alirezaaies/es-ac-load-cycler/docs/relay_on_duration_report.tex

% !TeX program = xelatex
% گزارش مرجع سامانه پایش و کنترل اتاق آزمون
\documentclass[12pt,a4paper,oneside]{report}

\input{report-config}

\begin{document}

\pagenumbering{alph}
\input{chapters/00-title}
\tableofcontents
\clearpage
\pagenumbering{arabic}

\input{chapters/01-overview}
\input{chapters/02-hardware-cubemx}
\input{chapters/03-software-architecture}
\input{chapters/04-drivers-and-modules}
\input{chapters/05-runtime-control}
\input{chapters/06-serial-protocol}
\input{chapters/07-code-audit}
\input{chapters/08-build-programming}
\input{chapters/09-verification-maintenance}
\input{chapters/10-application-function-reference}
\input{chapters/11-driver-function-reference}
\input{chapters/12-refactoring-details}
\input{chapters/13-generated-code-reference}
\input{chapters/14-diagnostic-led-test}
\input{chapters/15-ade7880-integration}
\input{chapters/16-ds18b20-stable-numbering}
\input{chapters/17-character-lcd-buttons}
\input{chapters/18-load-cycler}

\end{document}
