alirezaaies/es-ac-load-cycler/PROJECT_STATUS.md

# وضعیت توسعه و حافظه ادامه پروژه

آخرین به‌روزرسانی: ۱۱ مهر ۱۴۰۵ — 2026-10-03، منطقه زمانی Asia/Tehran.

این فایل حافظه عملیاتی کل پروژه است و در ریشه مخزن نگه‌داری می‌شود. باید در پایان هر نوبت تغییر کد، سخت‌افزار یا مستندات به‌روزرسانی شود. عامل انسانی یا هوش مصنوعی بعدی باید پیش از کار، این فایل را کامل بخواند. README معرفی و راه‌اندازی سریع است؛ این فایل تاریخچه تصمیم‌ها، وضعیت اعتبارسنجی و کارهای باز را نگه می‌دارد.

از تاریخ 2026-09-19 مخزن از یک پروژه صرفاً فریم‌ور به مخزن یکپارچه محصول تبدیل شده است. مسیرهای کوتاه فریم‌ور در بخش‌های تاریخی این فایل، مانند `Core/` و `Application/`، نسبت به `embedded/stm32f107/` تفسیر می‌شوند؛ `docs/`، `datasheets/` و `hardware/` نسبت به ریشه مخزن هستند.

## هدف ثابت پروژه

ساخت یک پایه فریم‌ور قابل استفاده مجدد برای STM32F107VCT6 که هم‌زمان با STM32CubeMX، Keil MDK و PlatformIO قابل توسعه باشد. تولید مجدد CubeMX نباید منطق محصول را پاک کند. محصول فعلی اتاق آزمون تجهیزات برودتی را پایش و کنترل می‌کند: ۳۲ حسگر دمای ایستگاه، دو حسگر دمای محیط، حسگر رطوبت آنالوگ HIH، مدار انرژی ADE7880، ارتباط RS-232 و خروجی‌های رله/SSR.

## قواعد غیرقابل نقض ادامه کار

1. منطق محصول در فایل‌های مستقل باقی بماند؛ فایل مولد فقط داخل USER CODE block تغییر کند.
2. ISR فقط کار ثابت و کوتاه انجام دهد؛ I/O مسدودکننده، محاسبه سنگین و Flash داخل ISR ممنوع است.
3. صفحه `0x0803F800` تا انتهای Flash متعلق به داده حسگر است و نباید لینک شود.
4. قالب سریال قدیمی بدون نسخه‌بندی و هماهنگی نرم‌افزار PC تغییر نکند.
5. هر تغییر باید با build مناسب و در صورت ارتباط با ظاهر، رندر PDF بررسی شود.
6. نتیجه کامپایل جای آزمون سخت‌افزاری را نمی‌گیرد.
7. در پایان هر نوبت، بخش «آخرین نوبت کار» و «کارهای باز» همین فایل به‌روزرسانی شود.
8. تمام APIهای عمومی جدید با Doxygen انگلیسی شامل هدف، پارامتر، خروجی و خطا مستند شوند؛ ثابت سخت‌افزاری باید واحد و علت داشته باشد.

## وضعیت جاری و نقطه تحویل برای ادامه فردا

این بخش مرجع نسخه فعال است؛ یادداشت‌های مراحل پیشین پایین فایل تاریخچه‌اند و ممکن است رفتار قدیمی را شرح دهند. تاریخ تحویل: ۱۱ مهر ۱۴۰۵، برابر با 2026-10-03؛ نوبت بعدی موردنظر کاربر: 2026-10-04.

### نتیجه تأییدشده امروز

- کاربر عملکرد منوها، نمایشگر، کلیدها، رله‌ها و خواندن/نمایش پارامترهای الکتریکی را روی برد تأیید کرد. مشکل نمایش خط تیره سخت‌افزاری بود و توسط کاربر حل شد؛ جزئیات قطعه یا سیم‌بندی معیوب اعلام نشده است.
- هر دو رله active-low هستند: PE1 نول و PE2 فاز؛ LOW=وصل، HIGH=قطع. نوشتن همزمان BSRR و سطح اولیه HIGH در adapter و CubeMX اعمال شده است.
- آخرین کامیت عملکردی پیش از تکمیل مستندات `6aa787e` است؛ مرجع ادامه همیشه HEAD نهایی همین مخزن روی `main` است. `origin` برای مخزن GitHub تنظیم است؛ عامل در این جلسه پوش انجام نمی‌دهد.
- ساخت تأییدشده: PlatformIO با `-Wall -Wextra -Werror`، Flash=16184 bytes و RAM=1056 bytes. دو آزمون واقعی ARM برای سیکل و مسیر الکتریکی موفق‌اند. تأیید سخت‌افزار، گزارش کاربر است؛ ابزار عامل به برد متصل نیست.
- گزارش مرجع `docs/relay_on_duration_report.pdf` و سورس همنام است؛ نسخه ۱.۱، ۹۷ صفحه A4. فصل ۱۸ مرجع برنامه فعال، فصل ۱۷ مرجع کتابخانه LCD و تست اولیه، فصل ۱۵ مرجع ADE و فصل ۱۶ مرجع کتابخانه دماست.

### توالی منو و اجرای تست

۱. بوت: Welcome و سپس www.agfaco.com هر کدام دو ثانیه؛ سپس صفحه اصلی Idle. تعداد پیش‌فرض صفر، روشن سه و خاموش دو ثانیه؛ خروجی‌ها قطع‌اند.
۲. نگه‌داشتن کلید ۳ روی PD11 به مدت سه ثانیه، تنظیم تعداد را باز می‌کند؛ ورود به تنظیمات تست جاری را متوقف و رله‌ها را قطع می‌کند.
۳. کلید ۱/PD9 افزایش و کلید ۲/PD10 کاهش می‌دهد. بازه تعداد ۰ تا ۱۰۰۰۰۰ و زمان روشن/خاموش ۰ تا ۳۰۰ ثانیه، هر دو سر شامل هستند و تغییرات مدولار دور می‌زنند.
۴. تک‌فشار یک واحد؛ نگه‌داشتن پس از ۵۰۰ ms با فاصله ۱۲۰ ms تکرار می‌کند. ۲۰ تغییر نخست شامل فشار اولیه یک‌واحدی، سپس پنج‌واحدی؛ فشار تازه شتاب را از ابتدا آغاز می‌کند. debounce فشار/رهاسازی ۳۰ ms است.
۵. فشار کوتاه کلید ۳ هنگام رهاسازی تأیید می‌شود: تعداد → زمان روشن → زمان خاموش → Settings saved. سه مقدار فقط در تأیید مرحله آخر یکجا از draft به settings اعمال می‌شوند.
۶. نگه‌داشتن کلید ۳ در هر مرحله تنظیمات همه تغییرات موقت را لغو می‌کند و تست با تنظیمات قبلی از سیکل یک شروع می‌شود؛ ادامه از وسط سیکل قبل وجود ندارد.
۷. فشار کوتاه بعد از پیام ذخیره، تست جدید را شروع می‌کند. تنظیمات در RAM هستند و پس از reset/قطع تغذیه به پیش‌فرض برمی‌گردند.
۸. هر سیکل ON سپس OFF است؛ شماره از ۱ تا تعداد بالا می‌رود، زمان هر مرحله معکوس است. بعد از آخرین OFF، خروجی‌ها قطع و Done نمایش داده می‌شود؛ شمارنده اضافه نمی‌شود.
۹. تعداد صفر تست ندارد؛ ON صفر هیچ پالس وصلی ندارد؛ OFF صفر فقط گذار سریع خروجی دارد و قطع مکانیکی زمان‌دار تضمین نمی‌شود؛ هر دو زمان صفر پایان فوری دارند.

### نمایش فعلی و محل تغییر آینده

```text
V230.1P9999T   1
A 12.3PF0.98*  3
```

- V و A یک رقم اعشار، P بدون اعشار، PF قدرمطلق با دو رقم اعشار؛ واحدهای واقعی V/A/W و فاز پیش‌فرض A است. مقادیر راست‌چین‌اند. `*` وصل و `-` قطع؛ زمان سه‌رقمی و شماره سیکل افزایشی است.
- شماره‌های بزرگ‌تر از ۹۹۹۹ به‌شکل شش‌رقمی در ستون راست دو سطر تقسیم می‌شوند؛ `T0010` و `C 00` یعنی ۰۰۱۰۰۰. ادامه شماره هر دو ثانیه با زمان/Done نوبتی می‌شود؛ ستون‌های اندازه‌گیری ثابت می‌مانند.
- اعداد بزرگ با کاهش اعشار و سپس k/M/G فشرده می‌شوند. `--` داده نامعتبر/کهنه/ارتباط قطع است؛ صفر معتبر به‌صورت عدد نمایش داده می‌شود.
- تغییر ظاهر: `Application/Src/ui_counter.c`، تابع `compose()` ساخت دو سطر و `number()` قالب عدد. گزینه‌ها در `Application/Inc/cycler_config.h`؛ نام ui_counter تاریخی است ولی اکنون برنامه کامل سیکل را دارد.
- PA6=E، PA7=RW، PA8=RS، PA9..PA12=D4..D7. کلیدها active-high هستند. PC13/PC14 همواره یکی‌درمیان کار می‌کنند، حتی در خطای ADE.

### مسیر پردازش و متغیرهای Watch

- `main.c` فقط HAL/CubeMX و App را اجرا می‌کند؛ منطق محصول در Application است. همه کتابخانه‌ها حفظ شده‌اند؛ دما قبلاً توسط کاربر آزموده شده ولی در کاربرد فعلی `CYCLER_ENABLE_TEMPERATURE=0` است. رطوبت و UART به این کاربرد وصل نیستند.
- ADE: PB12=CS و PB13/PB14/PB15=SPI2؛ Mode 3، نرخ 562.5 kbit/s. همه فازها و نول هر ثانیه خوانده می‌شوند؛ retry دو ثانیه، انتقال HAL polling با سقف ۲۰ ms و startup ماشین حالت است. LCD مکث میکروثانیه‌ای لازم دارد؛ معماری cooperative است، نه تضمین زمان واقعی سخت.
- برای فاز A: `g_app_electrical.voltage_v[0]`، `current_a[0]`، `active_power_w[0]`، `power_factor_abs[0]`؛ PF علامت‌دار در `power_factor[0]`. اندیس ۱ و ۲ فاز B و C هستند.
- تشخیص ارتباط: `online`، `successful_samples`، `updated_at_ms`، `last_status`، `last_error_status`، `startup_attempts`، `startup_errors`، `startup_stage`، `failed_startup_stage` و `communication_errors` زیر `g_app_electrical`؛ جزئیات در LOAD_CYCLER.md و فصل ۱۸.
- نمایش عدد نیازمند online، نمونه جدیدتر از سه ثانیه و پرچم اعتبار هر کمیت است. آخرین خطا پس از موفقیت پاک نمی‌شود؛ برای وضعیت جاری، online و شمار نمونه‌ها هم بررسی شوند.
- ضرایب کالیبراسیون و صفحه رزروشده نگاشت دما در Flash حفظ شدند؛ تأیید کارکرد فعلی معادل تأیید دقت آزمایشگاهی همه کانال‌ها نیست.

### شروع نوبت بعد و کارهای باز

۱. ابتدا همین بخش و فصل ۱۸ گزارش را بخوانید؛ کارکرد فعلی روی برد تأیید شده و نیازی به بازسازی منو از ابتدا نیست.
۲. کار بعدی احتمالی تغییر ظاهر است؛ منتظر طرح/درخواست کاربر بمانید و سپس compose/number یا ثابت‌های نمایش را اصلاح کنید. رفتار منو و رله را بدون درخواست تغییر ندهید.
۳. بعد از تغییر ظاهر، آزمون‌های ARM و build را اجرا و خروجی مورد انتظار LCD را با طرح جدید هماهنگ کنید؛ سپس روی برد بررسی شود.
۴. موضوعات مستقل باقی‌مانده: ذخیره دائمی تنظیمات در صورت درخواست، کالیبراسیون ابزارمرجع کانال‌های استفاده‌شده، آزمون طولانی‌مدت، ساخت واقعی Keil و بررسی صنعتی watchdog/رفتار خطا. این‌ها مانع تأیید کارکرد فعلی نیستند و در این نوبت اجرا نشده‌اند.
۵. جزئیات رفع مشکل سخت‌افزار، نگاشت دقیق کانال‌ها و نتایج اندازه‌گیری دقت در صورت اعلام کاربر ثبت شوند؛ حدس جای نتیجه ثبت‌شده ننشیند.

### فایل‌ها و فرمان‌های اصلی

- راهنمای کوتاه: `embedded/stm32f107/LOAD_CYCLER.md`؛ وضعیت ادامه: همین فایل؛ گزارش کامل: `docs/relay_on_duration_report.tex` و PDF همنام.
- ساخت: `& "$env:USERPROFILE/.platformio/penv/Scripts/platformio.exe" run -d embedded/stm32f107`.
- آزمون‌ها: `python embedded/stm32f107/tests/test_cycler.py` و `python embedded/stm32f107/tests/test_electrical.py`؛ نیازمند Python unicorn و ARM GCC نصب‌شده PlatformIO.
- گزارش: دو گذر XeLaTeX از پوشه docs؛ رندر صفحات و بازبینی ظاهر پس از تغییر گزارش.

## Historical handoff before the load-cycler application

The following snapshot is preserved as history; use the current handoff above.

## وضعیت جاری نسخه نهایی این مرحله

### نقطه تحویل سریع

- شاخه فعال `main` است و baseline قابل ادامه همیشه commit رأس `HEAD` است؛ commit `44b330a` نقطه شروع ریفکتور ساده‌سازی این نوبت بود.
- مخزن remote ندارد و تا این نقطه چیزی به GitHub ارسال نشده است.
- مسیر ساده دما آماده است: برای حسگر شماره `N` فقط `g_temperature_valid[N-1]` و `g_temperature_c[N-1]` بررسی می‌شوند؛ هیچ تابعی نباید از Debugger فراخوانی شود.
- کشف نخست هنگام شروع، کشف‌های بعدی هر پنج ثانیه و ثبت ROM تازه در اولین شماره خالی خودکار است. نگاشت در Flash می‌ماند.
- نمایشگر ۲×۱۶ چهار بیتی روی `PA6..PA12` و سه کلید وقفه‌ای بدون جهش روی `PD9..PD11` پیاده‌سازی شده‌اند. تست شمارنده صفر تا صد فعال است و `g_ui_counter_value` در Watch دیده می‌شود.
- آخرین ساخت تأییدشده PlatformIO برابر `Flash=16560 bytes` و `RAM=3292 bytes` است. پروژه Keil از نظر XML و عضویت فایل‌های LCD معتبر است، ولی build همین نسخه با Keil هنوز روی ایستگاه دارای Keil تکرار نشده است.
- گزارش فنی این مرحله ۹۰ صفحه A4 است و فصل ۱۷ راه‌اندازی، API، debounce، انتقال و آزمون LCD را پوشش می‌دهد.
- کد و مستندات آماده آزمون روی برد هستند؛ سطح منطقی LCD پنج‌ولتی، عملکرد فیزیکی LCD/کلیدها، DS18B20، کالیبراسیون ADE7880 و DRC تازه هنوز باید تأیید شوند.

### شروع پیشنهادی نوبت بعد

1. ابتدا حاشیه سطح منطقی LCD بررسی شود: این مدل در ۵ ولت `VIH(min)=3.5V` دارد و خروجی ۳٫۳ ولتی STM32 تضمین‌شده نیست؛ مبدل سطح یا شرایط ۳٫۳ ولتی معتبر لازم است.
2. Firmware پروگرام و متن LCD، یک‌رخدادی‌بودن هر کلید، حدود صفر/صد، reset و نبود چشمک صفحه در کنار ادامه الگوی LED آزموده شود.
3. سپس سنسور شماره ۱ به‌تنهایی وصل شود؛ در Watch باید تقریباً پس از یک ثانیه `g_temperature_valid[0]=true` و `g_temperature_c[0]` معتبر شود.
4. سنسورهای بعدی یک‌به‌یک اضافه و خاموش/روشن کامل، پایداری شماره‌ها و تعویض یک سنسور روی همان bus ثبت شود.
5. پس از پذیرش مستقل رابط کاربر و دما، مرحله بعد از فهرست کارهای باز انتخاب شود.

### چیدمان مخزن یکپارچه

- ریشه Git: `E:/projects/es-ac-load-cycler` روی شاخه اصلی `main`؛ آخرین baseline عملکردی فعلی `44b330a` است. remote برای مخزن تعریف نشده و چیزی به GitHub ارسال نشده است.
- فریم‌ور STM32F107 در `embedded/stm32f107/` قرار دارد. تطبیق ۱۴۶ فایل انتقال‌یافته و `.gitignore` مربوط به زمان انتقال در تاریخچه ثبت شده است؛ مخزن اکنون پس از افزوده‌شدن زیرسامانه دما در مجموع ۱۶۸ فایل track‌شده دارد.
- سخت‌افزار Altium: `hardware/altium/` شامل پروژه `PCB_Project.PrjPcb`، هفت شماتیک و PCB اصلی `MainPCB.PcbDoc`.
- مستندات محصول: `docs/` و دیتاشیت‌ها: `datasheets/` در ریشه مخزن.
- `PROJECT_STATUS.md` از پوشه فریم‌ور به ریشه منتقل شده، چون اکنون وضعیت نرم‌افزار، سخت‌افزار و ساختار کل محصول را ثبت می‌کند.
- مستندات و دیتاشیت‌ها فقط در `docs/` و `datasheets/` ریشه نگه‌داری می‌شوند؛ نسخه‌های تکراری زیر فریم‌ور پس از تطبیق فایل‌به‌فایل و SHA-256 حذف شده‌اند.
- `.gitignore` با ساختار تو‌در‌توی جدید هماهنگ است و خروجی‌های PlatformIO، Keil، LaTeX و QA را در هر عمق نادیده می‌گیرد. History، preview، log، گزارش تولیدی و وضعیت محلی Altium نیز وارد Git نمی‌شوند.
- فایل‌های اصلی Altium شامل `PrjPcb`، `SchDoc`، `PcbDoc`، `PcbLib` و `IntLib` در Git نگه‌داری می‌شوند؛ وابستگی‌های کتابخانه‌ای محیط طراحی توسط مالک سخت‌افزار مدیریت می‌شوند.

### نتیجه ممیزی انتقال

- مخزن قدیمی در `E:/projects/RelayOnDuration/embedded/software/Main/Main` فقط مرجع تاریخی زمان انتقال با commit `06a2a2f` است؛ ادامه کار باید منحصراً در مخزن یکپارچه فعلی انجام شود.
- هیچ مخزن Git تودرتویی داخل `embedded/` یا `hardware/` وجود ندارد؛ تنها `.git` معتبر در ریشه پروژه جدید است.
- build PlatformIO پس از ریفکتور رابط زیرسامانه دما با `-Wall -Wextra -Werror` موفق شد: ۱۴۹۲۸ بایت Flash و ۳۲۰۴ بایت RAM.
- `pio` در PATH نیست، اما executable محلی `%USERPROFILE%/.platformio/penv/Scripts/platformio.exe` موجود و قابل استفاده است.
- پروژه Altium همه هفت `SchDoc` و فایل `MainPCB.PcbDoc` اصلی را پیدا می‌کند، اما self-contained نیست: ارجاع‌های `../../ADE7880/ADE7880ACPZ.PcbLib`، `../../ADE7880/ADE7880ACPZ.SchLib` و `../lib/PCB_Project.SCHLIB` در مخزن موجود نیستند. چند کتابخانه دیگر نیز از مسیر بیرون مخزن روی همین سیستم resolve می‌شوند و روی سیستم دیگر تضمین‌شده نیستند.
- آخرین گزارش DRC موجود با تاریخ 2026-09-12 دارای ۵ violation است: دو clearance با فاصله 0.19 mm در برابر حد 0.2 mm و سه Net Antennae. این گزارش مسیر مطلق قدیمی `E:/projects/new/hardware/VER3/EDIT1/MainPCB.PcbDoc` را در خود دارد و باید پس از بازکردن پروژه از محل جدید دوباره تولید شود.
- پوشه‌های `History`، `__Previews` و `Project Logs...` خروجی/حافظه محلی Altium هستند؛ روی دیسک باقی می‌مانند ولی در `.gitignore` پوشش داده شده‌اند و نباید وارد commit شوند.
- فایل `hardware/altium/MainPCB.PcbLib` صفر بایت است؛ چون `MainPCB1.PcbLib` و `PcbLib1.PcbLib` نیز موجودند، حذف یا جایگزینی آن بدون بررسی داخل Altium مجاز نیست.

- مسیر اجرایی فعال عمداً کوچک است: `Core/Src/main.c` فقط HAL/CubeMX را راه می‌اندازد و `App_Init()` و `App_Process()` را فراخوانی می‌کند.
- `Application/Src/app.c` adapter برد برای ADE7880 و DS18B20 است و پایه‌ها، زمان، Flash، نمونه‌برداری، کالیبراسیون و وضعیت قابل مشاهده در دیباگر را مدیریت می‌کند.
- `Application/Src/diagnostic_led.c` روی PC13/PC14 بدون توقف حلقه، زنده‌بودن برنامه یا خطای ارتباط ADE7880 را نشان می‌دهد.
- `Libraries/ADE7880` یک درایور مستقل از MCU است؛ انتقال SPI، CS و delay فقط از callback دریافت می‌شوند و نمونه سراسری داخل کتابخانه وجود ندارد.
- `Libraries/OneWire`، `Libraries/DS18B20` و `Libraries/DS18B20Manager` مستقل از HAL هستند؛ Search ROM، CRC، فرمان حسگر، شماره‌گذاری پایدار و ماشین حالت خواندن را فراهم می‌کنند.
- گذرگاه دمای صفر روی `PB10` و گذرگاه یک روی `PC7` است. نگاشت شماره منطقی ۱ تا ۳۲ به زوج bus/ROM با CRC32 در صفحه رزروشده Flash نگه‌داری می‌شود.
- `g_temperature_c[N-1]` و `g_temperature_valid[N-1]` رابط ساده Watch سنسور شماره `N` هستند؛ ساختار مدیر و APIهای تعمیراتی از هدر عمومی برنامه پنهان‌اند.
- `g_app_electrical` رابط اصلی Watch است. اندیس‌های `0`، `1` و `2` به‌ترتیب فازهای A، B و C هستند؛ جریان نول فیلد مستقل دارد.
- همه‌ی فازها برای ولتاژ RMS، جریان RMS، توان اکتیو، توان ظاهری و PF خوانده می‌شوند. جدول پیش‌فرض A/B/C/N در ابتدای `Application/Src/app.c` قرار دارد.
- کالیبراسیون هر کمیت و هر فاز مستقل است. `App_Init()` همیشه پیش‌فرض‌ها را نصب می‌کند؛ تغییرهای runtime فقط در RAM هستند و پس از reset از بین می‌روند.
- خواندن مستقل دمای DS18B20 اکنون فعال است؛ رطوبت، UART، کنترل محصول و اتصال دما به قاب سریال هنوز به snapshot اجرایی وصل نیستند. تاریخچه پایین فایل نباید با کد فعال اشتباه شود.
- `docs/relay_on_duration_report.tex` و PDF همنام آن مرجع کامل ساخت، پروگرام، تست و کالیبراسیون هستند.

## تصمیم‌های فنی ثبت‌شده

- اتصال ADE7880: `PB12=CS`، `PB13=SCK`، `PB14=MISO` و `PB15=MOSI`. رابط SPI2 در Mode 3، هشت‌بیتی، MSB-first و با نرخ فعلی 562.5 kbit/s کار می‌کند.
- بازه‌ی خواندن عادی یک ثانیه و بازه‌ی تلاش مجدد پس از خطا دو ثانیه است. هر snapshot فقط پس از خواندن کامل به وضعیت عمومی منتشر می‌شود.
- PC13 و PC14 خروجی پوش‌پول کم‌سرعت و به‌طور پیش‌فرض LED فعال‌پایین هستند؛ `DIAGNOSTIC_LED_ACTIVE_LOW` قطب را تغییر می‌دهد.
- ضرایب A و B از نرم‌افزار قدیمی بازیابی شده‌اند. چون داده مرجع فاز C وجود نداشت، C موقتاً از ضرایب B/مشترک و نول از scale جریان فاز شروع می‌شود؛ این fallback تأیید دقت نیست.
- `valid` فقط موفقیت ارتباط و موجودبودن تبدیل را بیان می‌کند. `source` مشخص می‌کند ضریب `APP_CALIBRATION_DEFAULT` یا `APP_CALIBRATION_USER` است.
- مقادیر SI در آمپر، وات و ولت‌آمپر نگه‌داری می‌شوند. نمایش قدیمی به‌طور پیش‌فرض صدم‌آمپر و دهم‌وات است و با `App_SetDisplayUnits()` تغییر می‌کند.
- APIهای `App_SetPhaseCalibration()`، `App_CalibratePhaseMultiPoint()` و `App_CalibrateNeutralCurrentMultiPoint()` هر خانه را مستقل تغییر می‌دهند. `App_ResetCalibrationToDefaults()` همه‌ی overrideهای RAM را حذف می‌کند.
- جهت CT با `App_SetCurrentPolarity()` اصلاح می‌شود. تشخیص خودکار انجام نمی‌شود، چون توان منفی می‌تواند صادرات واقعی انرژی باشد.
- PlatformIO از board رسمی `eval_f107vc`، STM32Cube و J-Link استفاده می‌کند. Keil از پروژه‌ی `MDK-ARM/STM32F107.uvprojx` استفاده می‌کند.
- فایل قابل‌حمل پروژه Keil یعنی `.uvprojx` در Git است؛ فایل شخصی محیط کاربر یعنی `.uvoptx` عمداً ignore می‌شود. خروجی‌های `.pio`، Keil و LaTeX نیز ignore هستند و فقط PDF نهایی گزارش track می‌شود.
- DS18B20 با تغذیه خارجی سه‌سیمه فرض شده است؛ parasite power و strong pull-up پیاده نشده‌اند. زمان تبدیل ۱۲ بیت ۷۵۰ میلی‌ثانیه است، ولی انتظار آن با ماشین حالت انجام می‌شود.
- Search ROM نخست بلافاصله و سپس هر پنج ثانیه اجرا می‌شود. ROM تازه خودکار به اولین slot خالی می‌رود؛ جایگزینی خودکار صرفاً برای یک missing و یک ROM جدید روی همان bus مجاز است.
- ثبت خودکار یا تعویض Flash را فقط هنگام تغییر نگاشت می‌نویسد، نه در نمونه‌برداری عادی. فرمت قدیمی به‌سبب نداشتن شماره bus خودکار مهاجرت داده نمی‌شود.

## نوبت اول کار — بازآرایی پایه

انجام‌شده:

- خواندن همه سورس‌ها، IOC، پروژه Keil، map و build log قدیمی.
- انتقال منطق از main و فایل وقفه به app.
- تبدیل تایمرها به پرچم و اجرای کارها در حلقه اصلی.
- اصلاح دریافت UART و حذف دسترسی مستقیم و دوباره به هندلر.
- فشرده‌سازی ساخت قاب ۲۰۹ بایتی با آرایه و حلقه.
- اصلاح ذخیره آدرس‌ها، خروج از محدوده آرایه و خطر هم‌پوشانی Flash.
- افزودن linker script، PlatformIO و J-Link.
- رزرو IROM Keil تا اندازه 0x3F800 و افزودن فایل‌های جدید به پروژه.
- ایجاد گزارش اولیه، README و چک‌لیست آزمون.
- build موفق PlatformIO و ساخت PDF موفق.

## نوبت دوم کار — تکمیل مستندات و خوانایی

درخواست کاربر: فاصله خطوط بیشتر، تشریح کامل کد و توابع، کامنت‌گذاری معنادار و فایل وضعیت مستقل از README.

انجام‌شده در این نوبت:

- افزودن بسته `setspace` و افزایش فاصله خطوط متن گزارش به ۱٫۴۵.
- افزایش فاصله پاراگراف‌ها از ۵ به ۸ پوینت و فاصله سطرهای جدول به ۱٫۳۳.
- افزودن فصل مرجع کامل توابع لایه کاربرد شامل ورودی، خروجی، اثر جانبی، زمینه اجرا و محدودیت‌ها.
- افزودن فصل مرجع کامل ذخیره‌سازی، ADE7880، DS18B20، AM2315 و MAF.
- افزودن فصل جزئیات بازآرایی با مقایسه معماری پیش و پس از تغییر.
- افزودن فصل توابع تولیدی main، راه‌اندازی همه پیرامونی‌ها، MSP، ISR، فایل سامانه و startup.
- تکمیل کامنت‌های Doxygen در `app.h`، `sensor_address_store.h`، `ADE7880.h`، `DS18B20.h`، `AM2315.h` و `MAF.h`.
- افزودن توضیح توابع داخلی و بخش‌های حساس در فایل‌های پیاده‌سازی.
- ایجاد همین فایل مستقل `PROJECT_STATUS.md` و افزودن الزام به‌روزرسانی آن در هر نوبت.

## اعتبارسنجی ثبت‌شده در نوبت دوم

- ساخت تازه PlatformIO با موفقیت کامل شد: ۲۰۷۹۶ بایت Flash معادل ۷٫۹ درصد و ۱۲۴۰ بایت RAM معادل ۱٫۹ درصد.
- فایل‌های پروژه و تنظیمات Keil از نظر XML دوباره بررسی شدند و معتبرند؛ خود Keil در این محیط نصب نیست و build با کامپایلر Keil همچنان باید روی ایستگاه توسعه انجام شود.
- گزارش تازه با XeLaTeX در دو گذر ساخته شد: ۴۸ صفحه A4، بدون خطا، نویسه مفقود، ارجاع حل‌نشده یا اخطار overfull/underfull.
- همه ۴۸ صفحه ابتدا در چهار تماس‌برگ و سپس صفحه‌های شاخص شامل جلد، متن متراکم و فصل‌های مرجع در اندازه اصلی بازبینی شدند؛ برش متن، هم‌پوشانی، خرابی راست‌به‌چپ یا شکست نامناسب عنوان مشاهده نشد.
- متن فصل‌های تازه برای جلوگیری از واژه انگلیسی بدون `\lr{}` و نویسه اعشاری ناسازگار اسکن شد.
- آزمون‌های سخت‌افزاری زیر هنوز انجام نشده‌اند و نتیجه build به معنی تأیید رفتار روی برد نیست.

## نوبت سوم کار — نشانگر سخت‌افزاری زنده‌بودن

درخواست کاربر: استفاده از دو LED متصل به PC13 و PC14 برای رقص نور، آزمون پروگرام، مشاهده اجرای مداوم برنامه و تشخیص گیرکردن حلقه اصلی.

انجام‌شده:

- ثبت PC13 و PC14 در `STM32F107.ioc` با نام‌های `DEBUG_LED_1` و `DEBUG_LED_2`، خروجی پوش‌پول کم‌سرعت و سطح اولیه بالا.
- همگام‌سازی `MX_GPIO_Init` فعلی با تنظیم CubeMX برای جلوگیری از اختلاف تا زمان تولید مجدد.
- ایجاد ماژول مستقل `diagnostic_led.c/.h` با چهار حالت خاموش، ضربان، رقص و خطا.
- پیاده‌سازی زمان‌بندی کاملاً غیرمسدودکننده با `HAL_GetTick` و بدون `HAL_Delay`.
- فراخوانی `DiagnosticLed_Process` در ابتدای `App_Process`؛ توقف حلقه اصلی باعث ثابت‌شدن الگو می‌شود.
- انتخاب الگوی رقص به‌عنوان حالت عادی و تناوب سریع به‌عنوان الگوی `Error_Handler`.
- افزودن فایل ماژول به پروژه Keil؛ PlatformIO آن را از پوشه `Core/Src` به‌طور خودکار می‌سازد.
- افزودن فصل ۱۴ گزارش شامل اتصال، قطب فعال، API، الگوها، پروگرام J-Link و تفسیر آزمون.

اعتبارسنجی نرم‌افزاری این نوبت:

- ساخت PlatformIO موفق است: ۲۱۳۶۰ بایت Flash معادل ۸٫۱ درصد و ۱۲۴۸ بایت RAM معادل ۱٫۹ درصد.
- فایل‌های `STM32F107.uvprojx` و `STM32F107.uvoptx` از نظر XML معتبرند؛ build واقعی Keil هنوز در این محیط انجام نشده است.
- گزارش نهایی این نوبت در دو گذر XeLaTeX و در ۵۴ صفحه A4 ساخته شد؛ هیچ خطا، نویسه مفقود یا هشدار overfull/underfull ندارد.
- همه ۵۴ صفحه در تماس‌برگ و پنج صفحه تغییرکرده فصل چراغ در اندازه اصلی بازبینی شدند و نقص چیدمان مشاهده نشد.
- پروگرام واقعی با J-Link و SWD موفق بود: پروگرامر و STM32F107VC شناسایی شدند، ولتاژ مرجع ۳٫۳۲۵ ولت بود، Flash پاک، نوشته و Verify شد و میکرو در پایان Reset شد.
- مشاهده فیزیکی LEDها و تأیید قطب و ترتیب نور همچنان به بازخورد کاربر نیاز دارد.

## کارهای باز تاریخی پیش از تأیید نسخه سیکل

این فهرست متعلق به مرحله پیشین است؛ اولویت‌های فعال در بخش «شروع نوبت بعد و کارهای باز» ابتدای فایل آمده‌اند. کارکرد نمایشگر، کلیدها، رله‌ها و اندازه‌گیری اکنون توسط کاربر تأیید شده است؛ نتیجه آزمون‌های دقیق تعداد فشار، مدت طولانی یا دقت آزمایشگاهی هنوز جداگانه ثبت نشده است.

1. حاشیه منطقی LCD پنج‌ولتی اصلاح/تأیید و سپس توالی راه‌اندازی، کنتراست، سیم‌بندی `DB4..DB7` و نمایش پایدار متن روی برد آزموده شود.
2. هر کلید دست‌کم ۵۰ بار، نگه‌داشتن طولانی، حدود صفر/صد و reset آزموده شود؛ هم‌زمان ادامه چشمک LED، نمونه‌برداری ADE7880 و دما کنترل شود.
3. DS18B20 روی هر دو گذرگاه با سنسور و کابل واقعی آزموده شود: کشف، CRC، دمای مثبت/منفی، خاموش/روشن کامل و ثبات شماره‌ها.
4. شماره‌گذاری خودکار یک‌به‌یک و سناریوهای تعویض «یک missing/یک new» و حالت مبهم چند سنسور روی برد ثبت شوند. مقاومت pull-up و شکل موج دورترین سنسور با تعداد نهایی بررسی شود.
5. پنج violation گزارش DRC سخت‌افزار بررسی و پس از اصلاح یا waiver مستند، گزارش تازه از مسیر جدید تولید شود.
6. نگاشت واقعی ورودی‌های A/B/C/N روی برد با شماتیک یا تزریق کنترل‌شده تأیید شود؛ fallback فاز C و نول هنوز کالیبراسیون آزمایشگاهی نیست.
7. برای هر فاز مورد استفاده، ولتاژ، جریان، توان اکتیو و توان ظاهری با ابزار true-RMS/وات‌متر معتبر در دست‌کم سه نقطه اندازه‌گیری و با API چندنقطه‌ای کالیبره شوند.
8. خطای فاز CT نزدیک PF حدود 0.5 و خطای offset در بار کم بررسی شود. در صورت باقی‌ماندن خطای سیستماتیک، رجیسترهای phase/offset خود ADE7880 طبق دیتاشیت تنظیم شوند.
9. ضرایب تأییدشده با version و اعتبارسنجی در Flash ذخیره شوند یا پس از تثبیت سخت‌افزار به‌عنوان ثابت‌های startup جایگزین شوند؛ اکنون تغییرهای runtime پایدار نیستند.
10. آزمون ۲۴ ساعته، قطع/وصل ADE7880 و DS18B20، خاموش/روشن کامل برد، تغییر دما و تکرار بار کم/نامی/زیاد انجام شود.
11. پیش از کاربرد صنعتی، watchdog، ثبت علت خطا و رفتار ایمن خروجی‌ها طراحی و روی سخت‌افزار آزمایش شود.
12. برای CharacterLcd، منطق debounce، OneWire/DS18B20/manager و نیز تبدیل raw، برازش کالیبراسیون، sign-extension و خطاهای transport تست میزبان افزوده شود.
13. زیرسامانه‌های سریال، رطوبت و کنترل فقط هنگام تعریف مرحله بعد و با آزمون مستقل، یکی‌یکی به runtime برگردند.

## اطلاعاتی که برای ادامه بدون حدس لازم است

- شماتیک بخش ADE7880 و نگاشت دقیق کانال‌های A/B/C/N.
- مدل و نسبت CT/PT، مقدار burden و شبکه تقسیم/فیلتر هر ورودی.
- ولتاژ، جریان و توان نامی و بیشینه‌ی مجاز و این‌که اندازه‌گیری توان یک‌طرفه است یا دوطرفه.
- جدول اندازه‌گیری مرجع شامل raw میانگین و مقدار واقعی برای هر نقطه و هر فاز.
- تصمیم درباره محل نگه‌داری ضرایب نهایی: ثابت‌های firmware یا Flash قابل‌به‌روزرسانی.
- تعداد نهایی سنسورها روی هر bus، طول و توپولوژی کابل و ولتاژ pull-up برای پذیرش سخت‌افزاری مسیر دما.
- برای بازگرداندن قابلیت‌های قدیمی محصول: نام واقعی خروجی‌ها، محدودیت‌های ایمنی و مشخصات پروتکل PC.

## نوبت چهارم کار — ارتباط ADE7880 روی پایه تمیز

درخواست کاربر: بازیابی پایه‌های قدیمی، ثبت پایدار تنظیمات در CubeMX، ساخت کتابخانه مستقل و قابل استفاده مجدد، خواندن پارامترهای الکتریکی همراه با LED عیب‌یابی، گزارش کامل و commitهای مرحله‌ای.

انجام‌شده:

- ایجاد نخستین baseline مخزن با commit `fe4322c`؛ پیش از آن مخزن هیچ commit نداشت.
- اصلاح `.gitignore` برای حذف خروجی‌های PlatformIO/Keil/LaTeX و نگه‌داری عمدی PDF نهایی گزارش.
- بازیابی اتصال از فایل پشتیبان پروژه و سه منبع مستقل: `PB12=CS`، `PB13=SCK`، `PB14=MISO` و `PB15=MOSI`.
- تأیید تنظیم قدیمی و دیتاشیتی SPI2: master، 8-bit، MSB-first، CPOL بالا، CPHA لبه دوم، prescaler 64 و نرخ 562.5 kbit/s.
- ثبت SPI2 و پایه‌ها در `STM32F107.ioc` و همگام‌سازی `main.c` و MSP با خروجی مورد انتظار CubeMX.
- ثبت صریح `CLKPolarity=High` در `.ioc` تا تولید مجدد CubeMX حالت SPI صحیح را حفظ کند.
- بازنویسی `Libraries/ADE7880` بدون وابستگی به STM32 HAL و با callbackهای انتقال، CS و delay.
- افزودن وضعیت صریح خطا، timeout سراسری reset، verify نوشتن‌ها، سه پالس انتخاب SPI و کنترل `RSTDONE`.
- اصلاح خواندن PF با رجیسترهای مستقل `APF/BPF/CPF` به‌جای مسیر هارمونیک نامطمئن قدیمی.
- افزودن snapshot کامل سه فاز و نول، sign-extension توان، تبدیل Q1.15 ضریب توان و API کالیبراسیون خطی دو نقطه‌ای.
- اتصال کتابخانه به HAL فقط در `Application/Src/app.c`، خواندن هر یک ثانیه و تلاش بازیابی هر دو ثانیه.
- انتشار وضعیت در `g_app_electrical` برای Watch در VS Code و Keil.
- حفظ LED رقص در حالت سالم و الگوی سریع در خطای ارتباط.
- ثبت commit پیاده‌سازی `d3806fe` پس از build موفق.
- حذف نوشتن تکراری و غیرضروری `CONFIG2` و ثبت اصلاح در commit `7545989`.
- افزودن فصل ۱۵ گزارش با مراحل CubeMX، VS Code، Keil، پروگرام، تست، عیب‌یابی، کالیبراسیون و خروجی مورد انتظار.

اعتبارسنجی نرم‌افزاری:

- build PlatformIO با `-Wall -Wextra -Werror` موفق شد: 8000 بایت Flash و 260 بایت RAM.
- فایل `STM32F107.uvprojx` از نظر XML معتبر است؛ build واقعی Keil در این محیط انجام نشد، چون Keil نصب نیست.
- گزارش در دو گذر XeLaTeX به‌صورت ۶۴ صفحه A4 ساخته شد و لاگ نهایی هیچ خطای ساخت، نویسه مفقود، ارجاع حل‌نشده یا هشدار overfull/underfull ندارد.
- همه ۶۴ صفحه در چهار تماس‌برگ و صفحه‌های فصل ۱۵ در وضوح بالاتر بازبینی شدند؛ برش، هم‌پوشانی، شکست بد جدول یا خرابی راست‌به‌چپ مشاهده نشد.
- پروگرام یا آزمون فیزیکی ADE7880 در این نوبت انجام نشد؛ ادعای صحت سخت‌افزار یا کالیبراسیون وجود ندارد.

اطلاعات/آزمون‌های لازم برای تکمیل این مرحله:

1. نسبت CT/PT، مقدار burden و شبکه تقسیم ولتاژ هر کانال.
2. تأیید اینکه RESET و IRQ1 به میکرو وصل‌اند یا خیر و در صورت اتصال، شماره پایه‌ها.
3. پروگرام برد و گزارش `online`، `die_version` و چند snapshot خام بدون ورودی و با منبع مرجع.
4. کالیبراسیون جداگانه فازها و آزمون نقطه سوم مستقل.
5. build پروژه با Keil و ثبت warning/error و اندازه نهایی.

## نوبت پنجم کار — مستندسازی کد و خروجی مستقیم ولتاژ

درخواست کاربر: کامنت‌های انگلیسی منظم برای فهم مستقیم کد، مثال روشن استفاده از کتابخانه و آماده‌بودن برنامه برای نمایش ولتاژ پس از اتصال ورودی.

انجام‌شده:

- تکمیل Doxygen انگلیسی همه enumها، ساختارها، callbackها و توابع عمومی ADE7880 با توضیح پارامتر، خروجی و خطا.
- افزودن توضیح انگلیسی کنار رجیسترها، ثابت‌های زمانی، واحد ضرایب و مراحل غیر بدیهی پیاده‌سازی.
- مستندسازی مشابه API برنامه و ماژول LED و افزودن کامنت نقاط اتصال در `main.c`.
- افزودن `Libraries/ADE7880/README.md` شامل توالی استفاده، مثال انتقال به پروژه دیگر، کالیبراسیون و تفسیر statusها.
- بازیابی ضریب قدیمی ولتاژ از سورس پشتیبان: پایه `0.00055963 V/count` و اصلاح `1.017` برای فاز A.
- انتشار `voltage_v`، `voltage_valid` و `voltage_source` در `g_app_electrical`.
- فعال‌سازی ضریب قدیمی فقط برای فازهای A/B؛ فاز C عمداً تا دریافت کالیبراسیون معتبر نامعتبر باقی می‌ماند.
- افزودن `App_SetVoltageCalibration()` برای جایگزینی ساده ضریب هر فاز با نتیجه کالیبراسیون دو نقطه‌ای.
- افزودن `ADE7880_ApplyLinearCalibration()` برای تبدیل واضح یک مقدار خام و تغییر `ADE7880_Convert()` به تابع دارای status.
- ثبت تغییر کد در commit `7f37da1`.

اعتبارسنجی این نوبت:

- build PlatformIO با `-Wall -Wextra -Werror` موفق شد: 9400 بایت Flash و 304 بایت RAM.
- گزارش در دو گذر XeLaTeX به ۶۷ صفحه A4 رسید؛ لاگ فاقد خطای ساخت، نویسه مفقود و هشدار overfull/underfull است.
- هر ۶۷ صفحه در تماس‌برگ و همه صفحه‌های تغییرکرده فصل ۱۵ در وضوح بالاتر بازبینی شدند؛ شکست کد، هم‌پوشانی یا برش متن مشاهده نشد.
- تبدیل A/B در نرم‌افزار آماده است، ولی صحت عدد ولتاژ باید روی همین برد با مولتی‌متر یا کالیبراتور مرجع تأیید شود.
- پروگرام فیزیکی و اعمال ولتاژ در محیط این نوبت انجام نشد.

## نوبت ششم کار — رفع خطای ساخت Keil

درخواست کاربر: بررسی خطاهای متعدد Keil که از ناشناخته‌بودن نوع `DMA_HandleTypeDef` در هدرهای HAL آغاز می‌شدند.

تشخیص و اصلاح:

- نخستین خطای واقعی در `stm32f1xx_hal_i2c.h`، `stm32f1xx_hal_spi.h`، `stm32f1xx_hal_tim.h` و `stm32f1xx_hal_uart.h` مشترک بود؛ خطاهای بعدی آبشاری بودند.
- فایل پیاده‌سازی `stm32f1xx_hal_dma.c` از قبل در پروژه Keil حضور داشت، اما `HAL_DMA_MODULE_ENABLED` در `Core/Inc/stm32f1xx_hal_conf.h` غیرفعال بود.
- تعریف `HAL_DMA_MODULE_ENABLED` فعال شد تا `DMA_HandleTypeDef` پیش از handleهای I2C/SPI/TIM/UART تعریف شود. این وابستگی نوع در HAL است و به معنی فعال‌شدن انتقال DMA در منطق فعلی برنامه نیست.
- لاگ موقت ساخت Keil به `.gitignore` افزوده شد؛ خروجی اجرایی و فایل‌های میانی Keil همچنان وارد مخزن نمی‌شوند.

اعتبارسنجی این نوبت:

- ساخت واقعی `MDK-ARM/STM32F107.uvprojx` با Keil و Arm Compiler 6.24 موفق شد: `0 Error(s), 0 Warning(s)`.
- اندازه گزارش‌شده Keil: `Code=8972`، `RO-data=476`، `RW-data=12` و `ZI-data=1292` بایت.
- فایل HEX با موفقیت تولید شد.
- تغییر محلی کاربر در `Core/Src/main.c` و بازنویسی‌های محلی `STM32F107.uvoptx` و `STM32F107.uvprojx` حفظ شدند و جزو اصلاح این نوبت نیستند.
- پروگرام فیزیکی برد و آزمون ولتاژ در این نوبت انجام نشد؛ نتیجه بالا فقط زنجیره کامپایل و لینک Keil را تأیید می‌کند.

## نوبت هفتم کار — نمایش جریان، توان و ضریب توان در Watch

بازخورد کاربر: ارتباط و خواندن ولتاژ روی برد واقعی و با یک لامپ به‌عنوان بار موفق بود، اما جریان، توان و ضریب توان به‌صورت مستقیم در `g_app_electrical` دیده نمی‌شدند.

تشخیص:

- درایور از قبل `AIRMS/BIRMS/CIRMS`، `AWATT/BWATT/CWATT`، `AVA/BVA/CVA` و `APF/BPF/CPF` را در هر snapshot می‌خواند.
- مقادیر خام در `g_app_electrical.raw.phase[0..2]` موجود بودند، اما لایه برنامه فقط ولتاژ کالیبره‌شده را به فیلدهای مستقیم Watch منتقل می‌کرد.
- PF قالب ثابت Q1.15 دارد و بدون ضریب سخت‌افزار به بازه ۱- تا ۱+ تبدیل می‌شود. آمپر و وات به مدار ورودی، CT و burden وابسته‌اند و بدون کالیبراسیون برد نمی‌توان برای آن‌ها ضریب عمومی معتبر ساخت.

انجام‌شده:

- افزودن `current_a`، `active_power_w`، `apparent_power_va`، `power_factor` و `neutral_current_a` همراه با پرچم اعتبار متناظر به `App_ElectricalState`.
- تبدیل خودکار PF پس از هر snapshot کامل؛ اندیس‌های ۰، ۱ و ۲ همواره متناظر فازهای A، B و C هستند.
- افزودن `App_SetPhaseCalibration()` برای ولتاژ RMS، جریان RMS، توان اکتیو و توان ظاهری هر فاز.
- افزودن `App_SetNeutralCurrentCalibration()` برای جریان نول و حفظ `App_SetVoltageCalibration()` به‌عنوان رابط سازگار قبلی.
- جلوگیری از نمایش عدد مهندسی ساختگی: جریان و توان تا نصب ضریب اندازه‌گیری‌شده، مقدار صفر و valid نادرست دارند؛ raw همیشه برای راه‌اندازی قابل مشاهده است.
- مستندسازی مثال کالیبراسیون دو نقطه‌ای و هشدار درباره نامناسب‌بودن توان اسمی چاپ‌شده روی لامپ به‌عنوان مرجع دقیق.
- ثبت تغییر کد در commit `25a4cea`.

اعتبارسنجی این نوبت:

- ساخت PlatformIO با `-Wall -Wextra -Werror` موفق شد: ۹۶۴۰ بایت Flash و ۴۷۲ بایت RAM.
- ساخت Keil با Arm Compiler 6.24 موفق شد: `0 Error(s), 0 Warning(s)`؛ اندازه‌ها `Code=9628`، `RO-data=476`، `RW-data=12` و `ZI-data=1460` بایت هستند.
- صحت تبدیل PF از Q1.15 با دیتاشیت رسمی ADE7880 تطبیق داده شد.
- برای تکمیل کالیبراسیون، raw و مقدار هم‌زمان ابزار مرجع در دو نقطه پایدار برای جریان و توان هر فاز لازم است.

## نوبت هشتم کار — رفع صفر بودن خروجی مهندسی جریان و توان

بازخورد کاربر: ولتاژ و رجیسترهای خام درست تغییر می‌کردند، اما `current_a` و خروجی‌های مهندسی توان صفر باقی می‌ماندند.

علت:

- مسیر SPI و خواندن رجیستر سالم بود؛ تغییر مقادیر `raw.phase[n]` این موضوع را تأیید می‌کرد.
- لایه برنامه فقط ضرایب قدیمی ولتاژ را در `App_Init()` بارگذاری می‌کرد و تبدیل جریان و توان تا دریافت کالیبراسیون جدید غیرفعال بود؛ بنابراین مقدار صفر همراه با valid نادرست رفتار عمدی نسخه قبل بود.

بازیابی و اصلاح:

- سورس پشتیبان اصلی در `embedded/software/backup/Main/Core/Src/stm32f1xx_it.c` بررسی شد.
- ضریب جریان فازهای A/B برابر `0.00036565 A/count` بازیابی شد.
- ضریب توان اکتیو A/B برابر `0.0170276 W/count` بازیابی شد؛ فاز A اصلاح `1.02` دارد.
- طبق دیتاشیت و AN-1171، توان‌های اکتیو و ظاهری هر فاز در ADE7880 gain-matched هستند؛ بنابراین همان ضریب power به‌صورت موقت برای VA نیز استفاده و منبع آن `APP_CALIBRATION_DERIVED` ثبت شد.
- enum عمومی `App_CalibrationSource` و source جداگانه برای ولتاژ، جریان، توان اکتیو، توان ظاهری و جریان نول اضافه شد.
- ضرایب مستقیم قدیمی با `APP_CALIBRATION_LEGACY` و ضرایب نصب‌شده توسط کاربر با `APP_CALIBRATION_USER` مشخص می‌شوند.
- فاز C و جریان نول به دلیل نبود ضریب قابل اثبات همچنان صفر و نامعتبر باقی می‌مانند.
- ثبت اصلاح کد در commit `2f33fa6`.

خروجی مورد انتظار پس از پروگرام:

- پس از نخستین snapshot موفق، `current_valid[0/1]`، `active_power_valid[0/1]` و `apparent_power_valid[0/1]` درست می‌شوند.
- `current_a[0/1]`، `active_power_w[0/1]` و `apparent_power_va[0/1]` همراه raw تغییر می‌کنند.
- source جریان و توان اکتیو `APP_CALIBRATION_LEGACY` و source توان ظاهری `APP_CALIBRATION_DERIVED` است.
- اندیس ۲ و جریان نول تا کالیبراسیون واقعی valid نادرست دارند.

اعتبارسنجی نرم‌افزاری:

- PlatformIO با `-Wall -Wextra -Werror` موفق شد: ۹۷۶۸ بایت Flash و ۴۸۴ بایت RAM.
- Keil با Arm Compiler 6.24 موفق شد: `0 Error(s), 0 Warning(s)`؛ اندازه‌ها `Code=9732`، `RO-data=476`، `RW-data=12` و `ZI-data=1468` بایت هستند.

- صحت عدد نهایی روی برد همچنان باید با آمپرمتر/وات‌متر مرجع کنترل و ضرایب legacy با کالیبراسیون USER جایگزین شوند.

## نوبت نهم کار — اصلاح واحدها و جهت CT

بازخورد آزمون کاربر: برای یک لامپ حدود ۲۰ وات، خروجی جریان نزدیک `17` و توان نزدیک `231` بود. با برعکس‌کردن مسیر CT علامت توان از منفی به مثبت و علامت PF برعکس شد.

تشخیص:

- تغییر علامت توان با وارونه‌شدن CT رفتار طبیعی است، چون بردار جریان ۱۸۰ درجه برمی‌گردد؛ RMS جریان و توان ظاهری نباید با جهت CT عوض شوند.
- علامت PF در ADE7880 فقط «خوب/بد» یا علامت توان نیست؛ اطلاعات پیش‌فاز/پس‌فاز جریان را نیز حمل می‌کند. یک لامپ LED با ورودی یکسوساز/خازنی می‌تواند PF علامت‌دار منفی داشته باشد، در حالی که توان مصرفی مثبت است.
- سورس قدیمی مقدارهای جریان و توان را در متغیرهای صحیح ۱۶‌بیتی و بسته ارتباطی قرار می‌داد. تطبیق آزمون واقعی نشان داد واحد خروجی قدیمی جریان `0.01 A` و واحد توان `0.1 W` بوده است؛ بنابراین `17` حدود `0.17 A` و `231` حدود `23.1 W` است.

اصلاح انجام‌شده:

- ضریب موقت جریان A/B از `0.00036565` واحد قدیمی به `0.0000036565 A/count` تبدیل شد.
- ضریب موقت توان A/B از `0.0170276` واحد قدیمی به `0.00170276 W/count` تبدیل شد؛ اصلاح `1.02` فاز A حفظ شد.
- `power_factor_abs[3]` افزوده شد تا بزرگی PF از صفر تا یک، مستقل از علامت پیش‌فاز/پس‌فاز، مستقیماً در Watch دیده شود.
- `current_polarity[3]` و API مستند `App_SetCurrentPolarity()` افزوده شدند. حالت `REVERSED` فقط علامت توان اکتیو و PF علامت‌دار را اصلاح می‌کند و به RMS جریان، VA و قدرمطلق PF دست نمی‌زند.
- تشخیص خودکار جهت CT عمداً انجام نشد، زیرا در سامانه دوطرفه توان منفی می‌تواند صادرات واقعی باشد. جهت یک‌بار هنگام commissioning تعیین می‌شود.
- تغییر کد در commit `815a5f5` ثبت شد؛ تغییرهای محلی کاربر در `main.c` و فایل‌های پروژه Keil وارد commit نشدند.

روش تست بعد از پروگرام:

1. برای بار مصرفی، جهت CT را طوری قرار دهید که `active_power_w[phase]` مثبت باشد؛ در صورت وجود علامت، P1/K سمت منبع و P2/L سمت بار قرار می‌گیرد و اتصال ثانویه باید با شماتیک برد تطبیق داده شود.
2. اگر CT قابل جابه‌جایی نیست، پس از `App_Init()` یک‌بار polarity همان فاز را `APP_CURRENT_POLARITY_REVERSED` کنید.
3. برای قضاوت درباره بزرگی PF از `power_factor_abs` استفاده کنید؛ علامت `power_factor` برای تشخیص lead/lag حفظ شده است.
4. `current_a` باید اکنون مستقیماً حدود `0.17 A` و `active_power_w` حدود `23.1 W` نشان دهد، ولی این‌ها هنوز ضرایب legacy هستند و باید با آمپرمتر و وات‌متر true-RMS مرجع در دو نقطه کالیبره شوند.
5. ثانویه CT هنگام عبور جریان اولیه هرگز باز نشود؛ تغییر سیم‌بندی فقط در حالت بی‌برق یا طبق روش shorting سازنده انجام شود.

اعتبارسنجی نرم‌افزاری:

- PlatformIO با `-Wall -Wextra -Werror` موفق شد: ۱۰۰۹۲ بایت Flash و ۵۰۰ بایت RAM.
- Keil با Arm Compiler 6.24 موفق شد: `0 Error(s), 0 Warning(s)`؛ اندازه‌ها `Code=9732`، `RO-data=476`، `RW-data=12` و `ZI-data=1468` بایت هستند.

## نوبت دهم کار — واحد نمایش قابل تنظیم و کالیبراسیون چندنقطه‌ای

درخواست کاربر: حفظ نمایش قدیمی صدم‌آمپر و دهم‌وات به‌عنوان پیش‌فرض قابل تغییر و فراهم‌کردن کالیبراسیون ساده ولتاژ، جریان و توان در بازه وسیع.

تصمیم فنی:

- فیلدهای SI با نام‌های `current_a`، `active_power_w` و `apparent_power_va` برای محاسبات حفظ شدند تا واحد پنهان یا مبهم وارد منطق برنامه نشود.
- فیلدهای مستقل `current_display`، `active_power_display` و `apparent_power_display` اضافه شدند. پیش‌فرض‌ها به‌ترتیب `100 unit/A` و `10 unit/W` هستند؛ در نتیجه `0.17 A` به‌شکل `17` و `23.1 W` به‌شکل `231` دیده می‌شود.
- ثابت‌های `APP_DEFAULT_CURRENT_DISPLAY_UNITS_PER_AMP` و `APP_DEFAULT_POWER_DISPLAY_UNITS_PER_WATT` در `app.h` و تابع runtime به نام `App_SetDisplayUnits()` امکان تغییر آسان را می‌دهند.
- براساس AN-1171 مسیر ADE7880 خطی در نظر گرفته شد. به‌جای ضرایب قطعه‌ای کم‌بار/پربار که می‌توانند در مرز پرش بسازند، یک خط gain/offset با کمترین‌مربعات روی همه نقاط برازش می‌شود.
- ساختار `ADE7880_CalibrationPoint` و تابع قابل‌حمل `ADE7880_CalculateLinearCalibrationMultiPoint()` افزوده شدند. تابع حداقل دو نقطه می‌پذیرد، سه تا پنج نقطه توصیه می‌شود و بیشترین residual را در واحد مرجع گزارش می‌کند.
- تابع کاربردی `App_CalibratePhaseMultiPoint()` همان برازش را برای ولتاژ RMS، جریان RMS، توان اکتیو یا توان ظاهری نصب می‌کند و `scale/offset` نهایی را برای ذخیره بعدی برمی‌گرداند.
- برای CT با polarity نرم‌افزاری معکوس، تابع کالیبراسیون علامت ضرایب توان اکتیو را داخلی هماهنگ می‌کند؛ reference همواره مقدار نهایی مورد انتظار است.
- طبق راهنمای رسمی، gain برای هر دستگاه لازم است؛ phase برای CT به‌ویژه در PF پایین و offset برای دقت گسترده در بار کم باید جداگانه ارزیابی شوند. اگر residual کم‌بار سیستماتیک بماند، مرحله بعد اصلاح رجیسترهای offset خود ADE7880 است، نه افزودن پرش قطعه‌ای.

روش پیشنهادی برداشت نقاط:

1. در هر نقطه پس از پایداری، چندین نمونه raw میانگین و مقدار هم‌زمان ابزار مرجع ثبت شود.
2. برای ولتاژ سه نقطه در پایین، نامی و بالای بازه کاری؛ برای جریان/توان دست‌کم کم‌بار، میانی و نزدیک بیشینه مجاز انتخاب شود.
3. برای gain توان از بار مرجع پایدار با PF معلوم استفاده و phase CT در آزمون جداگانه نزدیک PF=0.5 بررسی شود.
4. `max_abs_error` و یک یا دو نقطه مستقلِ خارج از نقاط برازش کنترل شوند.
5. پس از تأیید، `scale/offset` بازگشتی در Flash/تنظیمات یا ثابت‌های startup ذخیره و بعد از هر reset با `App_SetPhaseCalibration()` نصب شود.

اعتبارسنجی نرم‌افزاری:

- PlatformIO با `-Wall -Wextra -Werror` موفق شد: ۱۰۲۵۲ بایت Flash و ۵۴۴ بایت RAM.
- Keil با Arm Compiler 6.24 موفق شد: `0 Error(s), 0 Warning(s)`؛ اندازه‌ها `Code=9828`، `RO-data=476`، `RW-data=12` و `ZI-data=1532` بایت هستند.
- کد در commit `691fd79` ثبت شد و تغییرهای محلی کاربر در `main.c` و فایل‌های Keil وارد commit نشدند.

## نوبت یازدهم کار — پیش‌فرض کامل سه‌فاز و کالیبراسیون مستقل همه کانال‌ها

درخواست کاربر: یکسان‌شدن قاعده A/B/C، قابل‌استفاده‌بودن فاز C حتی پیش از کالیبراسیون نهایی، پیش‌فرض‌داشتن همه کمیت‌های پشتیبانی‌شده و حفظ سادگی برای کاربرد تک‌فاز، دو کانال مستقل و سه‌فاز.

ممیزی و تصمیم:

- درایور قابل‌حمل از قبل رجیسترهای ولتاژ RMS، جریان RMS، توان اکتیو، توان ظاهری و PF هر سه فاز را با جدول رجیستر و حلقه مشترک می‌خواند؛ نقص در لایه Application بود که فقط ضرایب A/B را فعال می‌کرد.
- همه ضرایب startup در یک جدول صریح `default_calibration` در ابتدای `Application/Src/app.c` قرار گرفتند. هر خانه دقیقاً `{scale, offset}` و مستقل از فازها و کمیت‌های دیگر است.
- مقادیر بازیابی‌شده A/B حفظ شدند. چون داده اندازه‌گیری‌شده C موجود نبود، ولتاژ و توان C موقتاً از B و جریان C از ضریب مشترک A/B شروع می‌شود. جریان نول نیز موقتاً همان scale جریان فازها را دارد.
- توان ظاهری هر فاز خانه مستقل دارد، ولی مقدار اولیه آن با توان اکتیو همان فاز برابر است. بعداً می‌توان VA را بدون تغییر W جداگانه کالیبره کرد.
- همه ضرایب startup با `APP_CALIBRATION_DEFAULT` و ضرایب نصب‌شده با `APP_CALIBRATION_USER` مشخص می‌شوند. `valid=true` فقط موفقیت تبدیل را نشان می‌دهد و تأیید دقت fallback نیست.
- `App_ResetCalibrationToDefaults()` همه overrideهای RAM را حذف و جدول کامل A/B/C/neutral را بازمی‌گرداند. `App_Init()` همین تابع را خودکار اجرا می‌کند.
- `App_CalibrateNeutralCurrentMultiPoint()` افزوده شد تا NIRMS نیز مانند کمیت‌های فاز، مسیر ساده و مستقیم کالیبراسیون چندنقطه‌ای داشته باشد.
- API فازی با پارامتر `ADE7880_Phase` ثابت ماند: تک‌فاز فقط A را مصرف می‌کند، دو کانال می‌توانند A/B را مستقل کالیبره کنند و سه‌فاز A/B/C را به‌کار می‌گیرد. تغییر یک خانه روی خانه دیگر اثر ندارد.
- خود کتابخانه هیچ نمونه سراسری از IC ندارد؛ پروژه قابل‌حمل می‌تواند برای چند ADE7880 چند `ADE7880_Device` مستقل با transport جدا بسازد.

رفتار مورد انتظار بعد از پروگرام:

1. پس از نخستین snapshot موفق، validهای ولتاژ، جریان، W و VA در اندیس‌های ۰، ۱ و ۲ و valid جریان نول درست می‌شوند.
2. source همه آن‌ها ابتدا `APP_CALIBRATION_DEFAULT` است.
3. کالیبراسیون یک کمیت/فاز فقط source همان خانه را `APP_CALIBRATION_USER` می‌کند.
4. reset سخت‌افزاری یا `App_ResetCalibrationToDefaults()` دوباره جدول startup را فعال می‌کند.
5. فاز C و نول پیش از استفاده اندازه‌گیری دقیق باید با مرجع واقعی کالیبره شوند؛ fallback فقط برای bring-up و توسعه آماده است.

اعتبارسنجی نرم‌افزاری:

- PlatformIO با `-Wall -Wextra -Werror` موفق شد: ۱۰۳۲۸ بایت Flash و ۵۴۴ بایت RAM.
- Keil با Arm Compiler 6.24 موفق شد: `0 Error(s), 0 Warning(s)`؛ اندازه‌ها `Code=9848`، `RO-data=580`، `RW-data=12` و `ZI-data=1532` بایت هستند.
- گزارش در دو گذر XeLaTeX به ۷۶ صفحه A4 ساخته شد؛ لاگ نهایی فاقد خطا، نویسه مفقود و هشدار overfull/underfull است.
- همه ۷۶ صفحه در چهار تماس‌برگ و صفحه‌های ۶۹ تا ۷۶ فصل تغییرکرده در اندازه بزرگ‌تر بازبینی شدند؛ برش، هم‌پوشانی، جدول شکسته یا خرابی راست‌به‌چپ مشاهده نشد.
- تغییر کد و راهنمای استفاده در commit `1a5ddb2` ثبت شد. تغییرهای محلی کاربر در `Core/Src/main.c` و فایل‌های پروژه Keil وارد commit نشدند.

## نوبت دوازدهم کار — ممیزی و تثبیت نهایی milestone سه‌فاز

درخواست کاربر: کنترل دوباره‌ی کامل فایل‌ها و Git، رفع موارد جاافتاده، نهایی‌کردن گزارش و ساخت یک نقطه‌ی ادامه که در نوبت بعد نیاز به توضیح طولانی گذشته نباشد.

یافته‌ها و اصلاح‌ها:

- درایور ADE7880 و لایه کاربرد از نظر تقارن A/B/C/N، استقلال ضرایب، مسیر تک‌فاز/دوکانال/سه‌فاز و APIهای نصب و برازش کالیبراسیون دوباره ممیزی شدند؛ نقص عملکردی تازه‌ای در خواندن رجیسترها پیدا نشد.
- یک رفتار گمراه‌کننده‌ی دیباگر اصلاح شد: پس از تغییر کالیبراسیون یا جهت CT، پرچم valid نادرست می‌شد اما مقدار SI/نمایش قبلی تا نمونه بعدی باقی می‌ماند. اکنون مقدار وابسته همان لحظه صفر و نمایش نیز تازه می‌شود.
- فصل معماری و فصل مرجع لایه کاربرد بازنویسی شدند تا فقط کد فعال فعلی، مسیرهای درست `Application` و APIهای واقعی را شرح دهند. فصل LED نیز با مسیرهای فعلی و وضعیت runtime هماهنگ شد.
- خلاصه بالای همین فایل از تاریخچه قدیمی جدا شد و اکنون baseline جاری، تصمیم‌های فنی، محدودیت کالیبراسیون و اولویت‌های واقعی مرحله بعد را ثبت می‌کند. بخش‌های نوبت‌های قبلی صرفاً تاریخچه‌اند.
- `.gitignore` برای فایل‌های سیستم‌عامل/ویرایشگر، پوشه موقت QA، خروجی‌های ساخت و فایل شخصی `MDK-ARM/*.uvoptx` تکمیل شد. فایل `.uvoptx` از index حذف شد، ولی نسخه محلی کاربر پاک نشد. فایل قابل‌حمل `.uvprojx` همچنان track می‌شود.
- اصلاح وضعیت runtime و بهداشت Git در commit `5b8fc02` ثبت شد.
- تنظیمات ضروری CubeMX دوباره کنترل شدند: `PB12=ADE_CS`، خطوط SPI2 روی PB13/PB14/PB15، Mode 3 و prescaler 64. فایل پروژه Keil نیز XML معتبر دارد.

اعتبارسنجی نهایی:

- PlatformIO با `-Wall -Wextra -Werror` موفق شد: ۱۰۳۷۲ بایت Flash و ۵۴۴ بایت RAM.
- Keil با Arm Compiler 6.24 موفق شد: `0 Error(s), 0 Warning(s)`؛ اندازه‌ها `Code=9848`، `RO-data=580`، `RW-data=12` و `ZI-data=1532` بایت هستند.
- گزارش در دو گذر XeLaTeX به ۷۶ صفحه A4 ساخته شد. لاگ نهایی فاقد خطا، هشدار، نویسه مفقود و overfull/underfull است.
- همه ۷۶ صفحه به تصویر تبدیل و در تماس‌برگ بازبینی شدند؛ فصل‌های معماری، مرجع API و LED در وضوح بالاتر نیز کنترل شدند و برش، هم‌پوشانی، خرابی جدول یا مشکل راست‌به‌چپ مشاهده نشد.
- `git diff --check` بدون خطاست و خروجی‌های build/LaTeX/QA در وضعیت Git ظاهر نمی‌شوند.

مرز اعتبار این نسخه:

- این ممیزی صحت ساخت، ساختار نرم‌افزار و مستندات را تأیید می‌کند. پروگرام مجدد این commit روی برد و کالیبراسیون آزمایشگاهی A/B/C/N در این نوبت انجام نشده است.
- نتیجه‌های سخت‌افزاری ثبت‌شده تا اینجا شامل ارتباط موفق ADE7880، مشاهده ولتاژ و پاسخ جریان/توان بار لامپی توسط کاربر است. پذیرش صنعتی منوط به انجام فهرست «کارهای باز و آزمون‌های مرحله بعد» در بالای همین فایل است.

## نوبت سیزدهم کار — انتقال به مخزن یکپارچه محصول

درخواست کاربر: ممیزی انتقال مخزن تمیز فریم‌ور به `es-ac-load-cycler`، بررسی ساختار تازه شامل سخت‌افزار، مستندات و دیتاشیت‌ها، گزارش وضعیت و به‌روزرسانی حافظه پروژه.

انجام‌شده:

- سلامت مرجع قدیمی و commit جاری کنترل شد؛ مخزن قدیمی بدون تغییر محلی است.
- ۱۴۷ فایل track‌شده با مقصد جدید تطبیق داده شدند؛ به‌جز جابه‌جایی `.gitignore` به ریشه، هر ۱۴۶ فایل منتقل‌شده در `embedded/stm32f107` از نظر SHA-256 با نسخه قدیمی یکسان است.
- ساخت PlatformIO از محل جدید اجرا و موفق شد؛ اندازه Flash و RAM با baseline قبلی یکسان است.
- ساختار و وابستگی‌های پروژه Altium، فایل‌های صفر بایت، حجم پوشه‌ها، خروجی DRC و ارجاع‌های مسیر مطلق بررسی شدند.
- محل همین فایل از پوشه فریم‌ور به ریشه مخزن تغییر کرد و لینک README فریم‌ور به محل جدید اصلاح شد.
- هیچ فایل تکراری، خروجی build یا History حذف نشد و هیچ فایل سخت‌افزاری تغییر نکرد؛ پاک‌سازی و انتخاب دقیق فایل‌های قابل track عمداً به مرحله بعد واگذار شد تا بدون تأیید، داده طراحی حذف نشود.

اعتبارسنجی این نوبت:

- `PlatformIO Core 6.2.0`: موفق، `Flash=10372 bytes` و `RAM=544 bytes`.
- تطبیق محتوای فریم‌ور منتقل‌شده: صفر فایل تغییرکرده و صفر فایل منبع مفقود؛ فقط `.gitignore` در ریشه جدید قرار دارد.
- پروژه Altium: هشت سند اصلی طراحی موجود؛ سه ارجاع کتابخانه‌ای داخل/نزدیک پروژه مفقود و چند وابستگی خارج مخزن موجود است.
- DRC ثبت‌شده: ۵ violation و نیازمند تولید مجدد از مسیر جدید.
- وضعیت Git در پایان این نوبت عمداً تمیز نیست، چون جابه‌جایی ساختار و سخت‌افزار جدید هنوز stage/commit نشده‌اند.

## نوبت چهاردهم کار — پاک‌سازی و ثبت ساختار یکپارچه

درخواست کاربر: نگه‌داری کامل منابع اصلی سخت‌افزار در Git، جلوگیری از ورود History و فایل‌های حجیم/بی‌ارزش، تطبیق `.gitignore` با مسیرهای جدید، حذف فایل‌های تکراری و ثبت یک commit معنادار.

انجام‌شده:

- `.gitignore` برای PlatformIO، VS Code، LaTeX، QA موقت و خروجی‌ها/وضعیت شخصی Keil در هر عمق بازنویسی شد.
- `hardware/altium/History/`، `__Previews/`، `Project Logs for */`، `Project Outputs for */`، فایل‌های `PrjPcbStructure` و lockهای Altium به‌طور صریح ignore شدند.
- فایل‌های اصلی طراحی Altium شامل پروژه، هفت شماتیک، PCB، کتابخانه‌های PCB و کتابخانه مجتمع برای ثبت در Git نگه‌داری شدند.
- ۲۶ فایل تکراری مستندات و یک دیتاشیت تکراری زیر `embedded/stm32f107/` پس از اثبات برابری نام و SHA-256 حذف شدند؛ نسخه‌های مرجع در ریشه باقی ماندند.
- README مخصوص مخزن در ریشه ساخته و README فریم‌ور با مسیرهای جدید `PROJECT_STATUS.md`، `docs/` و `datasheets/` هماهنگ شد.
- خروجی‌های محلی سنگین حذف نشدند و روی سیستم باقی ماندند، اما با `git check-ignore` تأیید شد که وارد commit نمی‌شوند.

اعتبارسنجی پیش از ثبت:

- build تازه PlatformIO از مسیر جدید موفق است: `Flash=10372 bytes` و `RAM=544 bytes`.
- `git diff --check` بدون خطاست.
- فهرست ignored برای نمونه‌های History، preview، log، DRC تولیدی، Keil object/log و `.pio` به‌صورت صریح کنترل شد.
- commit این مرحله با پیام `chore: organize unified firmware and hardware repository` ثبت شد.

## نوبت پانزدهم کار — ممیزی نهایی محلی پیش از انتشار

درخواست کاربر: توقف موقت انتشار در GitHub و کنترل دوباره READMEها، ساختار Git، build فریم‌ور و گزارش نهایی؛ هر اصلاح لازم باید در یک commit تمیز ثبت شود.

نتیجه ممیزی:

- شاخه اصلی محلی `main` است، working tree پیش از این ممیزی تمیز بود و هیچ remoteای تعریف نشده است؛ بنابراین هیچ داده‌ای به GitHub یا سرویس دیگری push نشده است.
- همه لینک‌های محلی Markdown در README ریشه، README فریم‌ور، README کتابخانه ADE7880، README گزارش و `PROJECT_STATUS.md` بررسی شدند و لینک شکسته‌ای پیدا نشد.
- مسیرهای README فریم‌ور برای `PROJECT_STATUS.md`، `docs/` و `datasheets/` با ساختار یکپارچه فعلی سازگارند.
- هیچ فایل untracked قابل‌مشاهده و هیچ فایل track‌شده‌ی مشمول `.gitignore` وجود ندارد. خروجی‌های ساخت و فایل‌های محلی سنگین همچنان فقط روی سیستم باقی می‌مانند و وارد Git نمی‌شوند.
- ارجاع مسیر قدیمی فقط در تاریخچه همین فایل برای ثبت منشأ انتقال باقی مانده است؛ سورس، تنظیمات ساخت و READMEها به مسیر قدیمی وابسته نیستند.

اعتبارسنجی این نوبت:

- PlatformIO از `embedded/stm32f107/` موفق شد: `Flash=10372 bytes` و `RAM=544 bytes`.
- گزارش با XeLaTeX در دو گذر بدون خطا ساخته شد: ۷۶ صفحه A4، بدون warning، نویسه مفقود، ارجاع حل‌نشده یا overfull/underfull.
- همه ۷۶ صفحه PDF در چهار تماس‌برگ و صفحه‌های شاخص شامل جلد، متن/کد متراکم و صفحه پایانی در اندازه اصلی بازبینی شدند؛ برش، هم‌پوشانی، خرابی جدول یا مشکل راست‌به‌چپ مشاهده نشد.
- `git diff --check` پیش از commit باید بدون خطا باشد.

مرز اعتبار:

- این نوبت build نرم‌افزار، بازتولید و ظاهر گزارش و سلامت ساختار مخزن را تأیید می‌کند. پروگرام مجدد برد، آزمون عملی خروجی‌ها، اجرای طولانی‌مدت و کالیبراسیون آزمایشگاهی در این نوبت انجام نشده‌اند؛ بنابراین سلامت صنعتی همچنان منوط به آزمون‌های سخت‌افزاری فهرست‌شده در بخش کارهای باز است.

## نوبت شانزدهم کار — DS18B20 قابل‌حمل با شماره‌گذاری پایدار

درخواست کاربر: استفاده از `PB10` و `PC7` برای تعداد دلخواه DS18B20، حفظ شماره نوشته‌شده روی سنسورها پس از قطع برق و تعویض، قابلیت انتقال کتابخانه به MCU دیگر، مشاهده دما در دیباگر، سازگاری PlatformIO/Keil/CubeMX و مستند آموزشی کامل.

انجام‌شده:

- `Libraries/OneWire` بدون وابستگی به HAL بازنویسی شد و callbackهای خط، تأخیر و critical section، زمان‌بندی استاندارد، Dallas CRC8 و Search ROM قطعی به آن افزوده شد.
- `Libraries/DS18B20` به لایه فرمان مستقل تبدیل شد: اعتبارسنجی family/ROM، Match/Skip ROM، Convert T، scratchpad با CRC، دمای signed، وضوح ۹ تا ۱۲ بیت و تابع ساده blocking برای پروژه‌های کوچک.
- `Libraries/DS18B20Manager` ساخته شد: حداکثر ۳۲ شماره روی چند bus، کشف مرتب و قابل مشاهده، جدول `logical slot -> bus + ROM`، ماشین حالت تبدیل غیرمسدودکننده و خواندن یک سنسور در هر دور حلقه.
- معرفی اولیه با `App_TemperatureAssignDiscovered()` و معرفی مستقیم با `App_TemperatureAssignRom()` انجام می‌شود. شماره انسانی `N` همیشه در `g_app_temperature.slots[N-1]` است.
- جایگزینی خودکار فقط در snapshot بدون ابهام، یعنی دقیقاً یک نگاشت غایب و یک ROM تازه روی همان bus، انجام می‌شود. در حالت چند غایب/چند تازه، تخصیص صریح لازم است.
- `SensorAddressStore` به رکورد opaque نسخه ۲ با payload، CRC32 و verify پس از write تبدیل شد. آخرین صفحه ۲ KiB از `0x0803F800` همچنان خارج linker است. نگاشت خراب، ROM نامعتبر، bus خارج محدوده و duplicate هنگام load پذیرفته نمی‌شوند.
- فرمت قدیمی به‌علت نداشتن شماره bus خودکار مهاجرت داده نمی‌شود؛ API خواندن آن فقط برای مهاجرت آگاهانه باقی مانده است.
- `PB10=ONE_WIRE_1` و `PC7=ONE_WIRE_2` در IOC و GPIO مولد به‌صورت open-drain، no-pull و سطح اولیه آزاد ثبت شدند. منطق محصول بیرون فایل‌های مولد و فراخوانی‌ها داخل USER CODE باقی ماندند.
- adapter برد در `Application/Src/app.c` از شمارنده سیکل Cortex-M3 برای تأخیر میکروثانیه، HAL tick برای زمان و صفحه Flash برای نگاشت استفاده می‌کند. دما مستقل از حضور ADE7880 پردازش می‌شود.
- پروژه‌های PlatformIO و Keil با include/source مدیر جدید همگام شدند. دیتاشیت `datasheets/ds18b20.pdf` به منابع پروژه افزوده شد.
- README ریشه، README فریم‌ور، راهنمای مستقل کتابخانه، فصل‌های قدیمی متناقض و فصل تازه ۱۶ گزارش برای اتصال، commissioning، تعویض، Watch، انتقال MCU، CubeMX و آزمون به‌روزرسانی شدند.

اعتبارسنجی این نوبت:

- ساخت واقعی PlatformIO با `-Wall -Wextra -Werror` موفق است: `Flash=14696 bytes` از ۲۵۶ KiB و `RAM=3040 bytes` از ۶۴ KiB.
- `STM32F107.uvprojx` از نظر XML معتبر است و `ds18b20_manager.c` و include متناظر را دارد؛ Keil در این محیط نصب نیست و build واقعی این نسخه در ایستگاه توسعه باقی مانده است.
- تنظیم‌های IOC و کد GPIO برای `PB10/PC7`، open-drain و سطح آزاد بررسی شدند.
- گزارش در دو گذر XeLaTeX بدون خطا، warning، نویسه مفقود و overfull/underfull ساخته شد: ۸۲ صفحه A4.
- همه ۸۲ صفحه در پنج تماس‌برگ و فصل ۱۶ و بخش مرجع درایور در اندازه اصلی بازبینی شدند؛ برش، هم‌پوشانی، متن مفقود یا اشکال راست‌به‌چپ دیده نشد.

مرز اعتبار:

- این نوبت معماری، ساخت GCC، فایل پروژه Keil و مستندات را تأیید می‌کند؛ سنسور واقعی به این محیط متصل نبود. کیفیت pull-up، timing روی کابل نهایی، ROMهای واقعی، دقت دما، سناریوی تعویض و پایداری ۲۴ ساعته باید روی برد طبق فهرست کارهای باز آزموده شوند.
- دما هنوز عمداً فقط در `g_app_temperature` منتشر می‌شود و به پروتکل سریال یا کنترل رله متصل نشده است تا مسیر خواندن و هویت ابتدا مستقل پذیرفته شود.

## نوبت هفدهم کار — ساده‌سازی کامل استفاده از DS18B20

بازخورد کاربر: آدرس سنسور در `discovered[0]` دیده می‌شد، اما نیاز به فراخوانی تابع از دیباگر نامفهوم و نامناسب بود. مسیر عادی باید برای یک، دو یا چند سنسور بدون عملیات دستی کار کند و رابط کد ساده باشد.

اصلاح انجام‌شده:

- گزینه `auto_assign_new` به مدیر قابل‌حمل افزوده و در این برد فعال شد. هر ROM تازه پس از کشف خودکار به اولین شماره خالی متصل و نگاشت آن فوراً در Flash ذخیره می‌شود.
- ترتیب تخصیص چند سنسور هم‌زمان قطعی است: ابتدا شماره bus و سپس ROM. برای هماهنگی با برچسب‌های فیزیکی، سنسورها فقط به‌ترتیب و یک‌به‌یک وصل می‌شوند؛ هیچ تابعی از دیباگر فراخوانی نمی‌شود.
- جست‌وجوی نخست بلافاصله بعد از بوت و جست‌وجوهای بعدی هر پنج ثانیه انجام می‌شوند. سنسور اول پس از کشف و نخستین تبدیل تقریباً در یک ثانیه مقدار معتبر می‌دهد.
- رابط ساده در `Application/Inc/app_temperature.h` جدا شد. برنامه معمول فقط با `g_temperature_c[]`، `g_temperature_valid[]`، `g_temperature_sensor_count` و `App_TemperatureGetCelsius()` کار می‌کند.
- ساختار `g_app_temperature` و APIهای کشف/تخصیص دستی حذف نشدند، اما صریحاً به‌عنوان ابزار پیشرفته تعمیر و تولید از مسیر معمول جدا شدند.
- README فریم‌ور، راهنمای کتابخانه، فصل‌های ۴، ۱۰ و ۱۶ گزارش و خلاصه جاری این فایل با رفتار خودکار هماهنگ شدند.

اعتبارسنجی نهایی:

- PlatformIO با `-Wall -Wextra -Werror` موفق است: `Flash=14932 bytes` و `RAM=3208 bytes`.
- فایل `STM32F107.uvprojx` از نظر XML معتبر است و سورس‌های مدیر دما را در گروه کتابخانه‌های قابل‌استفاده‌مجدد نگه می‌دارد؛ قالب‌بندی خواناتر همین گروه که در فایل محلی موجود بود نیز بدون تغییر معنایی حفظ شد.
- گزارش در دو گذر XeLaTeX بدون خطا، warning، نویسه مفقود و overfull/underfull ساخته شد: ۸۳ صفحه A4. همه صفحه‌ها در پنج تماس‌برگ و صفحات تغییرکرده در اندازه اصلی بازبینی شدند؛ برش، هم‌پوشانی یا اشکال راست‌به‌چپ دیده نشد.
- `git diff --check` و کنترل خروجی‌های موقت/نادیده‌گرفته‌شده پیش از commit انجام شد.
- آزمون روی سنسور فیزیکی همچنان باید توسط کاربر انجام شود: برای سنسور اول `g_temperature_valid[0]` باید پس از حدود یک ثانیه درست و `g_temperature_c[0]` قابل مشاهده شود.

## نوبت هجدهم کار — تثبیت نقطه تحویل برای ادامه آینده

درخواست کاربر: یک بررسی سریع نهایی و به‌روزرسانی حافظه پروژه، به‌طوری‌که در مراجعه بعدی محل توقف، کارهای انجام‌شده و قدم بعد بدون مرور دوباره کل تاریخچه روشن باشد.

انجام‌شده و بررسی‌شده:

- بخش «نقطه تحویل سریع» و «شروع پیشنهادی نوبت بعد» به ابتدای وضعیت جاری افزوده شد.
- ارجاع قدیمی baseline پیش از DS18B20 با baseline عملکردی فعلی `44b330a` جایگزین و تعداد فایل‌های track‌شده به ۱۶۸ اصلاح شد.
- روشن شد که مخزن قدیمی فقط مرجع تاریخی انتقال است و همه ادامه کار باید در `E:/projects/es-ac-load-cycler` انجام شود.
- وضعیت فایل‌های محلی Altium اصلاح شد: History، preview و log روی دیسک می‌مانند اما توسط `.gitignore` از Git خارج هستند.
- build تازه PlatformIO با `-Wall -Wextra -Werror` موفق شد: `Flash=14932 bytes` و `RAM=3208 bytes`.
- فایل پروژه Keil دوباره parse شد و XML معتبر است؛ build واقعی Keil همچنان روی ایستگاه دارای Keil باقی مانده است.
- PDF موجود دوباره از نظر مشخصات کنترل شد: ۸۳ صفحه A4 و ۲۸۶۶۹۸ بایت. در این نوبت PDF تغییر نکرد، چون محتوای گزارش فنی و فصل DS18B20 از نوبت قبل کامل و بازبینی‌شده بود.
- قواعد ignore برای خروجی PlatformIO و `hardware/altium/History/` به‌صورت عملی با `git check-ignore` تأیید شدند و `git diff --check` بدون خطاست.

محل دقیق توقف: نرم‌افزار و مستندات آماده‌اند؛ قدم بعدی، پروگرام همین baseline روی برد و اجرای بندهای ۱ و ۲ فهرست کارهای باز برای DS18B20 واقعی است. تا پیش از ثبت نتیجه این آزمون، اتصال دما به پروتکل سریال یا منطق کنترل توصیه نمی‌شود.

## نوبت نوزدهم کار — ممیزی تخصصی و کوچک‌سازی رابط دما

درخواست کاربر: بازبینی توابع و کتابخانه‌های نوشته‌شده با معیار API کم، خوانایی بالا، استفاده ساده در پروژه‌های دیگر، جلوگیری از منطق غیرضروری، مقاومت در برابر Generate Code کیوب، تکمیل کامنت‌ها، گزارش و commit.

نتیجه ممیزی و ریفکتور:

- هدر `app_temperature.h` از جزئیات مدیر مستقل شد و دیگر `ds18b20_manager.h` را include نمی‌کند. سطح عمومی برنامه از پنج تابع به فقط `App_TemperatureGetCelsius()`، دو آرایه مقدار/اعتبار و شمار هویت‌های ثبت‌شده کاهش یافت.
- نمونه مدیر از `g_app_temperature` عمومی به `temperature_manager` خصوصی در `app.c` تبدیل شد. wrapperهای تکراری کشف، تخصیص ROM، تخصیص discovery و پاک‌کردن حذف شدند؛ APIهای پیشرفته همچنان در خود کتابخانه مدیر برای build تولید یا تعمیر موجودند.
- سه گزینه پیکربندی که در این معماری همیشه مقدار ثابتی داشتند حذف شدند: `auto_assign_new`، `auto_replace_unambiguous` و `conversion_time_ms`. ثبت ROM تازه و تعویض بدون ابهام اکنون رفتار امن و ثابت مدیر است و انتظار تبدیل از مقدار استاندارد ۱۲ بیت خود درایور گرفته می‌شود.
- `DS18B20_ManagerProcess()` اکنون فقط هنگام کشف یا تغییر یک slot مقدار `true` می‌دهد. آرایه‌های عمومی ۳۲تایی فقط در همین حالت منتشر می‌شوند و پیمایش و بازنویسی بی‌دلیل آن‌ها در هر دور حلقه اصلی حذف شد.
- اشاره‌گر bus در پیکربندی مدیر `const` شد و enum استفاده‌نشده `DS18B20_MANAGER_STATUS_NOT_FOUND` حذف شد.
- `DS18B20_ReadScratchpad()` و `DS18B20_ReadTemperatureBlocking()` اکنون `ROM=NULL` را برای bus دارای دقیقاً یک سنسور می‌پذیرند. بنابراین پروژه تک‌سنسور می‌تواند بدون manager و بدون Search ROM فقط یک تابع blocking را صدا بزند.
- کامنت‌های Doxygen رابط ساده، قرارداد مقدار بازگشتی manager، پیکربندی و حالت تک‌سنسور تکمیل شدند. کامنت‌ها علت و قرارداد را توضیح می‌دهند و از تکرار خط‌به‌خط کد پرهیز شده است.
- هیچ منطق محصولی به فایل مولد CubeMX منتقل نشد. تغییرها فقط در `Application/` و `Libraries/` هستند؛ `main.c` همچنان فقط `App_Init()` و `App_Process()` را از بلوک‌های USER CODE فراخوانی می‌کند.

اعتبارسنجی این نوبت:

- PlatformIO با `-Wall -Wextra -Werror` موفق است: `Flash=14928 bytes` و `RAM=3204 bytes`؛ نسبت به baseline قبلی هر کدام ۴ بایت کمتر شده‌اند.
- فایل پروژه Keil از نظر XML معتبر است و چون فایل سورس جدیدی افزوده نشده، فهرست سورس و include آن نیاز به تغییر نداشت. build واقعی Keil همچنان باید روی ایستگاه دارای Keil اجرا شود.
- گزارش در دو گذر XeLaTeX بدون خطا، warning، نویسه مفقود یا overfull/underfull ساخته شد: ۸۳ صفحه A4 و ۲۸۸۰۵۹ بایت.
- همه ۸۳ صفحه در پنج تماس‌برگ و صفحات تغییرکرده فصل‌های ۴، ۱۰ و ۱۶ در اندازه اصلی بازبینی شدند؛ برش، هم‌پوشانی یا خرابی راست‌به‌چپ مشاهده نشد.

مرز اعتبار: این ریفکتور API، پیچیدگی، ساخت و مستندات را بهبود داده است، اما رفتار الکتریکی و timing با سنسور و کابل واقعی هنوز باید طبق دو بند نخست کارهای باز روی برد تأیید شود.

## نوبت بیستم کار — LCD کاراکتری و سه کلید بدون جهش

درخواست کاربر: افزودن کتابخانه ساده و کامل برای LCD کاراکتری ۲×۱۶ چهار بیتی با سیم‌بندی `PA6..PA12`، خواندن سه کلید active-high روی `PD9..PD11` با وقفه و debounce، نمایش شمارنده محدود صفر تا صد، حفظ عملکرد LEDها و تهیه گزارش آموزشی کامل و وضعیت تازه پروژه.

انجام‌شده:

- دیتاشیت `lcd016n002bcfhet.pdf` بررسی شد: کنترلر ST7066، آدرس سطرهای `0x00/0x40`، زمان فرمان عادی ۳۹ تا ۴۳ میکروثانیه، Clear/Home برابر ۱٫۵۳ میلی‌ثانیه و حداقل پالس E برابر ۱۴۰ نانوثانیه.
- کتابخانه مستقل `Libraries/CharacterLcd` با callbackهای GPIO/delay ساخته شد. API شامل init، clear/home، cursor، کاراکتر، رشته، اعداد signed/unsigned، کنترل cursor/blink، shift و هشت کاراکتر سفارشی CGRAM است.
- adapter و تست در `Application/Src/ui_counter.c` افزوده شد. مقدار عمومی `g_ui_counter_value` از صفر تا صد محدود است؛ `INC` یک واحد اضافه، `DEC` یک واحد کم و `RESET` آن را صفر می‌کند.
- ISR فقط بیت رخداد را ثبت می‌کند. تأیید فشار و رهاسازی هر کدام ۳۰ میلی‌ثانیه در حلقه اصلی انجام می‌شوند؛ نگه‌داشتن کلید repeat ندارد و bounce نباید بیش از یک رخداد بسازد.
- LCD فقط سه خانه عددی تغییرکرده را بازنویسی می‌کند و در مسیر عادی Clear نمی‌شود؛ بنابراین چشمک صفحه حذف و سرویس cooperative چراغ، دما و ADE7880 حفظ شده است.
- `STM32F107.ioc`، `main.h`، GPIO، NVIC، دو handler مشترک EXTI، PlatformIO و Keil با پایه‌ها و فایل‌های تازه همگام شدند. منطق محصول بیرون فایل‌های مولد باقی مانده است.
- README کتابخانه، README فریم‌ور و فصل ۱۷ گزارش شامل سیم‌بندی، زمان‌بندی، API، مثال، انتقال MCU، debounce، عیب‌یابی و چک‌لیست پذیرش افزوده شدند.
- محدودیت مهم دیتاشیت ثبت شد: در VDD پنج ولت، `VIH(min)=3.5V` است؛ خروجی ۳٫۳ ولتی STM32 تضمین‌شده نیست و راهکار سطح منطقی باید پیش از پذیرش محصول تأیید شود.

اعتبارسنجی:

- PlatformIO با `-Wall -Wextra -Werror` موفق است: `Flash=16560 bytes` و `RAM=3292 bytes`.
- فایل Keil از نظر XML معتبر است و `ui_counter.c`، `character_lcd.c` و include جدید را دارد؛ build واقعی Keil در ایستگاه دارای Keil باقی مانده است.
- گزارش در دو گذر XeLaTeX ساخته شد: ۹۰ صفحه A4. فصل تازه پس از رفع نویسه‌های لاتین خارج `lr` و overfull نهایی دوباره رندر و بازبینی شد.
- آزمون فیزیکی LCD، سطح منطقی، کلیدها و هم‌زمانی با LED/سنسورها هنوز باید طبق دو بند نخست کارهای باز توسط کاربر انجام شود.

## Historical session - 2026-10-03: active-low load cycler

The user confirmed the load-cycler application works on hardware and clarified that both relay drivers are active-low. CYCLER_RELAY_ACTIVE_HIGH is now 0: LOW connects, HIGH disconnects. PE1/PE2 are changed together, initialized OFF before output mode, and recorded HIGH in CubeMX. Other application behavior is retained.

The full previously uncommitted application is included: transactional three-stage settings, hold-to-cancel, accelerated buttons, cycle timing, electrical LCD display, alternating LEDs, and cooperative ADE startup. Libraries remain present; temperature processing is disabled by default. Settings remain in RAM. See embedded/stm32f107/LOAD_CYCLER.md for current behavior; older baseline notes above are historical.

Validation: PlatformIO build with -Wall -Wextra -Werror and ARM-emulated state-machine regression tests, including explicit LOW=ON/HIGH=OFF BSRR assertions. Physical validation of the corrected polarity requires flashing the updated binary. Keil hardware build remains a follow-up.

Repository: resolve the pre-existing .gitignore merge by retaining both sets of ignore rules; preserve the incoming MIT LICENSE. Record that merge separately from the application implementation. No push is performed; the user will push.

Open items: program and verify the corrected relay polarity; decide whether future settings should survive power loss; run the Keil build on the Keil workstation.

## Historical session - 2026-10-03: electrical readout compatibility and diagnostics

User reports relay cycling/UI work but electrical LCD fields show dashes. The previous refactor changed ADE SPI timeout from 20 ms to 2 ms. Restored the established 20 ms budget while retaining cooperative startup, existing wiring, calibration, active-low outputs, and LCD validity checks. This is a plausible software regression fix; the physical cause remains unconfirmed until the updated firmware is run or debugger values are supplied.

Added startup attempt/error counters, current/failed startup stage and retained last_error_status to g_app_electrical. State transitions now advance only after success so failure diagnostics identify the operation that actually failed. Sample timestamps are taken after the complete read.

Added tests/test_electrical.py exercising real ARM-compiled electrical app code plus the real ADE7880 driver against a simulated SPI/register model, including a 3 ms transfer, calibrated V/A/W/PF publication, read errors, retries and startup failure diagnosis. Existing cycler tests now also check offline/stale dashes and numeric display recovery.

Validation: both ARM tests pass; PlatformIO -Wall -Wextra -Werror build passes (Flash 16184 bytes, RAM 1056 bytes). No physical board is connected to this session. Follow-up: flash this version and verify online=true and successful_samples increases; if fields remain dashes, inspect last_error_status and failed_startup_stage. Watch expressions are documented in LOAD_CYCLER.md. Keil hardware build remains outstanding.

## آخرین نوبت کار — پایان جلسه 2026-10-03

کاربر اعلام کرد مشکل سخت‌افزاری برطرف و تمام برنامه شامل خواندن و نمایش پارامترهای الکتریکی درست کار می‌کند. جزئیات علت سخت‌افزاری گزارش نشده؛ یادداشت قبلیِ «نیاز به تأیید خواندن» اکنون تاریخی است. منطق برنامه در این نوبت تغییر نکرد.

انجام‌شده:

- خلاصه ابتدای همین فایل با وضعیت واقعی امروز، پایه‌ها، توالی منو، ذخیره RAM، لغو، سیکل و حالت‌های صفر، نمایش فعلی، متغیرهای Watch و نقطه شروع فردا جایگزین شد؛ خلاصه قدیمی به‌عنوان تاریخچه حفظ شد.
- فصل ۱۸ گزارش به برنامه نهایی اختصاص یافت و جلد، راهنمای خواندن، فصل‌های ۱، ۱۵ و ۱۷ و READMEها با ارجاع روشن به نسخه فعال هماهنگ شدند.
- گزارش نسخه ۱.۱ در دو گذر XeLaTeX ساخته شد: ۹۷ صفحه A4 و ۳۳۷۵۰۹ بایت. لاگ نهایی فاقد خطای TeX، هشدار، نویسه مفقود و overfull/underfull است. پیام عمومی ابزار درباره اجرای محیط با دسترسی بالا مربوط به محتوای سند نیست.
- همه صفحات در پنج تماس‌برگ و شش صفحه فصل تازه با وضوح بالاتر بررسی شدند؛ برش، هم‌پوشانی و خرابی جهت متن دیده نشد.
- هر دو آزمون ARM و ساخت PlatformIO دوباره موفق بودند: Flash=16184 bytes، RAM=1056 bytes. هیچ پروگرام یا آزمون سخت‌افزاری جدیدی توسط عامل اجرا نشد؛ تأیید عملی متعلق به کاربر است.
- کامیت نهایی این نوبت فقط مستندات و نقطه تحویل را ثبت می‌کند؛ پوش با کاربر است.

محل توقف: نسخه عملکردی تأییدشده و مستندات به‌روز آماده‌اند. کار بعدی محتمل، طراحی تغییر ظاهر دو سطر LCD با درخواست کاربر و اصلاح compose/number یا ثابت‌های نمایش است؛ رفتار کنترل فعلی بدون درخواست تغییر نکند. موضوعات باز در بخش جاری ابتدای فایل آمده‌اند.
