alirezaaies/es-ac-load-cycler/docs/chapters/00-title.tex

\begin{titlepage}
\centering
\vspace*{25mm}
{\color{ReportPrimary}\Huge\bfseries گزارش فنی، ممیزی و راهنمای توسعه\par}
\vspace{8mm}
{\LARGE سامانه پایش و کنترل اتاق آزمون\par}
\vspace{5mm}
{\Large مبتنی بر
\lr{STM32F107VCT6}
\par}
\vfill
{\large نسخه سند: ۱.۱\par}
{\large آخرین بازبینی: ۱۱ مهر ۱۴۰۵\par}
\vspace{15mm}
{\color{ReportSecondary}\rule{0.75\textwidth}{1pt}\par}
\vspace{5mm}
این سند مرجع پیاده‌سازی، نگه‌داری، تولید مجدد کد و توسعه پروژه است.
\end{titlepage}

\chapter*{راهنمای استفاده از سند}
نسخه فعال، برنامه سیکل قطع و وصل بار با رله‌های فعال‌پایین و نمایش همزمان پارامترهای الکتریکی است. مرجع رفتار فعلی و ادامه توسعه، فصل ۱۸ است. فصل‌های پیشین مرجع مراحل توسعه، کتابخانه‌ها و قابلیت‌های تاریخی‌اند؛ وجود یک قابلیت در مثال قدیمی به معنی فعال‌بودن آن در کاربرد امروز نیست. کاربر در تاریخ \lr{2026-10-03} کارکرد نسخه جاری را روی برد تأیید کرده است.

این گزارش براساس خواندن همه فایل‌های سورس، تنظیمات
\lr{STM32CubeMX}
، پروژه
\lr{Keil MDK}
و خروجی ساخت موجود تدوین شده است. ادعاهای عملکردی که تنها با اتصال برد قابل اثبات‌اند، با عنوان «نیازمند آزمون سخت‌افزاری» مشخص شده‌اند. فایل تنظیمات ظاهری گزارش
\filepath{docs/report-config.tex}
است و هر فصل در پوشه
\filepath{docs/chapters}
به‌صورت مستقل نگه‌داری می‌شود.
