alirezaaies/es-ac-load-cycler/docs/chapters/04-drivers-and-modules.tex

\chapter{درایورها، ماژول‌ها و وضعیت استفاده}

\section{درایور دمای دیجیتال}
زیرسامانه فعال دما چهار بخش دارد. کتابخانه
\filepath{Libraries/OneWire}
زمان‌بندی استاندارد، \lr{CRC8} و جست‌وجوی \lr{ROM} را مستقل از میکروکنترلر انجام می‌دهد؛
\filepath{Libraries/DS18B20}
فرمان‌های حسگر، تبدیل مقدار علامت‌دار و اعتبارسنجی حافظه موقت را فراهم می‌کند؛ مدیر
\filepath{Libraries/DS18B20Manager}
کشف چند گذرگاه، شماره‌گذاری پایدار و نمونه‌برداری بدون انتظار طولانی را بر عهده دارد؛ و
\filepath{Libraries/SensorAddressStore}
تنها لایه وابسته به \lr{STM32 HAL} برای ذخیره نگاشت در \lr{Flash} است.

گذرگاه صفر روی \lr{PB10} و گذرگاه یک روی \lr{PC7} قرار دارد. هر دو پایه در فایل \lr{CubeMX} به‌شکل خروجی تخلیه‌باز ثبت شده‌اند و به مقاومت بالاکش خارجی نیاز دارند. تبدیل همه حسگرهای هر گذرگاه با فرمان سراسری آغاز می‌شود، انتظار ۷۵۰ میلی‌ثانیه‌ای در ماشین حالت انجام می‌گیرد و هر حافظه موقت با \lr{Match ROM} و کنترل \lr{CRC} خوانده می‌شود.

سنسور تازه خودکار به اولین شماره خالی متصل می‌شود. مقدار و اعتبار به‌ترتیب در دو آرایه زیر منتشر می‌شوند:
\begin{itemize}
  \item \lr{g\_temperature\_c}
  \item \lr{g\_temperature\_valid}
\end{itemize}

رابط عمومی برنامه فقط همین دو آرایه، شمار هویت‌های ثبت‌شده و تابع
\lr{App\_TemperatureGetCelsius}
است. ساختار مدیر، \lr{ROM}، گذرگاه و توابع تخصیص داخل لایه اتصال برد پنهان مانده‌اند. آرایه‌ها نیز فقط پس از کشف یا خواندن تازه به‌روز می‌شوند، نه در هر دور حلقه اصلی. معماری، معرفی، تعویض و انتقال در فصل ۱۶ تشریح شده است.

\section{اندازه‌گیری انرژی}
ماژول قابل‌حمل
\lr{ADE7880}
روی
\lr{SPI2}
کار می‌کند و وابستگی مستقیم به \lr{HAL} ندارد. برنامه ولتاژ مؤثر، جریان مؤثر، توان اکتیو، توان ظاهری و ضریب توان هر سه فاز و جریان نول را در \lr{snapshot} سازگار می‌خواند. ضریب توان از رجیسترهای مستقل
\lr{APF/BPF/CPF}
گرفته می‌شود. خطا و \lr{timeout} به فراخواننده بازمی‌گردند و \lr{reset} حلقه نامحدود ندارد. شرح کامل اتصال، \lr{API}، کالیبراسیون و آزمون در فصل ۱۵ آمده است.

\section{رطوبت آنالوگ}
کانال فعال \lr{ADC} پس از هر ۲۰۰۰ نمونه میانگین‌گیری می‌شود. تبدیل فعلی چنین است: ولتاژ مرجع تجربی ۳.۳۳۶ ولت، آفست ۰.۸۵۳ ولت، شیب ۳۰ میلی‌ولت بر درصد و دو ضریب اصلاح ۱.۳ و ۱.۰۴. خروجی برای جلوگیری از فرمان نامعتبر به بازه صفر تا صد درصد محدود شده است. این ضرایب وابسته به برد و کالیبراسیون‌اند و باید در پرونده کالیبراسیون محصول ثبت شوند.

\section{حسگر رطوبت دیجیتال}
ماژول
\lr{AM2315}
در پروژه \lr{Keil} کامپایل می‌شود و
\lr{I2C1}
نیز راه‌اندازی شده است، اما فراخوانی آن در مسیر اجرایی وجود ندارد. پیاده‌سازی بازبینی‌شده کدهای بازگشت
\lr{HAL}
، ساختار پاسخ، علامت دما و
\lr{CRC16 Modbus}
را بررسی می‌کند. این ماژول برای سازگاری نگه داشته شده، ولی پیش از فعال‌سازی باید روی سخت‌افزار تست شود.

\section{فیلتر میانگین متحرک}
ماژول
\lr{MAF}
پیاده‌سازی پنجره ۴۰ نمونه‌ای دارد، اما نه در پروژه \lr{Keil} افزوده شده و نه در هیچ سورس فعال فراخوانی می‌شود. محاسبه آن در هر به‌روزرسانی کل پنجره را دوباره جمع می‌کند. برای استفاده آینده بهتر است جمع جاری عضو ساختار باشد تا هزینه ثابت شود. در نسخه فعلی حذف نشده، زیرا یک کتابخانه مستقل و قابل استفاده است؛ وضعیت غیرفعال آن باید حفظ شود.

\section{درایورهای \lr{HAL}}
ماژول‌های \lr{ADC}، \lr{DMA}، \lr{GPIO}، \lr{I2C}، \lr{SPI}، تایمر، \lr{UART}، \lr{Flash}، \lr{RCC}، توان، \lr{Cortex} و \lr{EXTI} در تنظیمات و پروژه \lr{Keil} حضور دارند. \lr{EXTI} کاربرد مستقیم ندارد ولی وابستگی زیرساختی \lr{HAL} است. فایل‌های \lr{LL} موجود در پوشه درایورها کامپایل نمی‌شوند. آثار آبجکت‌هایی مانند
\lr{ADE7753}
،
\lr{MCP4725}
در پوشه خروجی \lr{Keil} سورس متناظر ندارند و بخشی از محصول فعال نیستند.
