alirezaaies/es-ac-load-cycler/docs/chapters/13-generated-code-reference.tex

\chapter{مرجع توابع تولیدشده و راه‌اندازی سخت‌افزار}

این فصل بخش‌هایی را شرح می‌دهد که عمدتاً توسط
\lr{STM32CubeMX}
تولید می‌شوند. توضیح‌ها برای فهم رفتارند؛ کامنت دستی خارج از ناحیه‌های کاربر نباید به این فایل‌ها افزوده شود.

\section{فایل اصلی}

\subsection{تابع \lr{main}}
نقطه ورود پس از کد راه‌انداز پردازنده است. ابتدا
\lr{HAL}،
کلاک سامانه و به‌ترتیب پایه‌ها،
\lr{DMA}،
\lr{SPI}،
\lr{UART}،
سه تایمر،
\lr{I2C}
و
\lr{ADC}
را راه‌اندازی می‌کند. سپس ساختار دسته‌های کاربرد ساخته و
\lr{App\_Init}
فراخوانی می‌شود. حلقه بی‌نهایت فقط
\lr{App\_Process}
را اجرا می‌کند. مقدار بازگشت نظری عدد صحیح است، ولی حلقه هرگز پایان نمی‌یابد.

\subsection{تابع \lr{SystemClock\_Config}}
نوسان‌ساز خارجی هشت مگاهرتز، تقسیم ورودی یک و ضریب
\lr{PLL}
برابر نه را انتخاب می‌کند. کلاک پردازنده و گذرگاه پرسرعت ۷۲ مگاهرتز، گذرگاه اول ۳۶ مگاهرتز و گذرگاه دوم ۷۲ مگاهرتز می‌شوند. کلاک
\lr{ADC}
از تقسیم شش و برابر ۱۲ مگاهرتز است. هر خطای
\lr{HAL}
به
\lr{Error\_Handler}
می‌رود.

\subsection{تابع \lr{MX\_ADC1\_Init}}
مبدل نخست را در حالت اسکن و تبدیل پیوسته با دو رتبه تنظیم می‌کند. کانال ۵ رتبه اول و کانال ۴ رتبه دوم‌اند و هر دو زمان نمونه‌برداری ۲۳۹.۵ سیکل دارند. هم‌ترازی داده راست و شروع نرم‌افزاری است.
\lr{DMA}
در تابع پشتیبانی پیرامونی به دسته متصل می‌شود.

\subsection{تابع \lr{MX\_I2C1\_Init}}
رابط نخست را با سرعت صد کیلوهرتز، آدرس‌دهی هفت‌بیتی، بدون آدرس دوم، فراخوان عمومی یا کشش غیرفعال راه‌اندازی می‌کند. پایه‌ها در تابع پشتیبانی به
\lr{PB8}
و
\lr{PB9}
بازنگاشت می‌شوند.

\subsection{تابع \lr{MX\_SPI2\_Init}}
رابط دوم را ارباب تمام‌دوطرفه، هشت‌بیتی، پرارزش‌ترین بیت ابتدا، قطبیت بالا و نمونه‌برداری لبه دوم می‌کند. انتخاب تراشه نرم‌افزاری و تقسیم کلاک ۶۴ است؛ با کلاک گذرگاه ۳۶ مگاهرتز نرخ تقریبی ۵۶۲.۵ کیلوبیت‌برثانیه حاصل می‌شود.

\subsection{توابع \lr{MX\_TIM1\_Init}، \lr{MX\_TIM2\_Init} و \lr{MX\_TIM3\_Init}}
هر سه تایمر کلاک داخلی و شمارش افزایشی دارند. پیش‌تقسیم‌گر ۹۹۹۹ کلاک ۷۲ مگاهرتز را به ۷۲۰۰ هرتز می‌رساند. دوره ۷۱۹۹ در تایمرهای یک و سه رویداد یک‌ثانیه‌ای و دوره ۳۵۹۹ در تایمر دو رویداد نیم‌ثانیه‌ای می‌سازد. پیش‌بارگذاری خودکار غیرفعال است.

\subsection{تابع \lr{MX\_USART2\_UART\_Init}}
رابط دوم را با نرخ ۹۶۰۰، هشت بیت داده، یک توقف، بدون توازن و کنترل جریان، ارسال و دریافت هم‌زمان و نمونه‌برداری شانزده‌برابر تنظیم می‌کند.

\subsection{تابع \lr{MX\_DMA\_Init}}
کلاک کنترل‌کننده نخست را روشن و وقفه کانال یک را با اولویت پیش‌دستی دو و زیر‌اولویت یک فعال می‌کند. تنظیم جهت، اندازه داده و حالت چرخشی در تابع پشتیبانی
\lr{ADC}
انجام می‌شود.

\subsection{تابع \lr{MX\_GPIO\_Init}}
کلاک درگاه‌های
\lr{A}
تا
\lr{E}
را روشن، سطح اولیه خروجی‌های قدرت و خطوط یک‌سیمه را ایمن و سپس حالت پایه‌ها را تنظیم می‌کند. خطوط قدرت پوش‌پول کم‌سرعت‌اند. دو خط دما روی \lr{PB10} و \lr{PC7} از ابتدا خروجی تخلیه‌باز و در حالت آزاد بالا هستند؛ این تنظیم در فایل \lr{IOC} نیز ثبت شده است. تنظیم اولیه بالا برای خروجی‌های فعال‌پایین مانع پالس روشن ناخواسته می‌شود.

\subsection{تابع \lr{Error\_Handler}}
در نسخه مولد بدنه عملیاتی ندارد. بنابراین خطای راه‌اندازی فقط جریان همان تابع را برمی‌گرداند و سامانه ممکن است با پیرامونی ناقص ادامه دهد. تبدیل آن به خاموش‌سازی خروجی‌ها، ثبت علت و حلقه امن یا بازنشانی واچ‌داگ یک کار باز مهم است؛ پیاده‌سازی باید داخل ناحیه کاربر قرار گیرد.

\section{توابع پشتیبانی پیرامونی}

\subsection{تابع \lr{HAL\_MspInit}}
کلاک رابط عملکرد جایگزین و توان را روشن می‌کند و رابط
\lr{JTAG}
را غیرفعال ولی رابط
\lr{SWD}
را فعال نگه می‌دارد. بنابراین پایه‌های برنامه‌ریزی دو سیمه در دسترس و برخی پایه‌های
\lr{JTAG}
برای
\lr{GPIO}
آزاد می‌شوند.

\subsection{توابع \lr{HAL\_ADC\_MspInit} و \lr{HAL\_ADC\_MspDeInit}}
نسخه راه‌اندازی کلاک
\lr{ADC}
و درگاه
\lr{A}
را روشن، پایه‌های
\lr{PA4/PA5}
را آنالوگ، کانال نخست
\lr{DMA}
را انتقال پیرامونی به حافظه با افزایش نشانی حافظه، داده نیم‌کلمه و حالت چرخشی می‌کند. دسته
\lr{DMA}
به
\lr{ADC}
پیوند و وقفه فعال می‌شود. نسخه توقف همه این منابع را آزاد می‌کند.

\subsection{توابع \lr{HAL\_I2C\_MspInit} و \lr{HAL\_I2C\_MspDeInit}}
پایه‌های
\lr{PB8/PB9}
را خروجی عملکرد جایگزین تخلیه‌باز پرسرعت، بازنگاشت
\lr{I2C}
را فعال و کلاک رابط را روشن می‌کنند. تابع توقف کلاک و پایه‌ها را آزاد می‌سازد.

\subsection{توابع \lr{HAL\_SPI\_MspInit} و \lr{HAL\_SPI\_MspDeInit}}
برای رابط دوم، پایه کلاک و خروجی داده را عملکرد جایگزین پوش‌پول و ورودی داده را ورودی بدون کشش می‌کند. کلاک و وقفه
\lr{SPI}
فعال می‌شوند. تابع توقف ترتیب معکوس را انجام می‌دهد.

\subsection{توابع پشتیبانی تایمرها}
دو تابع
\lr{HAL\_TIM\_Base\_MspInit}
و
\lr{HAL\_TIM\_Base\_MspDeInit}
مسئول این بخش هستند.
براساس نمونه تایمر، کلاک و وقفه تایمر یک، دو یا سه را فعال یا غیرفعال می‌کنند. اولویت تایمر سه از تایمر دو بالاتر و هر دو از تایمر یک بالاتر تنظیم شده است؛ پس از بازآرایی
\lr{callback}ها
بسیار کوتاه‌اند.

\subsection{توابع \lr{HAL\_UART\_MspInit} و \lr{HAL\_UART\_MspDeInit}}
کلاک رابط دوم و درگاه
\lr{D}
را فعال، ارسال
\lr{PD5}
را عملکرد جایگزین و دریافت
\lr{PD6}
را ورودی می‌کند، بازنگاشت را فعال و وقفه
\lr{UART}
را با اولویت بالا روشن می‌سازد. تابع توقف این تنظیمات را آزاد می‌کند.

\section{هندلرهای استثنا و وقفه}
توابع خطای سخت، مدیریت حافظه، خطای گذرگاه و دستور نامعتبر پس از ورود در حلقه بی‌نهایت می‌مانند. وقفه تیک سامانه شمارنده میلی‌ثانیه
\lr{HAL}
را افزایش می‌دهد. وقفه‌های
\lr{DMA}،
\lr{ADC}،
سه تایمر،
\lr{SPI}
و
\lr{UART}
فقط هندلر
\lr{HAL}
متناظر را فراخوانی می‌کنند. هندلرهای سرویس سامانه، پایش اشکال و درخواست معوق بدنه کاربر ندارند. هیچ منطق محصولی نباید مستقیماً به این هندلرها بازگردانده شود.

\section{فایل سامانه و راه‌انداز}
فایل
\filepath{system\_stm32f1xx.c}
متغیر کلاک هسته و تنظیمات پایه پیش از ورود به برنامه را فراهم می‌کند. فایل اسمبلی
\lr{Keil}
جدول بردار، پشته، نقطه بازنشانی و انتقال به کتابخانه زمان اجرا را تعریف می‌کند.
\par\noindent
\lr{PlatformIO}
از نسخه متناظر چارچوب خود استفاده می‌کند و فایل سامانه محلی را برای جلوگیری از نماد تکراری کنار می‌گذارد.
