alirezaaies/es-ac-load-cycler/docs/chapters/01-overview.tex

\chapter{دامنه، هدف و نمای کلی سامانه}

این فصل دامنه کلی محصول و پایه توسعه را شرح می‌دهد. کاربرد فعال امروز، سیکل رله و نمایش اندازه‌گیری الکتریکی است که در فصل ۱۸ مستند شده است؛ پردازش دما، رطوبت و سریال همگی در این کاربرد فعال نیستند.

\section{کاربرد}
برد کنترل برای یک اتاق آزمون تجهیزات برودتی ساخته شده است. دو ایستگاه اندازه‌گیری، در مجموع ۳۲ حسگر دمای دیجیتال را می‌خوانند؛ دو حسگر دمای محیط روی دو گذرگاه مستقل نیز مرجع کنترل اتاق‌اند. رطوبت محیط از خروجی آنالوگ حسگر خانواده
\lr{HIH}
نمونه‌برداری می‌شود. مدار
\lr{ADE7880}
کمیت‌های الکتریکی دو کانال فعال را اندازه می‌گیرد. رایانه از طریق
\lr{RS-232}
داده‌ها را دریافت و رله‌ها، سرمایش، گرمایش، رطوبت‌ساز و نقطه‌های تنظیم را کنترل می‌کند.

\section{حدود نسخه حاضر}
این نسخه قابلیت تازه‌ای به محصول اضافه نمی‌کند. هدف آن حفظ رفتار شناخته‌شده، حذف خطرهای قطعی، جداسازی کد کاربردی از کد مولد، فراهم‌کردن ساخت با دو زنجیره ابزار و ایجاد مرجع نگه‌داری است. دو ایستگاه سوم و چهارم در قالب مخابراتی رزرو شده‌اند، ولی سخت‌افزار و منطق فعال ندارند.

\section{نمای جریان داده}
ترتیب منطقی اجرا چنین است:

\begin{enumerate}
  \item وقفه‌های تایمر تنها موعد اجرای کار را ثبت می‌کنند.
  \item حلقه اصلی کمیت الکتریکی، رطوبت و دما را در موعد مربوط می‌خواند.
  \item کنترل خودکار با هیسترزیس و پنجره زمانی هیتر خروجی‌ها را تنظیم می‌کند.
  \item یک قاب ثابت ۲۰۹ بایتی ساخته و روی درگاه سریال ارسال می‌شود.
  \item دریافت سریال به‌صورت وقفه‌ای و تک‌بایتی انجام و فرمان کامل در حلقه اصلی تفسیر می‌شود.
\end{enumerate}

\section{واحدهای مهم}
دمای محیط در داخل برنامه با واحد یک‌دهم درجه سلسیوس نگه‌داری می‌شود. داده ۳۲ حسگر ایستگاه‌ها برای سازگاری با نرم‌افزار قبلی به‌شکل مقدار خام حسگر، یعنی واحد یک‌شانزدهم درجه، ارسال می‌شود. رطوبت ارسالی یک‌دهم درصد و مقادیر چندبایتی همگی کم‌ارزش‌ترین بایت در ابتدا هستند.
