alirezaaies/es-ac-load-cycler/docs/chapters/02-hardware-cubemx.tex

\chapter{سخت‌افزار و تنظیمات مولد کد}

\warningbox{جدول کامل پیرامونی‌های این فصل معماری محصول پیش از پاک‌سازی را ثبت می‌کند. در \lr{snapshot} فعال این مرحله فقط کلاک سامانه، \lr{SWD}، دو \lr{LED} و \lr{SPI2/ADE7880} دوباره فعال شده‌اند؛ مراحل دقیق بازسازی فعلی در فصل ۱۵ است.}

\section{پردازنده و کلاک}
قطعه انتخاب‌شده
\lr{STM32F107VCT6}
در بسته
\lr{LQFP100}
است. نوسان‌ساز خارجی ۸ مگاهرتز با ضریب ۹، کلاک سامانه ۷۲ مگاهرتز می‌سازد. کلاک گذرگاه اول ۳۶ و گذرگاه دوم ۷۲ مگاهرتز است. کلاک مبدل آنالوگ ۱۲ مگاهرتز تنظیم شده است.

\section{پیرامونی‌های فعال}
\begin{longtable}{p{0.20\textwidth}p{0.70\textwidth}}
\toprule
پیرامونی & تنظیم و کاربرد \\
\midrule
\endhead
\lr{ADC1} & کانال‌های ۵ و ۴، اسکن پیوسته، زمان نمونه‌برداری ۲۳۹.۵ سیکل و انتقال چرخشی با کانال اول
\lr{DMA1}
؛ کانال نخست منبع فعال رطوبت است. \\
\lr{SPI2} & حالت ارباب، هشت‌بیتی، قطبیت بالا، لبه دوم، تقسیم کلاک ۶۴؛ ارتباط با
\lr{ADE7880}
و انتخاب تراشه روی پایه
\lr{PB12}
. \\
\lr{USART2} & نرخ ۹۶۰۰، هشت بیت، یک توقف، بدون توازن، ارسال و دریافت؛ پایه‌های بازنگاشت‌شده
\lr{PD5/PD6}
. \\
\lr{I2C1} & نرخ ۱۰۰ کیلوهرتز و بازنگاشت روی
\lr{PB8/PB9}
؛ برای کتابخانه حسگر
\lr{AM2315}
آماده است ولی در مسیر فعال استفاده نمی‌شود. \\
\lr{TIM1} & دوره یک ثانیه؛ موعد ارسال داده. \\
\lr{TIM2} & دوره نیم ثانیه؛ موعد انرژی، رطوبت، شمارنده استارت و پنجره هیتر. \\
\lr{TIM3} & دوره یک ثانیه؛ موعد خواندن حسگرهای دما. \\
\bottomrule
\end{longtable}

\section{پایه‌های کاربردی قطعی}
\begin{longtable}{p{0.18\textwidth}p{0.30\textwidth}p{0.42\textwidth}}
\toprule
پایه & نقش & نکته \\
\midrule
\endhead
\lr{PB10} & گذرگاه نخست
\lr{1-Wire}
& شانزده حسگر ایستگاه اول و حسگر محیط اول \\
\lr{PC7} & گذرگاه دوم
\lr{1-Wire}
& شانزده حسگر ایستگاه دوم و حسگر محیط دوم \\
\lr{PA5} & ورودی آنالوگ نخست & ورودی فعال محاسبه رطوبت \\
\lr{PA4} & ورودی آنالوگ دوم & نمونه‌برداری می‌شود ولی فعلاً مصرف کاربردی ندارد \\
\lr{PE1} & رطوبت‌ساز & فرمان فعال‌پایین \\
\lr{PE2} & رله ایستگاه اول & فرمان دستی فعال‌پایین \\
\lr{PE4,PE5} & دو خروجی سرمایش & هم‌زمان کنترل می‌شوند و فعال‌پایین‌اند \\
\lr{PB3} & هیتر یا
\lr{SSR}
& فعال‌پایین و دارای کنترل پنجره زمانی \\
\lr{PB12} & انتخاب تراشه انرژی & در حالت بی‌کار بالا \\
\lr{PA13,PA14} & برنامه‌ریزی و اشکال‌زدایی & رابط دو سیمه
\lr{SWD}
برای
\lr{J-Link}
؛ زمین و تغذیه مرجع نیز لازم است \\
\lr{PC13,PC14} & دو چراغ عیب‌یابی & خروجی پوش‌پول کم‌سرعت، سطح اولیه بالا و الگوی غیرمسدودکننده زنده‌بودن برنامه \\
\bottomrule
\end{longtable}

پایه‌های خروجی دیگر شامل
\lr{PE3, PE6, PB4, PD0, PD2, PD3, PD8, PD14, PD15, PC8}
در فایل مولد تعریف شده‌اند اما نقش دقیقشان از سورس معلوم نیست. دو پایه
\lr{PE6}
و
\lr{PD3}
مطابق رفتار نسخه قدیمی هنگام توقف کنترل در سطح بالا قرار می‌گیرند. پیش از حذف یا تغییر هرکدام باید شماتیک بررسی شود.

\section{ایمنی تولید مجدد}
گزینه نگه‌داشتن کد کاربر فعال، پشتیبان‌گیری نسخه قبلی فعال و حذف پیشین غیرفعال شده است. مقدار دوره تایمر دوم نیز از اختلاف خطرناک ۳۵ به مقدار عملیاتی ۳۵۹۹ همگام شد. پس از هر تولید مجدد باید تفاوت فایل‌ها بازبینی و وجود فراخوانی‌های
\lr{App\_Init}
و
\lr{App\_Process}
در بلوک‌های حفاظت‌شده کنترل شود.
