alirezaaies/es-ac-load-cycler/docs/chapters/03-software-architecture.tex

\chapter{معماری نرم‌افزار و مالکیت فایل‌ها}

\section{لایه‌ها}
فایل
\filepath{Core/Src/main.c}
راه‌اندازی تولیدشده و دو فراخوانی
\lr{App\_Init}
و
\lr{App\_Process}
را نگه می‌دارد. فایل
\filepath{Core/Src/stm32f1xx\_it.c}
فقط هندلرهای استاندارد
\lr{HAL}
را اجرا می‌کند. منطق فعال محصول در
\filepath{Application/Src/app.c}
قرار دارد. ماژول چراغ در همان لایه کاربرد و کتابخانه قابل‌حمل انرژی در
\filepath{Libraries/ADE7880/Src/ade7880.c}
جدا شده است.

کتابخانه‌های حسگر، میانگین‌گیری و ذخیره‌سازی قدیمی در پوشه
\filepath{Libraries}
حفظ شده‌اند، ولی در نسخه تمیز فعلی هنوز به چرخه برنامه متصل نیستند. وجود آن‌ها در پروژه ساخت به معنی فعال‌بودنشان در زمان اجرا نیست.

\section{قرارداد با فایل‌های تولیدی}
تنها تغییرات دستی مجاز در فایل مولد باید بین نشانگرهای
\lr{USER CODE BEGIN}
و
\lr{USER CODE END}
باشد. در نسخه حاضر، سرآیند کاربرد در بلوک شامل‌ها، فراخوانی راه‌اندازی در بلوک شماره ۲ و فراخوانی پردازش در حلقه حفاظت‌شده قرار دارند. منطق کاربرد نباید به فایل وقفه منتقل شود.

تنظیم پایه
\lr{ADE\_CS=PB12}
و رابط
\lr{SPI2}
در فایل
\filepath{STM32F107.ioc}
ثبت شده‌اند. پس از هر تولید مجدد باید تفاوت فایل‌ها در گیت، حالت ۳ رابط، کلاک مجاز و باقی‌ماندن بلوک‌های کاربر کنترل شوند.

\section{زمان‌بندی تعاونی}
نسخه فعال بدون تایمر کاربردی و بدون سیستم‌عامل کار می‌کند. تابع
\lr{App\_Process}
با
\lr{HAL\_GetTick}
موعد یک‌ثانیه‌ای نمونه و دوثانیه‌ای بازیابی ارتباط را کنترل می‌کند. اگر موعد نرسیده باشد بلافاصله بازمی‌گردد؛ بنابراین حلقه عادی تأخیر مسدودکننده ندارد.

ماژول چراغ نیز با همان الگوی تعاونی سرویس می‌شود. ادامه منظم الگو نشان می‌دهد حلقه اصلی هنوز در حال اجراست. خطای ارتباط
\lr{ADE7880}
الگوی سریع خطا را فعال می‌کند و اتصال موفق دوباره حالت عادی را برمی‌گرداند.

\section{هم‌روندی و انتشار داده}
در نسخه فعلی هیچ حالت مشترک میان وقفه و لایه کاربرد وجود ندارد. هندلرهای تولیدی فقط سرویس استاندارد
\lr{HAL}
را اجرا می‌کنند. حالت عمومی الکتریکی برای مشاهده دیباگر
\lr{volatile}
است، ولی تمام تغییرهای آن در متن حلقه اصلی انجام می‌شود.

هر نمونه کامل ابتدا در متغیر محلی ساخته می‌شود. فقط پس از موفقیت تمام خواندن‌های
\lr{A/B/C}
و نول، مقدارهای خام و مهندسی با هم منتشر می‌شوند؛ در نتیجه مصرف‌کننده داده نیمه‌تازه دریافت نمی‌کند.

\section{حافظه پایدار}
آخرین صفحه دو کیلوبایتی
\lr{Flash}
از نشانی
\lr{0x0803F800}
طبق طراحی قبلی برای جدول شناسه حسگر رزرو و از ناحیه لینک هر دو زنجیره ساخت حذف شده است. ماژول ذخیره‌سازی در مخزن باقی مانده، اما تا زمان بازگرداندن سنسورها از لایه کاربرد فعال فراخوانی نمی‌شود.

ضرایب کالیبراسیون
\lr{ADE7880}
فعلاً در
\lr{RAM}
هستند. جدول پیش‌فرض با هر بازنشانی بازمی‌گردد. ضرایب تأییدشده برای ماندگاری باید در مرحله بعد در کد ثابت یا حافظه غیرفرار ذخیره و هنگام راه‌اندازی نصب شوند.
