alirezaaies/es-ac-load-cycler/docs/chapters/17-character-lcd-buttons.tex

\chapter{نمایشگر کاراکتری و کلیدهای منو}

این فصل مرحله اولیه آزمون شمارنده و کتابخانه نمایشگر را مستند می‌کند. کتابخانه و سیم‌بندی همچنان استفاده می‌شوند، اما تست صفر تا صد، صفرکردن با کلید سوم و روش رخداد کلید زیر، شرح تاریخی‌اند. در نسخه فعال، کلید سوم منوی سیکل را کنترل می‌کند، نمونه‌برداری سطح و تکرار کلید در حلقه اصلی است و عملکرد نهایی در فصل ۱۸ آمده است.

\section{هدف و نتیجه این مرحله}
در این مرحله نمایشگر ۱۶ ستون و ۲ سطر مدل
\lr{LCD-016N002B-CFH-ET}
و سه کلید افزاینده، کاهنده و صفرکننده به مسیر اجرایی اضافه شدند. نمایشگر با گذرگاه چهار بیتی کار می‌کند، هر فشار معتبر کلید دقیقاً یک رخداد می‌سازد و مقدار روی بازه بسته صفر تا صد محدود می‌شود. حلقه اصلی همچنان سنجش انرژی، دما و الگوی دو چراغ تشخیصی را سرویس می‌کند.

نمایش اولیه چنین است:

\begin{latin}
\begin{lstlisting}
Counter test
Value:   0 /100
\end{lstlisting}
\end{latin}

فشار کلید اول یک واحد اضافه، کلید دوم یک واحد کم و کلید سوم مقدار را صفر می‌کند. در صفر، کلید کاهنده اثری ندارد و در صد، کلید افزاینده اثری ندارد. فقط سه خانه عددی بازنویسی می‌شوند؛ نمایشگر در هر تغییر پاک نمی‌شود و بنابراین چشمک ناشی از فرمان \lr{Clear Display} وجود ندارد.

\section{مبنای دیتاشیت و محدودیت الکتریکی مهم}
دیتاشیت ۲۶ صفحه‌ای \lr{Vishay} در
\filepath{datasheets/lcd016n002bcfhet.pdf}
بررسی شد. ماژول ۱۶ در ۲، کنترلر \lr{ST7066} یا معادل، فونت ۵ در ۸ و تغذیه منطقی نامی ۵ ولت دارد. سطر نخست از آدرس \lr{DDRAM 0x00} و سطر دوم از \lr{0x40} آغاز می‌شود. زمان اجرای فرمان عادی حدود ۳۹ میکروثانیه، نوشتن داده حدود ۴۳ میکروثانیه و \lr{Clear/Home} حدود ۱/۵۳ میلی‌ثانیه است. درایور برای حاشیه امن به‌ترتیب ۵۰ و ۱۶۰۰ میکروثانیه صبر می‌کند و پالس \lr{E} یک میکروثانیه است که از حداقل ۱۴۰ نانوثانیه بزرگ‌تر است.

\warningbox{در تغذیه ۵ ولت، دیتاشیت حداقل سطح بالای ورودی را \lr{0.7 VDD} یعنی ۳/۵ ولت اعلام می‌کند. خروجی ۳/۳ ولتی \lr{STM32} این شرط تضمین‌شده را برآورده نمی‌کند، هرچند ممکن است روی یک نمونه کار کند. برای محصول قابل اتکا باید مبدل سطح مناسب روی \lr{RS/E/DB4..DB7} استفاده شود یا نسخه و شرایط تغذیه سازگار با منطق ۳/۳ ولت با دیتاشیت همان قطعه تأیید شود.}

پایه \lr{R/W} به \lr{PA7} و یک مقاومت پایین‌کش متصل است. نرم‌افزار این پایه را خروجی پوش‌پول در سطح پایین نگه می‌دارد و \lr{Busy Flag} را نمی‌خواند. جهت \lr{DB4..DB7} همیشه خروجی می‌ماند و احتمال درگیری خروجی ۵ ولتی \lr{LCD} با \lr{GPIO} میکرو حذف می‌شود. پایین‌کش خارجی نیز هنگام بازنشانی مانع شناورشدن \lr{R/W} می‌شود.

\section{جدول پایه‌ها و تنظیم \lr{CubeMX}}
\begin{center}
\begin{tabular}{|c|c|c|}
\hline
سیگنال & پایه \lr{STM32} & حالت \lr{GPIO} \\
\hline
\lr{E} & \lr{PA6} & خروجی پوش‌پول، سطح پایین اولیه \\
\lr{R/W} & \lr{PA7} & خروجی پوش‌پول، همیشه سطح پایین \\
\lr{RS} & \lr{PA8} & خروجی پوش‌پول \\
\lr{DB4..DB7} & \lr{PA9..PA12} & چهار خروجی پوش‌پول \\
افزایش & \lr{PD9 / EXTI9} & وقفه لبه بالارونده، بدون مقاومت داخلی \\
کاهش & \lr{PD10 / EXTI10} & وقفه لبه بالارونده، بدون مقاومت داخلی \\
صفرکردن & \lr{PD11 / EXTI11} & وقفه لبه بالارونده، بدون مقاومت داخلی \\
\hline
\end{tabular}
\end{center}

کلیدها در سخت‌افزار پایین‌کش خارجی دارند و با فشار به تغذیه مثبت وصل می‌شوند؛ پس لبه بالارونده آغاز فشار است و \lr{GPIO\_NOPULL} انتخاب شده است. خطوط ۹ و ۱۰/۱۱ به‌ترتیب از بردارهای مشترک
\lr{EXTI9\_5}
و
\lr{EXTI15\_10}
استفاده می‌کنند. هر \lr{handler} فقط تابع استاندارد \lr{HAL} را برای پایه مربوط فراخوانی می‌کند.

همه نام‌ها، حالت پایه‌ها و فعال‌بودن \lr{NVIC} در
\filepath{STM32F107.ioc}
ثبت شده‌اند. \lr{PA13/PA14} برای \lr{SWD} باقی مانده‌اند. \lr{PA9/PA10} دیگر برای \lr{USART1} آزاد نیستند؛ اگر در آینده \lr{USART1} لازم شود باید \lr{LCD} یا \lr{UART} به پایه/واحد دیگری منتقل و \lr{IOC} هم‌زمان اصلاح شود.

\section{معماری نرم‌افزار}
کتابخانه قابل‌حمل در
\filepath{Libraries/CharacterLcd}
هیچ هدر \lr{STM32} یا \lr{HAL} را وارد نمی‌کند. ساختار \lr{CharacterLcd\_Config} پنج \lr{callback} و هندسه نمایشگر را می‌گیرد:

\begin{itemize}
  \item \lr{write\_rs}: انتخاب فرمان یا داده؛
  \item \lr{write\_rw}: اختیاری و در این برد فقط برای نگه‌داشتن سطح پایین؛
  \item \lr{write\_enable}: ساخت پالس فعال‌سازی؛
  \item \lr{write\_data4}: قراردادن نیم‌بایت روی \lr{DB4..DB7}؛
  \item \lr{delay\_us}: تأخیر کوتاه مستقل از نوع میکروکنترلر.
\end{itemize}

لایه برد و برنامه آزمایشی در
\filepath{Application/Src/ui_counter.c}
قرار دارد. این فایل \lr{callback}ها را به \lr{GPIO}های \lr{STM32} متصل، \lr{LCD} را مقداردهی، جهش کلیدها را حذف و مقدار آزمایشی را نمایش می‌دهد. \lr{app.c} فقط یک‌بار \lr{UiCounter\_Init} و در حلقه \lr{UiCounter\_Process} را فراخوانی می‌کند. متغیر
\lr{g\_ui\_counter\_value}
برای مشاهده مستقیم در \lr{Watch} در دسترس است.

\section{راه‌اندازی چهار بیتی و زمان‌بندی}
پس از پایدارشدن تغذیه، درایور ۵۰ میلی‌ثانیه صبر می‌کند. سپس \lr{RS=0} و \lr{R/W=0} شده، نیم‌بایت‌های شروع چهار بیتی ارسال می‌شوند و فرمان \lr{0x28} رابط چهار بیتی، دو سطر و فونت ۵ در ۸ را انتخاب می‌کند. بعد نمایش موقتاً خاموش، \lr{DDRAM} پاک، جهت حرکت مکان‌نما رو به راست و نمایش بدون \lr{cursor/blink} روشن می‌شود.

هر بایت ابتدا نیم‌بایت بالا و سپس پایین را می‌فرستد. \lr{callback} داده در برد حاضر هر چهار خط را با یک نوشتن رجیستر \lr{BSRR} عوض می‌کند. تمام تأخیرهای میکروثانیه از \lr{DWT CYCCNT} در فرکانس ۷۲ مگاهرتز می‌آیند. تنها انتظار نسبتاً بلند، ۵۰ میلی‌ثانیه راه‌اندازی یک‌باره هنگام بوت است؛ مسیر عادی کلیدها فاقد \lr{HAL\_Delay} است.

\section{مرجع توابع کتابخانه}
\begin{longtable}{|p{0.33\textwidth}|p{0.58\textwidth}|}
\hline
تابع & کاربرد \\
\hline
\endfirsthead
\hline
تابع & کاربرد \\
\hline
\endhead
\lr{CharacterLcd\_Init} & اعتبارسنجی \lr{callback}ها و هندسه و راه‌اندازی کنترلر؛ در موفقیت \lr{true}. \\
\hline
\lr{CharacterLcd\_Clear} & پاک‌کردن \lr{DDRAM} و رفتن به سطر/ستون صفر؛ برای نوسازی مکرر توصیه نمی‌شود. \\
\hline
\lr{CharacterLcd\_Home} & بازگشت مکان‌نما بدون پاک‌کردن متن. \\
\hline
\lr{CharacterLcd\_SetCursor} & انتخاب ستون و سطر صفرمبنا؛ برای مختصات خارج صفحه \lr{false}. \\
\hline
\lr{CharacterLcd\_PutChar} & نوشتن یک کد؛ نویسه خط جدید به ابتدای سطر بعد می‌رود و انتهای سطر شکسته می‌شود. \\
\hline
\lr{CharacterLcd\_Print} & نوشتن رشته \lr{C} خاتمه‌یافته با صفر. \\
\hline
\lr{CharacterLcd\_PrintUInt32} & تبدیل و نمایش عدد بدون \lr{sprintf}. \\
\hline
\lr{CharacterLcd\_PrintInt32} & نمایش عدد علامت‌دار و مدیریت امن \lr{INT32\_MIN}. \\
\hline
\lr{CharacterLcd\_SetDisplay} & کنترل نمایش، \lr{cursor} و \lr{blink} بدون حذف \lr{DDRAM}. \\
\hline
\lr{CharacterLcd\_Shift} & جابه‌جایی پنجره نمایش یک خانه. \\
\hline
\lr{CharacterLcd\_CreateChar} & نوشتن الگوی ۵ در ۸ در یکی از هشت جایگاه \lr{CGRAM} و بازگرداندن مکان‌نما. \\
\hline
\end{longtable}

نمونه ساده:

\begin{latin}
\begin{lstlisting}
CharacterLcd_Print(&lcd, "Voltage:");
CharacterLcd_SetCursor(&lcd, 0, 1);
CharacterLcd_PrintUInt32(&lcd, 230);
CharacterLcd_Print(&lcd, " V");
\end{lstlisting}
\end{latin}

نمونه کاراکتر سفارشی:

\begin{latin}
\begin{lstlisting}
static const uint8_t bell[8] = {
    0x04, 0x0E, 0x0E, 0x0E, 0x1F, 0x00, 0x04, 0x00
};
CharacterLcd_CreateChar(&lcd, 0, bell);
CharacterLcd_PutChar(&lcd, 0);
\end{lstlisting}
\end{latin}

مدل \lr{ET} جدول کاراکتر انگلیسی و اروپایی دارد؛ \lr{LCD} کاراکتری \lr{Unicode} و متن فارسی را مانند نمایشگر گرافیکی پشتیبانی نمی‌کند. تنها هشت شکل ۵ در ۸ را می‌توان هم‌زمان در \lr{CGRAM} تعریف کرد. بنابراین متن رابط فعلی عمداً \lr{ASCII} است.

\section{وقفه کوتاه و حذف جهش کلید}
تابع \lr{callback} وقفه \lr{HAL} فقط یک بیت در
\lr{button\_irq\_mask}
ثبت می‌کند. داخل \lr{ISR} هیچ نوشتن \lr{LCD}، تأخیر، تبدیل رشته، حلقه حذف جهش یا محاسبه برنامه انجام نمی‌شود. این پرچم در حلقه اصلی به‌صورت کوتاه و اتمیک برداشته می‌شود.

برای هر کلید یک حالت فشار و دو نامزد فشار/رهاسازی نگه‌داری می‌شود. پس از لبه بالارونده، پایه باید ۳۰ میلی‌ثانیه پیوسته در سطح بالا بماند تا فقط یک رخداد ساخته شود. سپس تا زمانی که پایه ۳۰ میلی‌ثانیه پیوسته در سطح پایین نشده، همه لبه‌های ناشی از جهش یا نگه‌داشتن کلید نادیده گرفته می‌شوند. نتیجه این است که نگه‌داشتن کلید تکرار خودکار ندارد و هر چرخه کامل فشار/رهاسازی حداکثر یک واحد تغییر می‌دهد.

این طراحی از سرریز شمارنده میلی‌ثانیه آسیب نمی‌بیند، زیرا زمان به‌صورت تفریق بدون علامت مقایسه می‌شود. حدگذاری پیش از افزایش/کاهش انجام می‌شود و نوع ۸ بیتی هرگز از صد عبور یا زیر صفر بازنمی‌گردد.

\section{حفظ \lr{LED} و کارهای هم‌زمان}
در هر دور \lr{App\_Process} ابتدا \lr{DiagnosticLed\_Process} و سپس \lr{UiCounter\_Process} اجرا می‌شوند و بعد ماشین حالت دما و نمونه‌برداری \lr{ADE7880} ادامه می‌یابد. الگوی \lr{LED} با شمارنده زمان جلو می‌رود و برای \lr{LCD} یا حذف جهش متوقف نمی‌شود. تغییر شمارنده فقط سه کاراکتر می‌نویسد و فرمان \lr{Clear} در مسیر فشار کلید وجود ندارد.

وقفه‌های کلید با اولویت ۵ فعال‌اند. بازه‌های کوتاه \lr{1-Wire} ناحیه بحرانی خود را دارند؛ اگر لبه کلید دقیقاً در آن بازه برسد، سخت‌افزار \lr{EXTI} آن را معلق نگه می‌دارد و پس از بازشدن وقفه ثبت می‌شود. حذف جهش سی میلی‌ثانیه‌ای تأخیر چند میکروثانیه‌ای را بی‌اثر می‌کند.

\section{انتقال به میکروکنترلر دیگر}
فقط پوشه
\filepath{Libraries/CharacterLcd}
به پروژه مقصد منتقل می‌شود. فایل سورس به ساخت و پوشه \lr{Inc} به مسیر هدر افزوده و \lr{callback}های \lr{GPIO} و تأخیر مقصد نوشته می‌شوند:

\begin{latin}
\begin{lstlisting}
CharacterLcd_Config config = {
    .context = &board,
    .write_rs = board_rs,
    .write_rw = board_rw,       /* NULL if R/W is tied low */
    .write_enable = board_e,
    .write_data4 = board_data,
    .delay_us = board_delay_us,
    .columns = 16,
    .rows = 2
};
CharacterLcd_Init(&lcd, &config);
\end{lstlisting}
\end{latin}

هیچ شماره پایه، رجیستر \lr{STM32} یا نمونه سراسری برد در کتابخانه وجود ندارد. برای \lr{LCD} چهارسطری، جابه‌جایی‌های رایج \lr{0x00,0x40,0x14,0x54} پشتیبانی شده‌اند؛ ماژولی با نگاشت متفاوت به توسعه کوچک پیکربندی آدرس نیاز دارد.

\section{حفاظت در برابر \lr{Generate Code}}
منطق \lr{LCD} و حذف جهش بیرون فایل‌های مولد، در \lr{Application} و \lr{Libraries} است. فراخوانی‌های اصلی از همان \lr{App\_Init/App\_Process} موجود در بلوک‌های \lr{USER CODE} عبور می‌کنند. پایه‌ها و \lr{NVIC} در \lr{IOC} ثبت شده‌اند تا \lr{CubeMX} بتواند \lr{main.h}، \lr{MX\_GPIO\_Init} و \lr{handler}ها را دوباره بسازد.

پس از هر \lr{Generate Code} باید تفاوت گیت کنترل شود، زیرا پروژه حاضر پیش از این مرحله نیز بخش‌هایی دست‌نویس در فایل‌های مولد داشته است. وجود پایه‌های \lr{PA6..PA12} و \lr{PD9..PD11}، دو \lr{IRQ}، فراخوانی‌های برنامه، مسیر هدر کتابخانه و عضویت دو فایل تازه در \lr{Keil} باید بررسی شود. فایل‌های \filepath{platformio.ini} و \filepath{STM32F107.uvprojx} هر دو همگام شده‌اند.

\section{روش آزمون روی برد}
\begin{enumerate}
  \item پیش از پروگرام، مشترک‌بودن زمین، اتصال کنتراست، محدودکننده جریان نور پس‌زمینه و پایین ماندن \lr{R/W} کنترل شود. سطح منطقی بالا نیز با راهکار مبدل سطح تأیید شود.
  \item پس از روشن‌شدن، دو متن ثابت و مقدار صفر باید بدون خانه‌های سیاه یا کاراکتر جابه‌جا دیده شوند. اگر فقط خانه سیاه است، ابتدا کنتراست و سپس توالی \lr{E/RS/DB4..DB7} بررسی شود.
  \item کلید افزایش یک‌بار فشرده و رها شود؛ مقدار باید دقیقاً یک شود. نگه‌داشتن کلید حداقل دو ثانیه نباید تغییر دیگری بسازد.
  \item هر کلید ۵۰ بار با سرعت‌های مختلف آزموده شود؛ هیچ پرش دوواحدی یا فشار گم‌شده پس از رهاسازی پایدار مجاز نیست.
  \item مقدار به صد رسانده و ده بار دیگر افزایش داده شود؛ باید صد بماند. سپس تا صفر کاهش و ده فشار اضافه امتحان شود؛ باید صفر بماند.
  \item در مقادیر میانی کلید بازنشانی آزموده شود. بازنشانی در صفر نیز نباید چشمک یا پاک‌شدن صفحه بسازد.
  \item هم‌زمان دو \lr{LED}، \lr{g\_app\_electrical.updated\_at\_ms} و داده دما دیده شوند تا توقف سرویس‌های قبلی رد شود.
  \item آزمون چندساعته در حضور نویز رله انجام و شکل موج تغذیه، \lr{E} و کلیدها ثبت شود. ساخت موفق جای این پذیرش سخت‌افزاری را نمی‌گیرد.
\end{enumerate}

\section{عیب‌یابی و اعتبارسنجی}
اگر نمایشگر خالی است، ترتیب بررسی تغذیه و کنتراست، زمین مشترک، سطح منطقی بالا، اتصال \lr{R/W}، نام پایه‌ها و پالس \lr{E} است. نمایش نیم‌بایت‌ها یا کاراکترهای بی‌معنا معمولاً از جابه‌جایی \lr{DB4..DB7} یا شروع نامعتبر چهار بیتی می‌آید. اگر کلید کار نمی‌کند، سطح آزاد باید نزدیک صفر و سطح فشار نزدیک تغذیه باشد و بیت معلق رجیستر \lr{EXTI} و \lr{handler} مشترک کنترل شوند.

هر دو سورس تازه با کل پروژه و گزینه‌های
\lr{-Wall -Wextra -Werror}
در \lr{PlatformIO} ساخته شدند. مصرف ساخت این مرحله ۱۶۵۶۰ بایت \lr{Flash} و ۳۲۹۲ بایت \lr{RAM} است. \lr{XML} پروژه \lr{Keil} و مسیرهای سورس/هدر همگام شده‌اند. این اعتبارسنجی قرارداد نوع‌ها، لینک \lr{IRQ}ها و حضور فایل‌ها را ثابت می‌کند؛ رفتار واقعی کنتراست، سطح منطقی، ترتیب سیم‌ها و جهش فقط روی برد قابل تأیید است.
