alirezaaies/es-ac-load-cycler/docs/chapters/18-load-cycler.tex

\chapter{برنامه نهایی سیکل قطع و وصل بار}
\label{chap:load-cycler}

\section{وضعیت تحویل و مرز اعتبار}
این فصل مرجع رفتار نسخه فعال در تاریخ ۱۱ مهر ۱۴۰۵، برابر با
\lr{2026-10-03}
است. فصل‌های پیشین مراحل توسعه و کتابخانه‌ها را نگه می‌دارند؛ تست شمارنده صفر تا صد فصل ۱۷ دیگر برنامه فعال نیست. کاربر عملکرد نمایشگر، کلیدها، سیکل رله‌ها و خواندن و نمایش پارامترهای الکتریکی را روی برد تأیید کرده است. خط تیره‌های اندازه‌گیری ناشی از یک مشکل سخت‌افزاری بود که کاربر برطرف کرد؛ علت جزئی سخت‌افزار اعلام نشده است. بازگرداندن مهلت انتقال از ۲ به ۲۰ میلی‌ثانیه اصلاح سازگاری نرم‌افزار است و نباید علت قطعی آن مشکل تلقی شود.

تأیید کارکرد به معنای کالیبراسیون آزمایشگاهی همه کانال‌ها یا آزمون طولانی‌مدت نیست. نسخه جاری آماده ادامه توسعه ظاهر نمایشگر است؛ منطق کنترل و اندازه‌گیری در این نوبت تغییر نمی‌کند.

\section{پایه‌ها و قطبیت خروجی}
\begin{center}
\begin{tabular}{|c|c|p{0.52\textwidth}|}
\hline
بخش & پایه & رفتار نسخه فعال \\
\hline
کلید ۱ & \lr{PD9} & افزایش؛ فعال با سطح بالا \\
کلید ۲ & \lr{PD10} & کاهش؛ فعال با سطح بالا \\
کلید ۳ & \lr{PD11} & تأیید کوتاه و ورود یا لغو با نگه‌داشتن \\
رله نول & \lr{PE1} & صفر: وصل؛ یک: قطع \\
رله فاز & \lr{PE2} & صفر: وصل؛ یک: قطع \\
چراغ‌ها & \lr{PC13/PC14} & یکی‌درمیان؛ با قطبیت قبلی برد \\
نمایشگر & \lr{PA6..PA12} & همان اتصال چهار بیتی فصل ۱۷ \\
سنجش انرژی & \lr{PB12..PB15} & انتخاب تراشه و گذرگاه \lr{SPI2} فصل ۱۵ \\
\hline
\end{tabular}
\end{center}

تابع \lr{relays()} هر دو خروجی را با یک نوشتن \lr{GPIOE BSRR} تغییر می‌دهد. هنگام راه‌اندازی، سطح بالا پیش از خروجی‌شدن پایه‌ها نوشته می‌شود تا رله‌ها غیر فعال باشند. سطح اولیه در \lr{CubeMX} نیز بالا ثبت شده است. همزمانی فرمان نرم‌افزار تأییدکننده همزمانی مکانیکی کنتاکت‌ها نیست.

\section{توالی صفحات و منوها}
در بوت، پیام خوش‌آمد و سپس \lr{www.agfaco.com} هر کدام دو ثانیه نمایش داده می‌شوند. بعد صفحه اصلی با وضعیت \lr{Idle} باز می‌شود؛ تعداد پیش‌فرض صفر و مدت پیش‌فرض روشن و خاموش به‌ترتیب سه و دو ثانیه است. تست خودکار در بوت آغاز نمی‌شود.

\begin{enumerate}
\item نگه‌داشتن کلید ۳ برای سه ثانیه در صفحه اصلی، منوی تعداد سیکل را باز می‌کند. تست جاری متوقف و هر دو رله قطع می‌شوند.
\item کلید ۱ مقدار را زیاد و کلید ۲ کم می‌کند. فشار کوتاه کلید ۳ منوی زمان روشن را باز می‌کند.
\item تأیید زمان روشن، منوی زمان خاموش را باز می‌کند.
\item تأیید زمان خاموش هر سه مقدار را یکجا اعمال و پیام \lr{Settings saved} را نمایش می‌دهد.
\item فشار کوتاه بعدی کلید ۳ پیام را می‌بندد و تست جدید را از سیکل یک شروع می‌کند.
\end{enumerate}

تأیید کوتاه هنگام رهاسازی کلید و پس از حذف جهش تشخیص داده می‌شود؛ نگه‌داشتن طولانی، رخداد تأیید کوتاه تولید نمی‌کند. کلیدهای ۱ و ۲ در صفحه اصلی عمل تنظیمی ندارند. خروج طولانی از تنظیمات در هر یک از سه مرحله، همه تغییرات موقت را لغو می‌کند و تست با تنظیمات قبلی از ابتدا شروع می‌شود؛ ادامه از وسط سیکل قبلی پیاده نشده است.

\section{محدوده، جهش‌گیری و شتاب کلیدها}
بازه تعداد شامل صفر تا ۱۰۰۰۰۰ و بازه هر مدت شامل صفر تا ۳۰۰ ثانیه است. حذف جهش فشار و رهاسازی به پایداری ۳۰ میلی‌ثانیه‌ای سطح نیاز دارد. با تک‌فشار، تغییر یک واحد است؛ تکرار نگه‌داشتن پس از ۵۰۰ میلی‌ثانیه آغاز و هر ۱۲۰ میلی‌ثانیه انجام می‌شود. نخستین ۲۰ تغییر، شامل تغییر اولیه فشار، یک‌واحدی‌اند و از تغییر بعدی گام پنج‌واحدی می‌شود. رهاکردن و فشار دوباره شتاب را بازنشانی می‌کند.

عبور از مرز با حساب مدولار روی بازه بسته انجام می‌شود: افزایش یک واحد از بیشینه به صفر و کاهش یک واحد از صفر به بیشینه می‌رود. برای گام پنج‌واحدی، فاصله عبور از مرز هم حفظ می‌شود؛ مثلاً افزایش پنج واحد از ۹۹۹۹۹ نتیجه سه دارد.

\section{اعمال اتمی و نگه‌داری تنظیمات}
آرایه \lr{settings} سه مقدار اعمال‌شده و آرایه \lr{draft} نسخه موقت را نگه می‌دارد. ترتیب هر دو، تعداد، زمان روشن و زمان خاموش است. ورود به منو نسخه اعمال‌شده را کپی می‌کند؛ تأیید دو مرحله نخست فقط صفحه را عوض می‌کند و هنوز \lr{settings} تغییر نمی‌کند. فقط تأیید مرحله سوم کل نسخه موقت را کپی می‌کند.

ذخیره این نسخه در \lr{RAM} است؛ قطع تغذیه یا بازنشانی، تنظیمات را به پیش‌فرض برمی‌گرداند. داده نگاشت حسگرهای دما در صفحه رزروشده \lr{Flash} مستقل است و برای ذخیره تنظیمات سیکل استفاده نمی‌شود.

\section{سیکل، شمارش معکوس و حالت‌های صفر}
مثال تعداد ده، روشن سه ثانیه و خاموش دو ثانیه: سیکل یک با وصل هر دو رله شروع می‌شود؛ زمان روشن از سه به صفر می‌رود، خروجی‌ها قطع و زمان خاموش از دو به صفر می‌رود. سپس شماره دو و همین توالی تکرار می‌شود. پایان مرحله خاموش سیکل ده، خروجی‌ها را قطع نگه می‌دارد و \lr{Done} نشان می‌دهد؛ شماره یازده تولید نمی‌شود. شماره سیکل افزایشی و زمان هر مرحله کاهشی است.

تعداد صفر تست اجرا نمی‌کند. زمان روشن صفر، هیچ پالس وصلی نمی‌سازد و تنها مدت خاموش هر سیکل طی می‌شود. زمان خاموش صفر، فاصله خاموش زمان‌دار ندارد و در مرز سیکل تغییر سریع قطع و وصل رخ می‌دهد؛ برای قطع واقعی مکانیکی باید هر دو مدت مثبت باشند. هر دو مدت صفر، بلافاصله پایان را اعلام می‌کنند.

\section{چیدمان ۱۶ در ۲ و توسعه ظاهر}
\begin{latin}
\begin{lstlisting}
V230.1P9999T   1
A 12.3PF0.98*  3
\end{lstlisting}
\end{latin}

ستون اول ولتاژ و جریان، ستون وسط توان و قدرمطلق ضریب توان، و ستون راست شماره سیکل و زمان باقی‌مانده را نشان می‌دهد. پیش‌فرض ولتاژ و جریان یک رقم اعشار، توان بدون اعشار و ضریب توان دو رقم اعشار است. علامت ستاره نشان‌دهنده وصل و خط تیره نشان‌دهنده قطع است. مقادیر عددی راست‌چین‌اند و خانه‌های تغییرکرده بدون پاک‌کردن کل صفحه بازنویسی می‌شوند.

برای مقدار بزرگ، دقت اعشار ابتدا کاهش می‌یابد و سپس پسوندهای \lr{k/M/G} استفاده می‌شوند؛ عدد از ستون بیرون نمی‌زند. دو خط تیره یعنی داده نامعتبر، کهنه یا ارتباط قطع است؛ صفر واقعی در خواندن موفق به‌صورت عدد صفر نمایش داده می‌شود.

برای شماره بزرگ‌تر از ۹۹۹۹، شماره شش‌رقمی در ستون راست دو سطر تقسیم می‌شود. \lr{T0010} بالا و \lr{C 00} پایین یعنی سیکل ۰۰۱۰۰۰. سطر پایین هر دو ثانیه میان ادامه شماره و شمارش زمان یا پیام پایان عوض می‌شود؛ ستون‌های اندازه‌گیری ثابت می‌مانند. ظرفیت ۳۲ خانه اجازه نمایش همزمان همه ارقام و همه برچسب‌ها را نمی‌دهد.

برای تغییر ظاهر در نوبت بعد، تابع \lr{compose()} در
\filepath{embedded/stm32f107/Application/Src/ui_counter.c}
محل ساخت دو سطر است. تابع \lr{number()} قالب عدد، راست‌چینی و فشرده‌سازی مقدار بزرگ را انجام می‌دهد. زمان‌ها، قطبیت، فاز انتخاب‌شده و اعشار مطلوب در
\filepath{embedded/stm32f107/Application/Inc/cycler_config.h}
متمرکزند. نام تاریخی \lr{ui\_counter.c} برای حفظ عضویت فایل در پروژه \lr{Keil} نگه داشته شده است.

\section{خواندن موازی و متغیرهای دیباگر}
\lr{App\_Process()} سرویس چراغ‌ها، رابط کاربر و خواندن انرژی را در حلقه اصلی اجرا می‌کند. مبنای زمان \lr{SysTick} یک‌میلی‌ثانیه‌ای میکرو است. انتظار روشن‌شدن و ریست \lr{ADE7880} با ماشین حالت انجام می‌شود؛ انتقال \lr{SPI} همچنان \lr{HAL polling} با مهلت ۲۰ میلی‌ثانیه و نوشتن نمایشگر با مکث‌های کوتاه لازم برای سخت‌افزار است. این معماری مشارکتی، تضمین زمان واقعی سخت یا \lr{DMA/RTOS} ندارد. مهلت مرحله رله از لبه واقعی محاسبه می‌شود تا عقب‌افتادگی به پالس‌های جبرانی متوالی منجر نشود.

همه فازها و جریان نول هر ثانیه خوانده می‌شوند؛ صفحه پیش‌فرض فاز \lr{A} را با واحدهای \lr{V/A/W} نشان می‌دهد. در خطای ارتباط، بازیابی پس از دو ثانیه تلاش می‌شود. نمایش عدد نیازمند ارتباط فعال، نمونه جدیدتر از سه ثانیه و پرچم اعتبار هر کمیت است. کتابخانه دما حفظ شده ولی پردازش آن در کاربرد فعلی با \lr{CYCLER\_ENABLE\_TEMPERATURE=0} غیرفعال است؛ چراغ‌ها در خطای ارتباط نیز یکی‌درمیان ادامه دارند.

\begin{latin}
\begin{lstlisting}
g_app_electrical.voltage_v[0]
g_app_electrical.current_a[0]
g_app_electrical.active_power_w[0]
g_app_electrical.power_factor_abs[0]
g_app_electrical.power_factor[0]
g_app_electrical.voltage_valid[0]
g_app_electrical.current_valid[0]
g_app_electrical.active_power_valid[0]
g_app_electrical.power_factor_valid[0]
g_app_electrical.online
g_app_electrical.successful_samples
g_app_electrical.updated_at_ms
g_app_electrical.last_status
g_app_electrical.last_error_status
g_app_electrical.startup_attempts
g_app_electrical.startup_errors
g_app_electrical.startup_stage
g_app_electrical.failed_startup_stage
g_app_electrical.communication_errors
g_app_electrical.raw.phase[0]
\end{lstlisting}
\end{latin}

اندیس صفر، یک و دو به‌ترتیب فازهای \lr{A/B/C} هستند. مقادیر نخست ولت، آمپر، وات، قدرمطلق و مقدار علامت‌دار ضریب توان‌اند. \lr{successful\_samples} با هر نمونه کامل افزایش می‌یابد؛ \lr{last\_error\_status} آخرین خطا را در تلاش‌های موفق بعدی هم حفظ می‌کند و به‌تنهایی نشانه خطای جاری نیست. وضعیت موفق صفر، آرگومان نامعتبر یک، خطای گذرگاه دو، پایان مهلت سه و عدم تطابق بازخوانی چهار است.

مرحله‌های راه‌اندازی به‌ترتیب صفر: بیکار؛ یک: انتظار تغذیه؛ دو: پالس انتخاب تراشه؛ سه: قفل رابط؛ چهار: درخواست ریست؛ پنج: انتظار پایان ریست؛ شش: شروع پردازنده؛ هفت: خواندن نسخه هستند. برای اشکال‌یابی، وضعیت فعلی و شمار نمونه‌ها همراه با آخرین خطا و مرحله شکست بررسی شوند.

\section{آزمون‌ها و نقطه شروع فردا}
ساخت \lr{PlatformIO} با \lr{-Wall -Wextra -Werror} موفق است: ۱۶۱۸۴ بایت \lr{Flash} و ۱۰۵۶ بایت \lr{RAM}. پروژه \lr{Keil} از نظر ساختار معتبر است ولی ساخت واقعی در محیط \lr{Keil} در این جلسه انجام نشده است.

\begin{latin}
\begin{lstlisting}
python embedded/stm32f107/tests/test_cycler.py
python embedded/stm32f107/tests/test_electrical.py
\end{lstlisting}
\end{latin}

آزمون نخست، کد واقعی کامپایل‌شده برای \lr{ARM} را برای منو، حذف جهش، نگه‌داشتن، شتاب، مرزها، لغو و تأیید اتمی، ده سیکل سه/دو، زمان صفر، سرریز زمان، قطبیت رله و حدود نمایش اجرا می‌کند. آزمون دوم، کد کاربرد الکتریکی و درایور واقعی را با مدل رجیستر و انتقال شبیه‌سازی‌شده برای راه‌اندازی، انتشار مقادیر کالیبره، خطا و بازیابی بررسی می‌کند. وابستگی آن‌ها \lr{Python unicorn} و کامپایلر \lr{ARM GCC} نصب‌شده \lr{PlatformIO} است؛ مدل شبیه‌سازی جای برد واقعی نیست.

شروع نوبت بعد از \filepath{PROJECT_STATUS.md} و همین فصل است. برای تغییر نمایش، ابتدا طرح دو سطر و رفتار اعداد بزرگ تعیین، سپس فقط \lr{compose()/number()} یا ثابت‌های نمایش اصلاح و آزمون‌ها با خروجی جدید هماهنگ شوند. تغییر منو، ذخیره دائمی یا کنترل رله فقط با درخواست جدید انجام شود. کالیبراسیون دقیق، آزمون طولانی‌مدت و بررسی‌های تولید صنعتی موضوعات مستقل و باز هستند.
