alirezaaies/es-ac-load-cycler/docs/chapters/10-application-function-reference.tex

\chapter{مرجع کامل توابع لایه کاربرد}

این فصل مرجع نسخه فعال لایه کاربرد در فایل‌های
\filepath{Application/Inc/app.h}
و
\filepath{Application/Src/app.c}
است. فایل مولد
\filepath{Core/Src/main.c}
فقط پس از آماده‌شدن پایه‌ها و
\lr{SPI2}
تابع راه‌اندازی را صدا می‌زند و سپس تابع پردازش را در حلقه اصلی اجرا می‌کند. منطق
\lr{ADE7880}
و چراغ‌های عیب‌یابی بیرون از فایل مولد باقی می‌ماند.

\section{حالت عمومی قابل مشاهده در دیباگر}
برای دما، رابط معمول سه نماد ساده دارد:
\begin{itemize}
  \item \lr{g\_temperature\_c[N-1]} دمای سنسور شماره \lr{N}؛
  \item \lr{g\_temperature\_valid[N-1]} اعتبار همان مقدار؛
  \item \lr{g\_temperature\_sensor\_count} تعداد هویت‌های ثبت‌شده.
\end{itemize}
کشف و تخصیص نخستین شماره خالی خودکار است و برنامه عادی تابعی را از دیباگر فراخوانی نمی‌کند. تابع \lr{App\_TemperatureGetCelsius} فقط هنگام وجود نمونه معتبر \lr{true} برمی‌گرداند.
این تنها تابع عمومی دما در لایه کاربرد است؛ \lr{API}های کشف، تخصیص و پاک‌کردن و همچنین ساختار مدیر از هدر ساده حذف شده‌اند تا کد مصرف‌کننده به جزئیات \lr{ROM}، گذرگاه و ماشین حالت وابسته نشود.

متغیر سراسری
\lr{g\_app\_electrical}
از نوع
\lr{App\_ElectricalState}
است و برای پنجره
\lr{Watch}
طراحی شده است. اندیس صفر، یک و دو همیشه به‌ترتیب فازهای
\lr{A/B/C}
هستند. مهم‌ترین اعضا عبارت‌اند از:

\begin{longtable}{p{0.34\textwidth}p{0.56\textwidth}}
\toprule
عضو & معنی و شرط استفاده \\
\midrule
\endhead
\lr{online} & آخرین راه‌اندازی و نمونه کامل ارتباطی موفق بوده است. \\
\lr{last\_status} & نتیجه دقیق آخرین عملیات کتابخانه. \\
\lr{successful\_samples} & شمار نمونه‌های کامل و موفق. \\
\lr{communication\_errors} & شمار خطاهای خواندن پس از برقراری ارتباط. \\
\lr{raw.phase[0..2]} & شمارهای مستقیم رجیستر برای ولتاژ، جریان، \lr{W}، \lr{VA} و \lr{PF} هر فاز. \\
\lr{voltage\_v[0..2]} & ولتاژ \lr{RMS} برحسب ولت، فقط وقتی \lr{valid} متناظر درست است. \\
\lr{current\_a[0..2]} & جریان \lr{RMS} برحسب آمپر، فقط وقتی \lr{valid} متناظر درست است. \\
\lr{active\_power\_w[0..2]} & توان اکتیو علامت‌دار برحسب وات. \\
\lr{apparent\_power\_va[0..2]} & توان ظاهری برحسب ولت‌آمپر. \\
\lr{power\_factor[0..2]} & ضریب توان علامت‌دار از منفی یک تا مثبت یک. \\
\lr{power\_factor\_abs[0..2]} & بزرگی ضریب توان از صفر تا یک. \\
\lr{neutral\_current\_a} & جریان \lr{RMS} نول برحسب آمپر. \\
\lr{...\_source} & منشأ ضریب: بدون ضریب، پیش‌فرض آغازکار یا ضریب کاربر. \\
\bottomrule
\end{longtable}

هیچ مقدار مهندسی بدون بررسی پرچم
\lr{valid}
متناظر استفاده نشود. هنگام تغییر ضریب یا جهت
\lr{CT}
مقدار قبلی و خروجی نمایشی همان لحظه صفر و \lr{valid} نادرست می‌شوند؛ مقدار تازه با نخستین نمونه موفق بعدی منتشر می‌شود.

\section{توابع اصلی چرخه اجرا}

\subsection{تابع \lr{App\_Init}}
ورودی، نشانی دسته
\lr{SPI}
است که پیش‌تر توسط
\lr{MX\_SPI2\_Init}
راه‌اندازی شده است. تابع مراحل زیر را انجام می‌دهد:

\begin{enumerate}
  \item ماژول چراغ عیب‌یابی و تمام حالت عمومی را مقداردهی اولیه می‌کند؛
  \item واحدهای نمایشی پیش‌فرض و جهت عادی سه \lr{CT} را قرار می‌دهد؛
  \item جدول کامل ضرایب آغازکار \lr{A/B/C} و جریان نول را بارگذاری می‌کند؛
  \item \lr{callback}های مستقل از میکرو را به توابع \lr{HAL} متصل می‌کند؛
  \item رابط \lr{SPI} را انتخاب، تراشه را بازنشانی و پردازشگر اندازه‌گیری را اجرا می‌کند؛
  \item نتیجه را در حالت عمومی و الگوی چراغ ثبت می‌کند.
\end{enumerate}

اشاره‌گر تهی پذیرفته نمی‌شود، ولی برنامه در راه‌اندازی قفل نمی‌کند؛ وضعیت خطا ثبت و حلقه اصلی بعداً تلاش مجدد انجام می‌دهد.

\subsection{تابع \lr{App\_Process}}
این تابع ورودی و خروجی ندارد و باید پیوسته در
\lr{while(1)}
فراخوانی شود. در هر اجرا ابتدا چراغ غیرمسدودکننده را سرویس می‌کند. اگر موعد نرسیده باشد بلافاصله بازمی‌گردد. در حالت آنلاین هر یک ثانیه یک نمونه کامل سه‌فاز و نول می‌خواند؛ در شکست، حالت آفلاین و الگوی خطا فعال می‌شوند. در حالت آفلاین هر دو ثانیه راه‌اندازی دوباره آزمایش می‌شود.

داده ابتدا در متغیر محلی خوانده می‌شود. فقط اگر همه رجیسترها موفق باشند، \lr{raw} و تمام مقدارهای مهندسی با هم منتشر می‌شوند؛ بنابراین ساختار عمومی هرگز مخلوطی از فاز تازه و قدیمی ندارد.

\section{ضرایب پیش‌فرض و بازنشانی}

\subsection{تابع \lr{\small App\_ResetCalibrationToDefaults}}
جدول ثابت
\lr{default\_calibration}
را برای ولتاژ، جریان، توان اکتیو و توان ظاهری هر سه فاز و جریان نول کپی می‌کند. همه مقدارهای قبلی صفر و پرچم‌های
\lr{valid}
نادرست می‌شوند. منبع همه خانه‌ها مقدار
\lr{\small APP\_CALIBRATION\_DEFAULT}
می‌گیرد. سپس خروجی‌های نمایش نیز تازه می‌شوند.

این تابع در
\lr{App\_Init}
خودکار اجرا می‌شود و در زمان اجرا نیز برای کنارگذاشتن همه ضرایب کاربر قابل فراخوانی است. ضرایب پیش‌فرض فاز
\lr{C}
و نول موقت‌اند و باید با مرجع واقعی تأیید شوند.

\section{نصب و محاسبه کالیبراسیون فاز}

\subsection{تابع \lr{App\_SetVoltageCalibration}}
یک رابط کوتاه سازگار برای نصب
\lr{scale/offset}
ولتاژ یک فاز است و درون خود تابع عمومی نصب فاز را فراخوانی می‌کند.

\subsection{تابع \lr{App\_SetPhaseCalibration}}
سه ورودی دارد: نوع کمیت، فاز و نشانی ضریب خطی. کمیت مجاز یکی از ولتاژ \lr{RMS}، جریان \lr{RMS}، توان اکتیو یا توان ظاهری است. تابع فقط خانه انتخاب‌شده را جایگزین می‌کند، \lr{source} همان خانه را کاربر قرار می‌دهد و مقدار قبلی و نمایش وابسته را تا نمونه بعدی پاک می‌کند. آرگومان تهی، فاز نامعتبر یا کمیت خارج از \lr{enum} با
\lr{ADE7880\_STATUS\_INVALID\_ARGUMENT}
رد می‌شود.

\subsection{تابع \lr{\small App\_CalibratePhaseMultiPoint}}
دو یا چند زوج میانگین \lr{raw/reference} را به تابع قابل‌حمل کمترین‌مربعات می‌دهد، یک خط
\lr{engineering = raw * scale + offset}
می‌سازد و آن را برای کمیت و فاز انتخابی نصب می‌کند. سه تا پنج نقطه دور از هم توصیه می‌شود. دو خروجی اختیاری، ضریب دقیق نصب‌شده و بیشترین خطای باقیمانده نقاط را برمی‌گردانند.

اگر جهت نرم‌افزاری \lr{CT} برای توان اکتیو معکوس باشد، تابع علامت ضرایب داخلی را طوری هماهنگ می‌کند که \lr{reference} همچنان خروجی نهایی مورد انتظار کاربر باشد.

\section{کالیبراسیون جریان نول}

\subsection{تابع \lr{App\_SetNeutralCurrentCalibration}}
یک جفت ضریب را برای رجیستر
\lr{NIRMS}
نصب می‌کند. مقدار قبلی صفر، \lr{valid} نادرست و \lr{source} برابر کاربر می‌شود. مقدار جدید پس از نمونه موفق بعدی منتشر خواهد شد.

\subsection{تابع \lr{\small App\_CalibrateNeutralCurrentMultiPoint}}
همان برازش چندنقطه‌ای را با \lr{reference} برحسب آمپر انجام می‌دهد و نتیجه را از مسیر تابع نصب نول فعال می‌کند. ضریب و بیشترین خطای باقیمانده هر دو خروجی اختیاری هستند.

\section{جهت ترانس جریان و واحد نمایش}

\subsection{تابع \lr{App\_SetCurrentPolarity}}
فاز و یکی از دو مقدار
\lr{NORMAL/REVERSED}
را می‌گیرد. حالت معکوس فقط علامت توان اکتیو و \lr{PF} علامت‌دار را اصلاح می‌کند؛ جریان \lr{RMS}، توان ظاهری و بزرگی \lr{PF} تغییر نمی‌کنند. پس از تغییر، مقادیر علامت‌دار قبلی و نمایش توان همان لحظه پاک و تا نمونه بعدی نامعتبر می‌شوند.

تشخیص خودکار جهت انجام نمی‌شود، زیرا توان منفی ممکن است صادرات واقعی باشد. جهت باید یک بار هنگام راه‌اندازی فیزیکی تعیین شود.

\subsection{تابع \lr{App\_SetDisplayUnits}}
دو ضریب مثبت برای نمایش جریان و توان می‌گیرد. پیش‌فرض‌ها ۱۰۰ واحد بر آمپر و ۱۰ واحد بر وات/ولت‌آمپر هستند؛ بنابراین
\lr{0.17 A}
به شکل ۱۷ و
\lr{23.1 W}
به شکل ۲۳۱ دیده می‌شوند. این تابع فقط فیلدهای نمایش را تغییر می‌دهد و هیچ اثری روی \lr{SI}، \lr{raw} یا کالیبراسیون ندارد.

\section{توابع داخلی مهم}

\begin{longtable}{p{0.34\textwidth}p{0.56\textwidth}}
\toprule
تابع & مسئولیت \\
\midrule
\endhead
\lr{update\_display\_values} & ساخت خروجی نمایشی فقط از مقدار \lr{SI} معتبر. \\
\lr{publish\_linear\_value} & اعمال یک ضریب یا انتشار صفر و \lr{valid} نادرست. \\
\lr{update\_engineering\_values} & تبدیل متقارن \lr{A/B/C}، اصلاح جهت و تبدیل \lr{Q1.15} مربوط به \lr{PF}. \\
\lr{initialize\_ade} & اتصال رابط انتقال، اجرای آغازکار و انتخاب زمان نمونه یا تلاش مجدد. \\
\lr{phase\_calibration\_slot} & نگاشت \lr{enum} کمیت به خانه درست ساختار ضرایب. \\
\lr{invalidate\_phase\_value} & پاک‌کردن مقدار قبلی و ثبت منبع ضریب جدید. \\
\bottomrule
\end{longtable}

چهار رابط محلی نیز نتیجه
\lr{HAL}
را به وضعیت کتابخانه تبدیل و عملیات ارسال، دریافت، انتخاب تراشه و تأخیر را فراهم می‌کنند. این وابستگی‌ها فقط در لایه کاربرد هستند؛ کتابخانه
\lr{ADE7880}
هیچ هدر \lr{STM32} را شامل نمی‌کند.

\section{الگوی استفاده تک‌فاز و سه‌فاز}
برای محصول تک‌فاز فقط اندیس
\lr{ADE7880\_PHASE\_A}
مصرف می‌شود. برای دو کانال، \lr{A} و \lr{B} مستقل‌اند. محصول سه‌فاز \lr{A/B/C} را می‌خواند. نصب کالیبراسیون یک خانه هیچ ضریب دیگری را عوض نمی‌کند. در پروژه‌ای با چند تراشه نیز برای هر \lr{IC} یک
\lr{ADE7880\_Device}
و رابط انتقال مستقل ساخته می‌شود؛ نمونه سراسری داخل کتابخانه وجود ندارد.

\section{چک‌لیست استفاده صحیح}
\begin{enumerate}
  \item ابتدا \lr{online} و \lr{last\_status} کنترل شوند.
  \item مقدار \lr{raw} و مقدار مهندسی متناظر هم‌زمان دیده شوند.
  \item هیچ مقدار مهندسی بدون \lr{valid} متناظر مصرف نشود.
  \item \lr{source} پیش‌فرض به معنی ضریب موقت آغازکار است؛ برای دقت نهایی هر کانال جدا کالیبره شود.
  \item ضریب بازگشتی تأییدشده در کد یا حافظه غیرفرار ذخیره شود، زیرا ضریب زمان اجرا با \lr{reset} از بین می‌رود.
  \item ثانویه \lr{CT} هنگام عبور جریان اولیه هرگز باز نشود.
\end{enumerate}
