alirezaaies/es-ac-load-cycler/docs/chapters/11-driver-function-reference.tex

\chapter{مرجع کامل توابع درایورها}

\section{ذخیره شناسه حسگر}

\subsection{تابع \lr{crc8\_maxim}}
ورودی آن اشاره‌گر داده و طول است و
\lr{CRC}
هشت‌بیتی بازتاب‌یافته با چندجمله‌ای
\lr{0x8C}
را برمی‌گرداند. تابع فقط داخلی است و برای هفت بایت نخست شناسه یک‌سیمه استفاده می‌شود.

\subsection{تابع \lr{crc32\_record}}
روی تمام بایت‌های رکورد به‌جز فیلد
\lr{CRC}
نهایی اجرا می‌شود. مقدار آغازین همه یک، چندجمله‌ای بازتاب‌یافته
\lr{0xEDB88320}
و خروجی معکوس‌شده است. هدف تشخیص رکورد ناقص، فرسوده یا متعلق به نسخه دیگر است.

\subsection{تابع \lr{SensorAddressStore\_IsValidRom}}
یک شناسه هشت‌بایتی می‌گیرد. اشاره‌گر تهی، کد خانواده غیر از ۲۸ یا
\lr{CRC}
نامنطبق نتیجه نادرست می‌دهد. این تابع هم برای فرمان جدید رایانه و هم اعتبارسنجی کل جدول استفاده می‌شود.

\subsection{تابع \lr{table\_is\_valid}}
تمام ۳۲ ردیف جدول را به تابع اعتبارسنجی شناسه می‌دهد و با نخستین خطا بازمی‌گردد. سیاست فعلی جدول ناقص را نمی‌پذیرد؛ بنابراین تعویض یک حسگر تنها وقتی ذخیره می‌شود که همه ردیف‌های دیگر نیز معتبر باشند.

\subsection{تابع \lr{SensorAddressStore\_Load}}
رکورد صفحه پایانی
\lr{Flash}
را بدون کپی اولیه بررسی می‌کند. امضا، نسخه، تعداد،
\lr{CRC}
رکورد و
\lr{CRC}
تک‌تک شناسه‌ها باید درست باشند. در موفقیت، جدول به خروجی کپی می‌شود. در شکست، جدول خام قدیمی بررسی می‌شود و در صورت اعتبار، علاوه بر کپی خروجی به قالب جدید ذخیره می‌شود. اگر هر دو نامعتبر باشند نتیجه نادرست است و لایه کاربرد از پیش‌فرض‌ها استفاده می‌کند.

\subsection{تابع \lr{SensorAddressStore\_Save}}
ابتدا کل جدول ورودی را اعتبارسنجی و یک رکورد محلی می‌سازد. سپس
\lr{Flash}
را باز، دقیقاً یک صفحه را پاک و رکورد را کلمه‌به‌کلمه می‌نویسد و در پایان
\lr{Flash}
را قفل می‌کند. هر خطای
\lr{HAL}
نتیجه نادرست می‌دهد. چون پاک‌کردن صفحه برگشت‌ناپذیر و نوشتن مسدودکننده است، تابع فقط در حلقه اصلی فراخوانی می‌شود.

\section{درایور \lr{ADE7880}}

\warningbox{این بخش رفتار نسخه قدیمی درایور را برای سابقه بازآرایی ثبت می‌کند. مرجع \lr{API} فعال و اصلاح‌شده، فصل ۱۵ و فایل \filepath{Libraries/ADE7880/Inc/ade7880.h} است.}

\subsection{تابع \lr{ADE7880\_ReadRegister}}
ورودی‌ها نمونه درایور، نشانی ۱۶بیتی رجیستر، تعداد بایت و مهلت
\lr{HAL}
هستند. بافر چهار‌بایتی داخلی صفر، فرمان خواندن و نشانی ارسال، سپس یک تا چهار بایت دریافت می‌شود. انتخاب تراشه پیرامون کل تراکنش پایین و بالا می‌رود. داده در
\lr{TEMP}
نمونه درایور قرار می‌گیرد و وضعیت خطای
\lr{HAL}
هنوز به فراخواننده بازگردانده نمی‌شود.

\subsection{تابع \lr{ADE7880\_WriteRegister}}
داده ۳۲بیتی را متناسب با طول یک، دو یا چهار بایت با ترتیب پرارزش‌ترین بایت آماده می‌کند، فرمان نوشتن و نشانی را پیشوند می‌دهد و تراکنش
\lr{SPI}
را زیر انتخاب تراشه انجام می‌دهد. طول‌های دیگر نباید ارسال شوند و در نسخه آینده بهتر است نوع نتیجه برای خطا افزوده شود.

\subsection{تابع \lr{ADE7880\_ConfigSPI}}
دسته
\lr{SPI}
و پایه انتخاب تراشه را در نمونه درایور ذخیره می‌کند. سه بار انتخاب تراشه را تغییر می‌دهد تا رابط سریال مدار روی
\lr{SPI}
قرار گیرد، سپس رجیستر پیکربندی دوم را می‌نویسد تا انتخاب قفل شود. پس از بازنشانی سخت‌افزاری باید دوباره اجرا شود.

\subsection{تابع \lr{ADE7880\_Run}}
رجیستر اجرای پردازشگر داخلی مدار را با مقدار یک می‌نویسد. ورودی فقط نمونه درایور است و پس از ارسال یک میلی‌ثانیه صبر می‌کند.

\subsection{تابع \lr{ADE7880\_ReadVRMS}}
سه رجیستر ولتاژ مؤثر فازهای
\lr{A}
تا
\lr{C}
را به‌ترتیب می‌خواند. هر مقدار ۲۴بیتی از سه بایت پایانی بافر ساخته و در ساختار فاز ذخیره می‌شود. تبدیل به ولت در این تابع انجام نمی‌شود.

\subsection{تابع \lr{ADE7880\_ReadIRMS}}
مانند تابع ولتاژ است، با این تفاوت که سه جریان فاز و جریان نول را تازه می‌کند. خروجی‌ها هنوز شمار خام رجیستر هستند.

\subsection{تابع \lr{ADE7880\_ReadPowerz}}
توان حقیقی و توان ظاهری هر سه فاز را از شش رجیستر ۳۲بیتی می‌خواند. داده در اعضای
\lr{WATT}
و
\lr{VA}
قرار می‌گیرد. علامت توان حقیقی باید مطابق قالب دیتاشیت تفسیر شود؛ ساختار از نوع علامت‌دار استفاده می‌کند.

\subsection{تابع \lr{ADE7880\_ReadFPower}}
چهار رجیستر توان حقیقی، راکتیو، ظاهری و ضریب توان بنیادی را می‌خواند و براساس ورودی انتخاب فاز در ساختار
\lr{A}،
\lr{B}
یا
\lr{C}
می‌گذارد. این رجیسترها اشتراکی‌اند؛ بنابراین فراخواننده باید پیش‌تر بیت انتخاب فاز رجیستر پیکربندی را تنظیم کرده باشد. برنامه فعلی این تابع را استفاده نمی‌کند.

\subsection{تابع \lr{ADE7880\_Reset}}
بیت بازنشانی نرم‌افزاری را در رجیستر پیکربندی می‌نویسد و همان رجیستر را تا صفرشدن بیت بررسی می‌کند. حلقه مهلت کلی ندارد؛ قطع ارتباط
\lr{SPI}
می‌تواند راه‌اندازی را متوقف کند. افزودن شمارنده تلاش یکی از اصلاحات ضروری آینده است.

\section{پشته \lr{OneWire} و \lr{DS18B20}}

\subsection{توابع پایه \lr{OneWire}}
تابع \lr{OneWire\_Init} اتصال سخت‌افزاری مبتنی بر \lr{callback} را اعتبارسنجی و خط را آزاد می‌کند. توابع \lr{OneWire\_Reset}، \lr{OneWire\_WriteBit} و \lr{OneWire\_ReadBit} زمان‌بندی استاندارد را اجرا می‌کنند.

نمونه‌های بایتی، هشت بیت را کم‌ارزش‌ترین بیت در ابتدا جابه‌جا می‌کنند. \lr{OneWire\_Crc8} چندجمله‌ای دالاس/مکسیم را برای \lr{ROM} و حافظه موقت محاسبه می‌کند.

\subsection{جست‌وجوی شناسه}
\lr{OneWire\_SearchFirst} حالت جست‌وجو را پاک و نخستین \lr{ROM} معتبر را برمی‌گرداند.

\lr{OneWire\_SearchNext} اختلاف بعدی در درخت بیت‌ها را دنبال می‌کند.

ساختار \lr{OneWire\_SearchState} متعلق به فراخواننده است؛ بنابراین چند گذرگاه یا چند نمونه کتابخانه متغیر سراسری مشترک ندارند.

\subsection{فرمان‌های \lr{DS18B20}}
\lr{DS18B20\_StartConversion} برای یک \lr{ROM} مشخص یا با ورودی تهی برای همه حسگرهای گذرگاه فرمان تبدیل می‌فرستد. \lr{DS18B20\_ReadScratchpad} نه بایت را می‌خواند و پیش از موفقیت \lr{CRC} را کنترل می‌کند؛ وقتی دقیقاً یک حسگر روی گذرگاه باشد، \lr{ROM} این تابع و تابع \lr{blocking} می‌تواند تهی باشد. \lr{DS18B20\_DecodeRaw} علامت دما را حفظ و \lr{DS18B20\_RawToCelsius} واحد یک‌شانزدهم درجه را به سلسیوس تبدیل می‌کند. مسیر \lr{blocking} برای پروژه کوچک مناسب است و \lr{runtime} محصول از مدیر غیرمسدودکننده استفاده می‌کند.

\subsection{مدیر چندگذرگاهی}
\lr{DS18B20\_ManagerInit} پیکربندی، زمان و \lr{callback}های ذخیره را دریافت و نگاشت معتبر را بارگذاری می‌کند. ثبت شناسه تازه و تعویض بدون ابهام رفتار ثابت آن است. \lr{DS18B20\_ManagerDiscover} همه گذرگاه‌ها را جست‌وجو و حضور شماره‌های ذخیره‌شده را تازه می‌کند.

\lr{API}های تخصیص و پاک‌کردن برای ابزار تعمیراتی باقی مانده‌اند. \lr{DS18B20\_ManagerProcess} تبدیل سراسری، انتظار موعد و حداکثر یک خواندن آدرس‌دار را پیش می‌برد و فقط هنگام تغییر اطلاعات عمومی \lr{true} برمی‌گرداند. جزئیات نگاشت و خطاها در فصل ۱۶ آمده است.

\section{درایور \lr{AM2315}}

\subsection{تابع \lr{am2315\_crc16}}
تابع داخلی،
\lr{CRC}
شانزده‌بیتی بازتاب‌یافته مودباس را با مقدار آغازین
\lr{0xFFFF}
و چندجمله‌ای
\lr{0xA001}
محاسبه می‌کند. ورودی داده و طول و خروجی
\lr{CRC}
است.

\subsection{تابع \lr{TEMP\_HUM}}
چهار ورودی آن دسته
\lr{I2C}،
بافر فرمان سه‌بایتی، بافر پاسخ هشت‌بایتی و آرایه دو عدد اعشاری خروجی است. ابتدا حسگر را با مرحله نشانی بیدار، سپس فرمان خواندن چهار رجیستر را ارسال و پاسخ را دریافت می‌کند. کد تابع، طول،
\lr{CRC}،
علامت دما و وضعیت
\lr{HAL}
بررسی می‌شوند. در موفقیت رطوبت و دما نوشته و رطوبت بازگردانده می‌شود؛ در شکست هر دو خروجی صفر و پرچم خطا یک می‌شود. این ماژول در مسیر فعال فعلی فراخوانی نمی‌شود.

\section{فیلتر \lr{MAF}}

\subsection{تابع \lr{MAF\_Init}}
اشاره‌گر یک نمونه فیلتر را می‌گیرد، معکوس طول پنجره را محاسبه، میانگین و همه ۴۰ خانه را صفر و اشاره‌گر نوشتن را روی خانه نخست قرار می‌دهد. باید پیش از به‌روزرسانی فراخوانی شود.

\subsection{تابع \lr{MAF\_Update}}
نمونه جدید را در خانه جاری می‌نویسد و اشاره‌گر را حلقوی جلو می‌برد. سپس همه ۴۰ خانه را جمع و میانگین را ذخیره و برمی‌گرداند. ورودی دوم داده جدید است. هزینه هر فراخوانی خطی است و نمونه‌های صفر اولیه در شروع روی نتیجه اثر دارند.

\subsection{تابع \lr{Average}}
اشاره‌گر آرایه و تعداد اعضا را می‌گیرد و میانگین حسابی برمی‌گرداند. اندازه صفر کنترل نشده و باعث تقسیم بر صفر می‌شود؛ فراخواننده موظف است اندازه مثبت بدهد. این تابع و کل ماژول در برنامه فعلی استفاده نمی‌شوند.
