alirezaaies/es-ac-load-cycler/docs/chapters/06-serial-protocol.tex

\chapter{پروتکل سریال رایانه}

\section{لایه انتقال}
رابط روی ۹۶۰۰ بیت‌برثانیه، هشت بیت داده، یک بیت توقف و بدون توازن است. هر فرمان ۱۲ بایت دارد. اگر فرمان کوتاه‌تر است، فرستنده باید با صفر آن را تا ۱۲ بایت پر کند. هیچ مجموع مقابله با خطا، شماره توالی یا گریز از قاب در نسخه قدیمی تعریف نشده است؛ برای کابل نویزی افزودن نسخه دوم پروتکل توصیه می‌شود.

\section{فرمان‌ها}
\begin{longtable}{>{\raggedleft\arraybackslash}p{0.19\textwidth}p{0.70\textwidth}}
\toprule
پیشوند & اثر \\
\midrule
\endhead
\lr{S1FF / S1NN} & خاموش یا روشن کردن رله ایستگاه اول روی
\lr{PE2}
. \\
\lr{S2FF / S2NN} & خاموش یا روشن کردن خروجی
\lr{PE1}
؛ با فرمان‌های رطوبت هم‌پوشان است. \\
\lr{COLF / COLN} & خاموش یا روشن کردن هر دو خروجی سرمایش. \\
\lr{HUMF / HUMN} & خاموش یا روشن کردن رطوبت‌ساز. \\
\lr{HETF / HETN} & خاموش یا روشن کردن هیتر. \\
\lr{SETP} & بایت‌های ۴ و ۵ دما و بایت‌های ۶ و ۷ رطوبت، بدون علامت، کم‌ارزش ابتدا و با مقیاس یک‌دهم. \\
\lr{TMP} & بایت ۳ شماره یک‌مبنای حسگر و بایت‌های ۴ تا ۱۱ شناسه \lr{ROM}؛ بازه و \lr{CRC} بررسی و سپس کل جدول ذخیره می‌شود. \\
\lr{AUTOFF}
و
\lr{AUTONN}
& غیرفعال یا فعال کردن کنترل خودکار. \\
\lr{EXIT} & بازتاب ۱۲ بایت، خاموش‌سازی خروجی‌ها و بازنشانی پردازنده. \\
\bottomrule
\end{longtable}

\section{قاب داده ۲۰۹ بایتی}
\begin{longtable}{p{0.20\textwidth}p{0.18\textwidth}p{0.52\textwidth}}
\toprule
بازه بایت & قالب & معنا \\
\midrule
\endhead
۰ تا ۳ & ثابت & سرآیند
\lr{AA BB CC DD}
\\
۴ & هشت‌بیتی & مقدار ۲۰۴، طول داده پس از این بایت \\
۵ تا ۱۲ & چهار عدد ۱۶بیتی & ولتاژ، جریان، توان و ضریب توان ایستگاه اول \\
۱۳ تا ۲۰ & چهار عدد ۱۶بیتی & همان کمیت‌ها برای ایستگاه دوم \\
۲۱ تا ۳۶ & صفر رزرو & انرژی ایستگاه‌های سوم و چهارم \\
۳۷ تا ۶۸ & شانزده عدد ۱۶بیتی & دماهای خام ایستگاه اول \\
۶۹ تا ۱۰۰ & شانزده عدد ۱۶بیتی & دماهای خام ایستگاه دوم \\
۱۰۱ تا ۱۶۴ & صفر رزرو & دمای ایستگاه‌های سوم و چهارم \\
۱۶۵ تا ۱۶۶ & ۱۶بیتی & دمای محیط با واحد یک‌دهم درجه \\
۱۶۷ تا ۱۶۸ & ۱۶بیتی & رطوبت محیط با واحد یک‌دهم درصد \\
۱۶۹ تا ۱۷۲ & دو عدد ۱۶بیتی & شمارنده استارت دو کانال، ضرب‌شده در ده برای سازگاری \\
۱۷۳ تا ۱۷۶ & صفر رزرو & شمارنده ایستگاه‌های سوم و چهارم \\
۱۷۷ تا ۲۰۴ & دنباله ثابت & مقادیر ۷ تا ۳۴ ده‌دهی؛ نقش کاربردی ناشناخته \\
۲۰۵ تا ۲۰۸ & ثابت & پایان
\lr{FC FD FE FF}
\\
\bottomrule
\end{longtable}

تمام اعداد ۱۶بیتی به ترتیب کم‌ارزش‌ترین بایت و سپس پرارزش‌ترین بایت‌اند. آستانه اعتبار ولتاژ ۱۰۰ تا کمتر از ۳۰۰۰ است؛ بیرون این بازه سه کمیت اصلی همان ایستگاه صفر می‌شوند. ضریب توان فعلاً همواره صفر است.
