alirezaaies/es-ac-load-cycler/docs/chapters/12-refactoring-details.tex

\chapter{شرح جزئی بازآرایی و مرز تغییرات}

\section{وضعیت پیش از بازآرایی}
فایل وقفه علاوه بر هندلرهای مولد، مالک تقریباً همه حالت‌های برنامه، ۲۰۹ متغیر پراکنده قاب، خواندن ۳۴ حسگر، تراکنش‌های انرژی، محاسبات اعشاری، ارسال مسدودکننده و تفسیر فرمان بود. فایل اصلی نیز آدرس‌ها، کنترل خروجی و
\lr{callback}
مبدل آنالوگ را نگه می‌داشت. این پراکندگی وابستگی دوطرفه با تعداد زیادی
\lr{extern}
ساخته و تولید مجدد
\lr{CubeMX}
را پرخطر کرده بود.

\section{انتقال مالکیت}
تمام داده‌های محصول به متغیرهای ایستای
\filepath{app.c}
منتقل شدند. فایل اصلی اکنون فقط دسته‌های
\lr{HAL}
را در یک ساختار می‌گذارد. فایل وقفه فقط هندلر تولیدشده را صدا می‌زند و
\lr{callback}های
\lr{HAL}
در فایل کاربرد قرار دارند. در نتیجه جریان وابستگی یک‌طرفه است: فایل مولد، رابط عمومی کاربرد را می‌شناسد؛ کاربرد از دسته‌های تزریق‌شده استفاده می‌کند؛ درایورها از سیاست محصول آگاه نیستند.

\section{تبدیل وقفه به کار معوق}
پیش‌تر تایمر اول داخل وقفه ۲۰۹ بایت ارسال می‌کرد؛ تایمر دوم همه تراکنش‌های
\lr{SPI}
و محاسبه رطوبت را انجام می‌داد؛ تایمر سوم ۳۴ تراکنش دما داشت. اکنون
\lr{callback}
تایمر فقط یک پرچم منطقی می‌نویسد و عملیات در حلقه اصلی اجرا می‌شود. این تغییر زمان انسداد وقفه را به چند دستور کاهش می‌دهد و از گرسنگی
\lr{UART}
و تداخل زمان‌بندی جلوگیری می‌کند.

\section{فشرده‌سازی قاب مخابراتی}
متغیرهای جداگانه بایت پایین و بالا حذف شدند. کمیت‌ها در ساختار ۱۶بیتی نگه داشته و هنگام ساخت قاب با تابع واحد سریال می‌شوند. آرایه ابتدا صفر است؛ بنابراین ناحیه‌های رزرو بدون ده‌ها انتساب صریح صفر باقی می‌مانند. حلقه دما جای ۶۴ انتساب تکراری را گرفته است. جایگاه هیچ فیلد سازگار تغییر نکرده است.

\section{بازطراحی دریافت سریال}
کد قبلی پس از اجرای هندلر
\lr{HAL}،
ثبات داده را مستقیم می‌خواند و همان هندلر را دوباره صدا می‌زد. این ترتیب می‌توانست پرچم دریافت را پیش از خواندن پاک یا یک بایت را دوبار رسیدگی کند. نسخه جدید دریافت رسمی تک‌بایتی
\lr{HAL}
را شروع می‌کند،
\lr{callback}
فقط بافر را پر می‌کند و تفسیر دوازده‌بایت در حلقه اصلی انجام می‌شود. نوشتن
\lr{Flash}
دیگر هرگز داخل
\lr{ISR}
نیست.

\section{بازطراحی حافظه شناسه‌ها}
نسخه قدیمی از
\lr{0x08009000}
می‌خواند، ولی هنگام فرمان تغییر، صفحه
\lr{0x08008000}
را پاک می‌کرد. سپس ۶۴ مقدار هشت‌بایتی را از آرایه‌ای با ۳۲ عضو می‌نوشت. هر دو نشانی نزدیک انتهای کد ۳۲ کیلوبایتی قدیمی بودند و رشد برنامه می‌توانست داده یا کد را تخریب کند.

نسخه جدید آخرین صفحه واقعی قطعه را رزرو کرده است. لینک
\lr{Keil}
و
\lr{PlatformIO}
پیش از آن پایان می‌یابد. فقط ۳۲ شناسه نوشته می‌شوند و دو سطح
\lr{CRC}
همراه با نسخه قالب وجود دارد. مهاجرت فقط جدول قدیمی کاملاً معتبر را می‌پذیرد. اگر برق میان پاک‌کردن و نوشتن قطع شود، رکورد نامعتبر تشخیص داده و پیش‌فرض استفاده می‌شود؛ نگه‌داری دو نسخه افزونه‌ای برای تحمل کامل قطع برق هنوز پیاده نشده است.

\section{اصلاح رفتار کنترل}
رابطه‌ها و ضرایب اصلی حفظ شدند، ولی تقسیم بر نقطه تنظیم صفر، رطوبت خارج از بازه و محاسبه پنجره بزرگ‌تر از صد مهار شدند. حالت خاموش خودکار دیگر در دور بعدی حلقه ناخواسته دوباره فعال نمی‌شود. فرمان دستی همچنان ممکن است در حالت خودکار توسط کنترل بعدی بازنویسی شود؛ این رفتار سازگار و در فصل پروتکل ثبت شده است.

\section{مرزهای حفاظت‌شده \lr{CubeMX}}
در
\filepath{main.c}
فقط افزودن سرآیند کاربرد، ساخت ساختار دسته‌ها، فراخوانی راه‌اندازی و فراخوانی حلقه داخل نشانگرهای کاربر قرار دارد. فایل‌های
\filepath{app.c}
،
\filepath{sensor\_address\_store.c}
و درایورها خارج از مالکیت مولدند. با این حال، فایل پروژه
\lr{Keil}
و اندازه حافظه ممکن است توسط مولد بازنویسی شوند و پس از هر تولید باید مطابق چک‌لیست فصل ساخت کنترل شوند.

\section{مواردی که عمداً تغییر نکردند}
نرخ سریال، طول فرمان، قاب ۲۰۹ بایتی، ترتیب کم‌بایت، شناسه‌های پیش‌فرض، نگاشت فازهای
\lr{A}
و
\lr{B}،
ضرایب کالیبراسیون، دو خروجی هم‌زمان سرمایش و منطق امکان کار هم‌زمان سرمایش و هیتر حفظ شده‌اند. بدون نرم‌افزار رایانه و شماتیک، تغییر این قراردادها ریسک ناسازگاری داشت.

\section{موارد باقیمانده برای مرحله بعد}
درایور یک‌سیمه باید به ماشین حالت غیرمسدودکننده با پالس زمان‌سنج، تبدیل هم‌زمان، تشخیص حضور و
\lr{CRC}
حافظه موقت تبدیل شود. رابط انرژی باید نتیجه
\lr{HAL}
و مهلت بازنشانی را برگرداند. پروتکل به همگام‌سازی،
\lr{CRC}،
پاسخ و شماره نسخه نیاز دارد. حفاظت حداقل زمان کمپرسور، واچ‌داگ، ثبت خطا و آزمون واحد نیز هنوز انجام نشده‌اند.
