alirezaaies/es-ac-load-cycler/docs/relay_on_duration_report.pdf

# گزارش فني، مميزي و راهنماي توسعه

# سامانه پايش و كنترل اتاق آزمون

STM32F107VCT6 بر مبتني

### نسخه سند: .۱ ۱ آخرين بازبيني: ۱۱ مهر ۱۴۰۵

اين سند مرجع پياده سازي، نگه داري، توليد مجدد كد و توسعه پروژه است.

# راهنماي استفاده از سند

نسخه فعال، برنامه سيكل قطع و وصل بار با رله هاي فعال پايين و نمايش همزمان پارامترهاي الكتريكي است. مرجع رفتار فعلي و ادامه توسعه، فصل ۱۸ است. فصل هاي پيشين مرجع مراحل توسعه، كتابخانه ها و قابليت هاي تاريخي اند؛ وجود يك قابليت در مثال قديمي به معني فعال بودن آن در كاربرد امروز نيست. كاربر در تاريخ 2026-10-03 كاركرد نسخه جاري را روي برد تأييد كرده است. اين گزارش براساس خواندن همه فايل هاي سورس، تنظيمات CubeMX32STM ، پروژه MDK Keil و خروجي ساخت موجود تدوين شده است. ادعاهاي عملكردي كه تنها با اتصال برد قابل اثبات اند، با عنوان «نيازمند آزمون سخت افزاري» مشخص شده اند. فايل تنظيمات ظاهري گزارش tex.config-report/docs است و هر فصل در پوشه chapters/docs به صورت مستقل نگه داري مي شود.

آ

# فهرست مطالب

### ۱ دامنه، هدف و نماي كلي سامانه ۱

### ۲ سخت افزار و تنظيمات مولد كد ۳

### ۳ معماري نرم افزار و مالكيت فايل ها ۶

### ۴ درايورها، ماژول ها و وضعيت استفاده ۸

ب

سامانه پايش و كنترل اتاق آزمون فهرست مطالب

### ۵ رفتار زمان اجرا و كنترل محيط ۱۱

### ۶ پروتكل سريال رايانه ۱۳

### ۷ نتيجه مميزي و تغييرات انجام شده ۱۶

ج

سامانه پايش و كنترل اتاق آزمون فهرست مطالب

### ۸ ساخت، پروگرام و توليد مجدد ۱۸

### ۹ تأييد، تحويل و نگه داري آينده ۲۰

### ۱۰ مرجع كامل توابع لايه كاربرد ۲۲

۲۴ | App_Init | تابع ۱ .۲ .۱۰
۲۴ | App_Process | تابع ۲ .۲ .۱۰
۲۴ | App_ResetCalibrationToDefaults | تابع ۱ .۳ .۱۰
۲۵ | App_SetVoltageCalibration | تابع ۱ .۴ .۱۰
۲۵ | App_SetPhaseCalibration | تابع ۲ .۴ .۱۰
۲۵ | App_CalibratePhaseMultiPoint | تابع ۳ .۴ .۱۰

د

سامانه پايش و كنترل اتاق آزمون فهرست مطالب

۲۵ | App_SetNeutralCurrentCalibration | تابع ۱ .۵ .۱۰
۲۶ | App_CalibrateNeutralCurrentMultiPoint | تابع ۲ .۵ .۱۰
۲۶ | App_SetCurrentPolarity | تابع ۱ .۶ .۱۰
۲۶ | App_SetDisplayUnits | تابع ۲ .۶ .۱۰

### ۱۱ مرجع كامل توابع درايورها ۲۸

۲۸ | crc8_maxim | تابع ۱ .۱ .۱۱
۲۸ | crc32_record | تابع ۲ .۱ .۱۱
۲۸ | SensorAddressStore_IsValidRom | تابع ۳ .۱ .۱۱
۲۹ | table_is_valid | تابع ۴ .۱ .۱۱
۲۹ | SensorAddressStore_Load | تابع ۵ .۱ .۱۱
۲۹ | SensorAddressStore_Save | تابع ۶ .۱ .۱۱
۲۹ | ADE7880_ReadRegister | تابع ۱ .۲ .۱۱
۳۰ | ADE7880_WriteRegister | تابع ۲ .۲ .۱۱
۳۰ | ADE7880_ConfigSPI | تابع ۳ .۲ .۱۱
۳۰ | ADE7880_Run | تابع ۴ .۲ .۱۱
۳۰ | ADE7880_ReadVRMS | تابع ۵ .۲ .۱۱
۳۰ | ADE7880_ReadIRMS | تابع ۶ .۲ .۱۱

ه

سامانه پايش و كنترل اتاق آزمون فهرست مطالب

۳۰ | ADE7880_ReadPowerz | تابع ۷ .۲ .۱۱
۳۱ | ADE7880_ReadFPower | تابع ۸ .۲ .۱۱
۳۱ | ADE7880_Reset | تابع ۹ .۲ .۱۱
۳۱ | DS18B20 و OneWire | پشته | ۳ .۱۱
۳۲ | am2315_crc16 | تابع ۱ .۴ .۱۱
۳۲ | TEMP_HUM | تابع ۲ .۴ .۱۱
۳۳ | MAF_Init | تابع ۱ .۵ .۱۱
۳۳ | MAF_Update | تابع ۲ .۵ .۱۱

### ۱۲ شرح جزئي بازآرايي و مرز تغييرات ۳۴

و

سامانه پايش و كنترل اتاق آزمون فهرست مطالب

### ۱۳ مرجع توابع توليدشده و راه اندازي سخت افزار ۳۷

۳۷ | SystemClock_Config | | تابع ۲ .۱ .۱۳
۳۸ | MX_ADC1_Init | | تابع ۳ .۱ .۱۳
۳۸ | MX_I2C1_Init | | تابع ۴ .۱ .۱۳
۳۸ | MX_SPI2_Init | | تابع ۵ .۱ .۱۳
۳۸ . . . . MX_TIM3_Init و MX_TIM2_Init ،MX_TIM1_Init | توابع | ۶ .۱ .۱۳
۳۸ | MX_USART2_UART_Init | | تابع ۷ .۱ .۱۳
۳۸ | MX_DMA_Init | | تابع ۸ .۱ .۱۳
۳۹ | MX_GPIO_Init | | تابع ۹ .۱ .۱۳
۳۹ | Error_Handler | | تابع ۱۰ .۱ .۱۳
۳۹ | HAL_MspInit | | تابع ۱ .۲ .۱۳
۳۹ | HAL_ADC_MspDeInit و HAL_ADC_MspInit | توابع | ۲ .۲ .۱۳
۳۹ | HAL_I2C_MspDeInit و HAL_I2C_MspInit | توابع | ۳ .۲ .۱۳
۴۰ | HAL_SPI_MspDeInit و HAL_SPI_MspInit | توابع | ۴ .۲ .۱۳
۴۰ | HAL_UART_MspDeInit و HAL_UART_MspInit | توابع | ۶ .۲ .۱۳

ز

سامانه پايش و كنترل اتاق آزمون فهرست مطالب

### ۱۴ نشانگر زنده بودن و آزمون دو چراغ ۴۱

۴۲ | DiagnosticLed_Init | | تابع ۱ .۴ .۱۴
۴۲ | DiagnosticLed_SetMode | | تابع ۲ .۴ .۱۴
۴۲ | DiagnosticLed_Process | | تابع ۳ .۴ .۱۴
۴۳ | DiagnosticLed_GetMode | | تابع ۴ .۴ .۱۴
۴۳ | DIAGNOSTIC_LED_MODE_OFF | حالت | ۱ .۵ .۱۴
۴۳ | DIAGNOSTIC_LED_MODE_HEARTBEAT | حالت | ۲ .۵ .۱۴
۴۳ | DIAGNOSTIC_LED_MODE_DANCE | حالت | ۳ .۵ .۱۴
۴۳ | DIAGNOSTIC_LED_MODE_ERROR | حالت | ۴ .۵ .۱۴

### ۱۵ راه اندازي ارتباط و اندازه گيري با 7880ADE ۴۶

ح

سامانه پايش و كنترل اتاق آزمون فهرست مطالب

### ۱۶ زيرسامانه 20B18DS با شماره گذاري پايدار ۶۷

ط

سامانه پايش و كنترل اتاق آزمون فهرست مطالب

### ۱۷ نمايشگر كاراكتري و كليدهاي منو ۷۳

ي

سامانه پايش و كنترل اتاق آزمون فهرست مطالب

### ۱۸ برنامه نهايي سيكل قطع و وصل بار ۸۰

ك

# فصل ۱ دامنه، هدف و نماي كلي سامانه

اين فصل دامنه كلي محصول و پايه توسعه را شرح مي دهد. كاربرد فعال امروز، سيكل رله و نمايش اندازه گيري الكتريكي است كه در فصل ۱۸ مستند شده است؛ پردازش دما، رطوبت و سريال همگي در اين كاربرد فعال نيستند.

## .۱ ۱ كاربرد

برد كنترل براي يك اتاق آزمون تجهيزات برودتي ساخته شده است. دو ايستگاه اندازه گيري، در مجموع ۳۲ حسگر دماي ديجيتال را مي خوانند؛ دو حسگر دماي محيط روي دو گذرگاه مستقل نيز مرجع كنترل اتاق اند. رطوبت محيط از خروجي آنالوگ حسگر خانواده HIH نمونه برداري مي شود. مدار 7880ADE كميت هاي الكتريكي دو كانال فعال را اندازه مي گيرد. رايانه از طريق -232RS داده ها را دريافت و رله ها، سرمايش، گرمايش، رطوبت ساز و نقطه هاي تنظيم را كنترل مي كند.

## .۱ ۲ حدود نسخه حاضر

اين نسخه قابليت تازه اي به محصول اضافه نمي كند. هدف آن حفظ رفتار شناخته شده، حذف خطرهاي قطعي، جداسازي كد كاربردي از كد مولد، فراهم كردن ساخت با دو زنجيره ابزار و ايجاد مرجع نگه داري است. دو ايستگاه سوم و چهارم در قالب مخابراتي رزرو شده اند، ولي سخت افزار و منطق فعال ندارند.

سامانه پايش و كنترل اتاق آزمون فصل .۱ دامنه، هدف و نماي كلي سامانه

## .۱ ۳ نماي جريان داده

ترتيب منطقي اجرا چنين است:

.۱ وقفه هاي تايمر تنها موعد اجراي كار را ثبت مي كنند. .۲ حلقه اصلي كميت الكتريكي، رطوبت و دما را در موعد مربوط مي خواند. .۳ كنترل خودكار با هيسترزيس و پنجره زماني هيتر خروجي ها را تنظيم مي كند. .۴ يك قاب ثابت ۲۰۹ بايتي ساخته و روي درگاه سريال ارسال مي شود. .۵ دريافت سريال به صورت وقفه اي و تك بايتي انجام و فرمان كامل در حلقه اصلي تفسير مي شود.

## .۱ ۴ واحدهاي مهم

دماي محيط در داخل برنامه با واحد يك دهم درجه سلسيوس نگه داري مي شود. داده ۳۲ حسگر ايستگاه ها براي سازگاري با نرم افزار قبلي به شكل مقدار خام حسگر، يعني واحد يك شانزدهم درجه، ارسال مي شود. رطوبت ارسالي يك دهم درصد و مقادير چندبايتي همگي كم ارزش ترين بايت در ابتدا هستند.

# فصل ۲ سخت افزار و تنظيمات مولد كد

هشدار: جدول كامل پيراموني هاي اين فصل معماري محصول پيش از پاك سازي را ثبت مي كند. در snapshot فعال اين مرحله فقط كلاك سامانه، SWD، دو LED و 7880ADE2/SPI دوباره فعال شده اند؛ مراحل دقيق بازسازي فعلي در فصل ۱۵ است.

## .۲ ۱ پردازنده و كلاك

قطعه انتخاب شده 6VCT107F32STM در بسته 100LQFP است. نوسان ساز خارجي ۸ مگاهرتز با ضريب ،۹ كلاك سامانه ۷۲ مگاهرتز مي سازد. كلاك گذرگاه اول ۳۶ و گذرگاه دوم ۷۲ مگاهرتز است. كلاك مبدل آنالوگ ۱۲ مگاهرتز تنظيم شده است.

## .۲ ۲ پيراموني هاي فعال

پيراموني تنظيم و كاربرد
كانال هاي ۵ و ،۴ اسكن پيوسته، زمان نمونه برداري .۲۳۹ ۵ سيكل و انتقال چرخشي با كانال اول 1DMA ؛ كانال نخست منبع فعال رطوبت است.

ADC1

حالت ارباب، هشت بيتي، قطبيت بالا، لبه دوم، تقسيم كلاك ۶۴؛ ارتباط با 7880ADE و انتخاب تراشه روي پايه 12PB .

SPI2

سامانه پايش و كنترل اتاق آزمون فصل .۱ دامنه، هدف و نماي كلي سامانه

پيراموني تنظيم و كاربرد
نرخ ،۹۶۰۰ هشت بيت، يك توقف، بدون توازن، ارسال و دريافت؛ پايه هاي
بازنگاشت شده 6PD5/PD .

USART2

نرخ ۱۰۰ كيلوهرتز و بازنگاشت روي 9PB8/PB ؛ براي كتابخانه حسگر 2315AM آماده است ولي در مسير فعال استفاده نمي شود.

I2C1

1TIM دوره يك ثانيه؛ موعد ارسال داده. 2TIM دوره نيم ثانيه؛ موعد انرژي، رطوبت، شمارنده استارت و پنجره هيتر. 3TIM دوره يك ثانيه؛ موعد خواندن حسگرهاي دما.

## .۲ ۳ پايه هاي كاربردي قطعي

پايه نقش نكته
10PB گذرگاه نخست Wire1- شانزده حسگر ايستگاه اول و حسگر محيط اول 7PC گذرگاه دوم Wire1- شانزده حسگر ايستگاه دوم و حسگر محيط دوم 5PA ورودي آنالوگ نخست ورودي فعال محاسبه رطوبت
ً | نمونه برداري مي شود ولي فعلا مصرف كاربردي
ندارد

4PA ورودي آنالوگ دوم

1PE رطوبت ساز فرمان فعال پايين 2PE رله ايستگاه اول فرمان دستي فعال پايين 5PE4,PE دو خروجي سرمايش هم زمان كنترل مي شوند و فعال پايين اند 3PB هيتر يا SSR فعال پايين و داراي كنترل پنجره زماني 12PB انتخاب تراشه انرژي در حالت بي كار بالا رابط دو سيمه SWD براي Link-J ؛ زمين و
تغذيه مرجع نيز لازم است

14PA13,PA برنامه ريزي و اشكال زدايي

سامانه پايش و كنترل اتاق آزمون فصل .۱ دامنه، هدف و نماي كلي سامانه

پايه نقش نكته
خروجي پوش پول كم سرعت، سطح اوليه بالا و
الگوي غيرمسدودكننده زنده بودن برنامه

14PC13,PC دو چراغ عيب يابي

فايل در PE3, PE6, PB4, PD0, PD2, PD3, PD8, PD14, PD15, PC8 | شامل | ديگر | خروجي | هاي پايه
مولد تعريف شده اند اما نقش دقيقشان از سورس معلوم نيست. دو پايه 6PE و 3PD مطابق رفتار نسخه قديمي هنگام توقف كنترل در سطح بالا قرار مي گيرند. پيش از حذف يا تغيير هركدام بايد شماتيك بررسي شود.

## .۲ ۴ ايمني توليد مجدد

گزينه نگه داشتن كد كاربر فعال، پشتيبان گيري نسخه قبلي فعال و حذف پيشين غيرفعال شده است. مقدار دوره تايمر دوم نيز از اختلاف خطرناك ۳۵ به مقدار عملياتي ۳۵۹۹ همگام شد. پس از هر توليد مجدد بايد تفاوت فايل ها بازبيني و وجود فراخواني هاي Init_App و Process_App در بلوك هاي حفاظت شده كنترل شود.

# فصل ۳ معماري نرم افزار و مالكيت فايل ها

## .۳ ۱ لايه ها

فايل c.main/Src/Core راه اندازي توليدشده و دو فراخواني Init_App و Process_App را نگه مي دارد. فايل c.it\_xx1f32stm/Src/Core فقط هندلرهاي استاندارد HAL را اجرا مي كند. منطق فعال محصول در c.app/Src/Application قرار دارد. ماژول چراغ در همان لايه كاربرد و كتابخانه قابل حمل انرژي در
.است شده جدا Libraries/ADE7880/Src/ade7880.c
كتابخانه هاي حسگر، ميانگين گيري و ذخيره سازي قديمي در پوشه Libraries حفظ شده اند، ولي در نسخه تميز فعلي هنوز به چرخه برنامه متصل نيستند. وجود آن ها در پروژه ساخت به معني فعال بودنشان در زمان اجرا نيست.

## .۳ ۲ قرارداد با فايل هاي توليدي

تنها تغييرات دستي مجاز در فايل مولد بايد بين نشانگرهاي BEGIN CODE USER و CODE USER END باشد. در نسخه حاضر، سرآيند كاربرد در بلوك شامل ها، فراخواني راه اندازي در بلوك شماره ۲ و فراخواني پردازش در حلقه حفاظت شده قرار دارند. منطق كاربرد نبايد به فايل وقفه منتقل شود. تنظيم پايه 12PB=CS_ADE و رابط 2SPI در فايل ioc107.F32STM ثبت شده اند. پس از هر توليد مجدد بايد تفاوت فايل ها در گيت، حالت ۳ رابط، كلاك مجاز و باقي ماندن بلوك هاي كاربر كنترل شوند.

سامانه پايش و كنترل اتاق آزمون فصل .۳ معماري نرم افزار و مالكيت فايل ها

## .۳ ۳ زمان بندي تعاوني

نسخه فعال بدون تايمر كاربردي و بدون سيستم عامل كار مي كند. تابع Process_App با GetTick_HAL موعد يك ثانيه اي نمونه و دوثانيه اي بازيابي ارتباط را كنترل مي كند. اگر موعد نرسيده باشد بلافاصله بازمي گردد؛ بنابراين حلقه عادي تأخير مسدودكننده ندارد. ماژول چراغ نيز با همان الگوي تعاوني سرويس مي شود. ادامه منظم الگو نشان مي دهد حلقه اصلي هنوز در حال اجراست. خطاي ارتباط 7880ADE الگوي سريع خطا را فعال مي كند و اتصال موفق دوباره حالت عادي را برمي گرداند.

## .۳ ۴ هم روندي و انتشار داده

در نسخه فعلي هيچ حالت مشترك ميان وقفه و لايه كاربرد وجود ندارد. هندلرهاي توليدي فقط سرويس استاندارد HAL را اجرا مي كنند. حالت عمومي الكتريكي براي مشاهده ديباگر volatile است، ولي تمام تغييرهاي آن در متن حلقه اصلي انجام مي شود. هر نمونه كامل ابتدا در متغير محلي ساخته مي شود. فقط پس از موفقيت تمام خواندن هاي C/B/A و نول، مقدارهاي خام و مهندسي با هم منتشر مي شوند؛ در نتيجه مصرف كننده داده نيمه تازه دريافت نمي كند.

## .۳ ۵ حافظه پايدار

آخرين صفحه دو كيلوبايتي Flash از نشاني 800F0803x0 طبق طراحي قبلي براي جدول شناسه حسگر رزرو و از ناحيه لينك هر دو زنجيره ساخت حذف شده است. ماژول ذخيره سازي در مخزن باقي مانده، اما تا زمان بازگرداندن سنسورها از لايه كاربرد فعال فراخواني نمي شود. ضرايب كاليبراسيون 7880ADE ً فعلا در RAM هستند. جدول پيش فرض با هر بازنشاني بازمي گردد. ضرايب تأييدشده براي ماندگاري بايد در مرحله بعد در كد ثابت يا حافظه غيرفرار ذخيره و هنگام راه اندازي نصب شوند.

# فصل ۴ درايورها، ماژول ها و وضعيت استفاده

## .۴ ۱ درايور دماي ديجيتال

زيرسامانه فعال دما چهار بخش دارد. كتابخانه OneWire/Libraries زمان بندي استاندارد، 8CRC و جست وجوي ROM را مستقل از ميكروكنترلر انجام مي دهد؛ 20B18DS/Libraries فرمان هاي حسگر، تبديل مقدار علامت دار و اعتبارسنجي حافظه موقت را فراهم مي كند؛ مدير Manager20B18DS/Libraries كشف چند گذرگاه، شماره گذاري پايدار و نمونه برداري بدون انتظار طولاني را بر عهده دارد؛ و /Libraries SensorAddressStore تنها لايه وابسته به HAL 32STM براي ذخيره نگاشت در Flash است. گذرگاه صفر روي 10PB و گذرگاه يك روي 7PC قرار دارد. هر دو پايه در فايل CubeMX به شكل خروجي تخليه باز ثبت شده اند و به مقاومت بالاكش خارجي نياز دارند. تبديل همه حسگرهاي هر گذرگاه با فرمان سراسري آغاز مي شود، انتظار ۷۵۰ ميلي ثانيه اي در ماشين حالت انجام مي گيرد و هر حافظه موقت با ROM Match و كنترل CRC خوانده مي شود.
سنسور تازه خودكار به اولين شماره خالي متصل مي شود. مقدار و اعتبار به ترتيب در دو آرايه زير منتشر مي شوند:

g_temperature_c ◦

g_temperature_valid ◦
رابط عمومي برنامه فقط همين دو آرايه، شمار هويت هاي ثبت شده و تابع TemperatureGetCelsius_App است. ساختار مدير، ROM، گذرگاه و توابع تخصيص داخل لايه اتصال برد پنهان مانده اند. آرايه ها نيز فقط پس از كشف يا خواندن تازه به روز مي شوند، نه در هر دور حلقه اصلي. معماري، معرفي، تعويض و انتقال در فصل ۱۶ تشريح شده است.

سامانه پايش و كنترل اتاق آزمون فصل .۴ درايورها، ماژول ها و وضعيت استفاده

## .۴ ۲ اندازه گيري انرژي

ماژول قابل حمل 7880ADE روي 2SPI كار مي كند و وابستگي مستقيم به HAL ندارد. برنامه ولتاژ مؤثر، جريان مؤثر، توان اكتيو، توان ظاهري و ضريب توان هر سه فاز و جريان نول را در snapshot سازگار مي خواند. ضريب توان از رجيسترهاي مستقل CPF/BPF/APF گرفته مي شود. خطا و timeout به فراخواننده بازمي گردند و reset حلقه نامحدود ندارد. شرح كامل اتصال، API، كاليبراسيون و آزمون در فصل ۱۵ آمده است.

## .۴ ۳ رطوبت آنالوگ

كانال فعال ADC پس از هر ۲۰۰۰ نمونه ميانگين گيري مي شود. تبديل فعلي چنين است: ولتاژ مرجع تجربي .۳ ۳۳۶ ولت، آفست .۰ ۸۵۳ ولت، شيب ۳۰ ميلي ولت بر درصد و دو ضريب اصلاح .۱ ۳ و .۱ .۰۴ خروجي براي جلوگيري از فرمان نامعتبر به بازه صفر تا صد درصد محدود شده است. اين ضرايب وابسته به برد و كاليبراسيون اند و بايد در پرونده كاليبراسيون محصول ثبت شوند.

## .۴ ۴ حسگر رطوبت ديجيتال

ماژول 2315AM در پروژه Keil كامپايل مي شود و 1C2I نيز راه اندازي شده است، اما فراخواني آن در مسير اجرايي وجود ندارد. پياده سازي بازبيني شده كدهاي بازگشت HAL ، ساختار پاسخ، علامت دما و 16CRC Modbus را بررسي مي كند. اين ماژول براي سازگاري نگه داشته شده، ولي پيش از فعال سازي بايد روي سخت افزار تست شود.

## .۴ ۵ فيلتر ميانگين متحرك

ماژول MAF پياده سازي پنجره ۴۰ نمونه اي دارد، اما نه در پروژه Keil افزوده شده و نه در هيچ سورس فعال فراخواني مي شود. محاسبه آن در هر به روزرساني كل پنجره را دوباره جمع مي كند. براي استفاده آينده بهتر است جمع جاري عضو ساختار باشد تا هزينه ثابت شود. در نسخه فعلي حذف نشده، زيرا يك كتابخانه مستقل و قابل استفاده است؛ وضعيت غيرفعال آن بايد حفظ شود.

سامانه پايش و كنترل اتاق آزمون فصل .۴ درايورها، ماژول ها و وضعيت استفاده

## .۴ ۶ درايورهاي HAL

در EXTI و Cortex ،توان ،RCC ،Flash ،UART ،تايمر ،SPI ،I2C ،GPIO ،DMA ،ADC | هاي | ماژول
تنظيمات و پروژه Keil حضور دارند. EXTI كاربرد مستقيم ندارد ولي وابستگي زيرساختي HAL است. فايل هاي LL موجود در پوشه درايورها كامپايل نمي شوند. آثار آبجكت هايي مانند 7753ADE ، 4725MCP در پوشه خروجي Keil سورس متناظر ندارند و بخشي از محصول فعال نيستند.

# فصل ۵ رفتار زمان اجرا و كنترل محيط

## .۵ ۱ راه اندازي

پس از راه اندازي كلاك و پيراموني ها، همه محرك هاي فعال پايين خاموش مي شوند، گذرگاه هاي دما آزاد مي شوند، جدول شناسه بارگذاري مي شود و مدار انرژي به حالت SPI قفل، بازنشاني و اجرا مي رود. سپس DMA، دريافت تك بايتي UART و سه تايمر آغاز مي شوند. تأخير پنج ثانيه اي قديمي و ارسال C2I با اشاره گر نامعتبر حذف شده اند.

## .۵ ۲ كنترل رطوبت

در حالت خودكار، پايين تر از ۹۸ درصد نقطه تنظيم رطوبت ساز روشن و از ۱۰۱ درصد آن به بالا خاموش مي شود. بين دو مرز وضعيت قبلي حفظ مي شود. در نسخه قديمي خرابي حسگر ديجيتال مانع كنترل بود، درحالي كه حسگر فعال آنالوگ است؛ وابستگي نادرست حذف شده است.

## .۵ ۳ كنترل سرمايش

اگر دماي محيط بيش از نيم درجه بالاتر از نقطه تنظيم باشد، دو خروجي سرمايش روشن مي شوند. اگر دما نيم درجه يا بيشتر پايين تر باشد، خاموش مي شوند. ناحيه يك درجه اي مياني هيسترزيس از قطع و وصل سريع جلوگيري مي كند. حفاظت حداقل زمان خاموش يا روشن كمپرسور هنوز وجود ندارد و بايد پيش از اتصال مستقيم كمپرسور توسط سخت افزار يا نرم افزار جداگانه تضمين شود.

سامانه پايش و كنترل اتاق آزمون فصل .۵ رفتار زمان اجرا و كنترل محيط

## .۵ ۴ كنترل گرمايش

زير ۹۵ درصد نقطه تنظيم، هيتر پيوسته روشن و از ۱۰۱ درصد به بالا خاموش است. در ناحيه مياني، رابطه تجربي كد قديمي به يك پنجره صدمرحله اي محدود شده است. اين امكان روشن ماندن سرمايش و جبران با هيتر را حفظ مي كند. رابطه تجربي در نقطه تنظيم تقريباً ۱۶ درصد زمان روشن مي دهد؛ در لبه پايين مي تواند نزديك صد درصد شود.

## .۵ ۵ حالت ها و ايمني

فرمان AUTOFF كنترل خودكار را غيرفعال و همه خروجي هاي شناخته شده را خاموش مي كند. فرمان AUTONN آن را فعال مي كند. فرمان نقطه تنظيم نيز كنترل را مجاز مي سازد. فرمان هاي دستي مستقيماً خروجي را تغيير مي دهند، ولي اگر حالت خودكار فعال بماند چرخه بعدي مي تواند آن را بازنويسي كند؛ نرم افزار رايانه بايد پيش از كنترل دستي، حالت خودكار را خاموش كند.

هشدار: معناي الكتريكي خروجي ها از روي كد «فعال پايين» استنتاج شده است. پيش از نخستين پروگرام نسخه بازآرايي شده، حالت خاموش واقعي هر رله و SSR با مولتي متر بررسي شود.

# فصل ۶ پروتكل سريال رايانه

## .۶ ۱ لايه انتقال

رابط روي ۹۶۰۰ بيت برثانيه، هشت بيت داده، يك بيت توقف و بدون توازن است. هر فرمان ۱۲ بايت دارد. اگر فرمان كوتاه تر است، فرستنده بايد با صفر آن را تا ۱۲ بايت پر كند. هيچ مجموع مقابله با خطا، شماره توالي يا گريز از قاب در نسخه قديمي تعريف نشده است؛ براي كابل نويزي افزودن نسخه دوم پروتكل توصيه مي شود.

## .۶ ۲ فرمان ها

پيشوند اثر
NN1S / FF1S خاموش يا روشن كردن رله ايستگاه اول روي 2PE . NN2S / FF2S خاموش يا روشن كردن خروجي 1PE ؛ با فرمان هاي رطوبت هم پوشان است. COLN / COLF خاموش يا روشن كردن هر دو خروجي سرمايش. HUMN / HUMF خاموش يا روشن كردن رطوبت ساز. HETN / HETF خاموش يا روشن كردن هيتر. بايت هاي ۴ و ۵ دما و بايت هاي ۶ و ۷ رطوبت، بدون علامت، كم ارزش ابتدا و با مقياس يك دهم.

SETP

سامانه پايش و كنترل اتاق آزمون فصل .۵ رفتار زمان اجرا و كنترل محيط

پيشوند اثر
بايت ۳ شماره يك مبناي حسگر و بايت هاي ۴ تا ۱۱ شناسه ROM؛ بازه و
CRC بررسي و سپس كل جدول ذخيره مي شود.

TMP

AUTOFF و غيرفعال يا فعال كردن كنترل خودكار.

AUTONN
EXIT بازتاب ۱۲ بايت، خاموش سازي خروجي ها و بازنشاني پردازنده.

## .۶ ۳ قاب داده ۲۰۹ بايتي

بازه بايت قالب معنا
AA BB CC DD | سرآيند | ثابت | ۳ تا ۰
۴ هشت بيتي مقدار ،۲۰۴ طول داده پس از اين بايت ۵ تا ۱۲ چهار عدد ۱۶بيتي ولتاژ، جريان، توان و ضريب توان ايستگاه اول ۱۳ تا ۲۰ چهار عدد ۱۶بيتي همان كميت ها براي ايستگاه دوم ۲۱ تا ۳۶ صفر رزرو انرژي ايستگاه هاي سوم و چهارم ۳۷ تا ۶۸ شانزده عدد ۱۶بيتي دماهاي خام ايستگاه اول ۶۹ تا ۱۰۰ شانزده عدد ۱۶بيتي دماهاي خام ايستگاه دوم ۱۰۱ تا ۱۶۴ صفر رزرو دماي ايستگاه هاي سوم و چهارم ۱۶۵ تا ۱۶۶ ۱۶بيتي دماي محيط با واحد يك دهم درجه ۱۶۷ تا ۱۶۸ ۱۶بيتي رطوبت محيط با واحد يك دهم درصد ۱۶۹ تا ۱۷۲ دو عدد ۱۶بيتي شمارنده استارت دو كانال، ضرب شده در ده براي سازگاري ۱۷۳ تا ۱۷۶ صفر رزرو شمارنده ايستگاه هاي سوم و چهارم ۱۷۷ تا ۲۰۴ دنباله ثابت مقادير ۷ تا ۳۴ ده دهي؛ نقش كاربردي ناشناخته
FC FD FE FF | پايان | ثابت | ۲۰۸ تا ۲۰۵

سامانه پايش و كنترل اتاق آزمون فصل .۵ رفتار زمان اجرا و كنترل محيط

تمام اعداد ۱۶بيتي به ترتيب كم ارزش ترين بايت و سپس پرارزش ترين بايت اند. آستانه اعتبار ولتاژ ۱۰۰ تا كمتر
ً | از ۳۰۰۰ است؛ بيرون اين بازه سه كميت اصلي همان ايستگاه صفر مي شوند. ضريب توان فعلا همواره صفر است.

# فصل ۷ نتيجه مميزي و تغييرات انجام شده

## .۷ ۱ نقاط قوت نسخه اوليه

تنظيمات اصلي كلاك و پيراموني ها روشن و خروجي ساخت Keil موجود موفق و بدون هشدار بوده است. پروتكل ثابت، ضرايب كاليبراسيون عملياتي، دو گذرگاه دما، شناسه هاي يكتا و هيسترزيس كنترل، دانش ارزشمند محصول را ثبت كرده اند. استفاده از نشانگرهاي حفاظت شده CubeMX در بخش هايي از فايل اصلي نيز پايه مناسبي بوده است.

## .۷ ۲ اشكال هاي بحراني اصلاح شده

- عمليات طولاني SPI، Wire1- و UART از متن وقفه خارج شد.
- خواندن مستقيم ثبات UART پس از HAL و فراخواني دوباره هندلر حذف و دريافت استاندارد وقفه اي جايگزين شد.
- منطق كاربردي از فايل وقفه توليدشده به ماژول مستقل انتقال يافت.
- اختلاف دوره تايمر دوم ميان فايل مولد و سورس برطرف شد.
- خواندن از 08009000x0 و نوشتن در 08008000x0 با يك صفحه رزروشده، نسخه دار و داراي CRC جايگزين شد.
- حلقه اي كه ۶۴ مقدار را از آرايه ۳۲ عضوي مي خواند حذف شد.
- خطر هم پوشاني داده تنظيمات با كد برنامه با كاهش ناحيه لينك برطرف شد.

سامانه پايش و كنترل اتاق آزمون فصل .۷ نتيجه مميزي و تغييرات انجام شده

- بلوك هاي بزرگ كد كامنت شده و متغيرهاي بايت به بايت تكراري حذف و ساخت قاب حلقه اي شد.
- تقسيم بر صفر در محاسبه پنجره هيتر و خروجي خارج از بازه رطوبت مهار شد.
- حالت خاموش خودكار اكنون واقعاً پايدار و ايمن است.

## .۷ ۳ موارد حفظ شده

قالب ۲۰۹ بايتي، نرخ سريال، نگاشت دو ايستگاه، ترتيب بايت، آدرس هاي پيش فرض، ضرايب كاليبراسيون، منطق فعال پايين، هيسترزيس و رابطه پنجره هيتر حفظ شده اند. جابه جايي ظاهري شمارنده هاي استارت نيز براي سازگاري قاب قديمي حفظ و در كد روشن ثبت شده است.

## .۷ ۴ ريسك هاي باز

.۱ درايور Wire1- هنوز زمان تبديل كافي مطابق بدترين حالت ديتاشيت و CRC داده را تضمين نمي كند. .۲ تبديل هاي طولاني ۳۴ حسگر ترتيبي اند و مي توانند نرخ حلقه را كاهش دهند. .۳ پروتكل ورودي همگام سازي، CRC، پاسخ موفقيت و پاسخ خطا ندارد. .۴ حفاظت زماني كمپرسور، تشخيص اتصال كوتاه حسگر و واچ داگ فعال نيست. .۵ نقش چند خروجي GPIO، كانال دوم ADC و دنباله بايت هاي ۱۷۷ تا ۲۰۴ مستند سخت افزاري ندارد. .۶ ضرايب انرژي و رطوبت تنها از كد استخراج شده اند و شناسنامه كاليبراسيون همراه پروژه نيست.

## .۷ ۵ چرا بعضي فايل ها حذف نشدند

كتابخانه هاي 2315AM و MAF سورس مستقل و بالقوه مفيدند و حذفشان براي پروژه هاي بعدي برگشت پذيري را كم مي كند؛ بنابراين با برچسب غيرفعال نگه داشته شدند. در مقابل، خروجي هاي ساخت قديمي در اين مرحله فيزيكي حذف نشدند، چون مسير فعلي مخزن Git نيست و ممكن است براي مقايسه باينري لازم باشند؛ فايل ignore مانع ورود دوباره آن ها به كنترل نسخه خواهد شد.

# فصل ۸ ساخت، پروگرام و توليد مجدد

## .۸ ۱ ساخت با Keil

پروژه uvprojx107.F32STM/ARM-MDK را باز كنيد، بسته خانواده 1F32STM را در Keil نصب كنيد و هدف را بسازيد. دو فايل كاربرد و ذخيره سازي به گروه كاربر افزوده شده اند. اندازه 1IROM برابر 800F3x0 است و نبايد به ۲۵۶ كيلوبايت كامل بازگردد. پروگرامر Link-J از GND ,SWCLK ,SWDIO و ولتاژ مرجع برد استفاده مي كند.

.۸ ۲ ساخت با PlatformIO

در ريشه پروژه اجرا كنيد:

pio run
pio run --target upload
pio device monitor
استفاده | J-Link و STM32Cube | چارچوب | ، eval_f107vc برد | رسمي | شناسه | از stm32f107vc_jlink | محيط
مي كند. فايل لينك اختصاصي آخرين صفحه Flash را رزرو مي كند. فايل سامانه محلي از ساخت PlatformIO كنار گذاشته مي شود تا نسخه چارچوب و فايل پروژه هم زمان نماد تكراري نسازند.

سامانه پايش و كنترل اتاق آزمون فصل .۸ ساخت، پروگرام و توليد مجدد

## .۸ ۳ توليد مجدد با CubeMX

.۱ پيش از توليد، از پوشه پروژه نسخه پشتيبان يا يك commit بسازيد. .۲ فايل ioc107.F32STM را باز و گزينه حفظ كد كاربر را كنترل كنيد. .۳ دوره تايمر دوم بايد ۳۵۹۹ و كلاك تايمر ۷۲ مگاهرتز باشد. .۴ كد Keil را توليد كنيد و هيچ اخطار حذف فايل را بدون بازبيني نپذيريد. .۵ بررسي كنيد فايل هاي c.app و c.store\_address\_sensor هنوز عضو پروژه Keil باشند. .۶ اندازه Flash لينك Keil را دوباره روي 800F3x0 قرار دهيد؛ مولد ممكن است آن را بازنويسي كند. .۷ تفاوت ها را بررسي، سپس هر دو ساخت را اجرا كنيد.

هشدار: هيچ فايل HEX قديمي را پس از تغيير سورس به عنوان نتيجه معتبر تلقي نكنيد. زمان و خروجي ساخت بايد با سورس همان نسخه ثبت شود.

## .۸ ۴ ساخت گزارش

از پوشه docs دستور زير را دوبار اجرا كنيد تا فهرست كامل شود:

xelatex -interaction=nonstopmode relay_on_duration_report.tex
xelatex -interaction=nonstopmode relay_on_duration_report.tex

اگر فونت بي نازنين نصب باشد خودكار استفاده مي شود و در غير اين صورت تاهوما جايگزين است. رنگ ها، حاشيه ها و فونت ها تنها در فايل تنظيمات متمركز قرار دارند.

# فصل ۹ تأييد، تحويل و نگه داري آينده

## .۹ ۱ آزمون روميزي بدون بار قدرت

ابتدا رله ها و SSRها را از بار اصلي جدا كنيد. سطح خاموش همه خروجي ها، كلاك ۷۲ مگاهرتز، نرخ UART و انتخاب تراشه SPI را با ابزار اندازه گيري كنترل كنيد. سپس يك حسگر روي هر گذرگاه وصل و شناسه، دماي خام و دماي محيط را با دماسنج مرجع مقايسه كنيد.

## .۹ ۲ آزمون پروتكل

براي هر فرمان يك قاب دقيق ۱۲ بايتي بفرستيد و اثر خروجي را ثبت كنيد. قاب ۲۰۹ بايتي را از نظر سرآيند، انتها، طول، ترتيب كم ارزش ترين بايت و جايگاه هر حسگر بررسي كنيد. سناريوهاي قطع كابل، بايت گمشده، فرمان نامعتبر و توقف نرم افزار رايانه نيز بايد آزموده شوند.

## .۹ ۳ آزمون كنترل

با بار شبيه ساز، نقاط پايين، داخل و بالاي هيسترزيس دما و رطوبت را اعمال كنيد. گذار خودكار به دستي و برعكس، بازنشاني، قطع حسگر و بازيابي برق را ثبت كنيد. شمارنده استارت بايد تنها روي لبه خاموش به روشن افزايش يابد. سپس حداقل زمان مجاز كمپرسور طبق سازنده به آزمون اضافه شود.

سامانه پايش و كنترل اتاق آزمون فصل .۹ تأييد، تحويل و نگه داري آينده

## .۹ ۴ معيار پذيرش نسخه

- ساخت Keil و PlatformIO بدون خطا انجام شود.
- اندازه كد از مرز 800F0803x0 عبور نكند.
- توليد مجدد CubeMX هيچ كد كاربردي را حذف نكند.
- خاموشي ايمن هنگام راه اندازي، خطا و AUTOFF تأييد شود.
- همه نگاشت هاي شماره گذاري شده پس از قطع برق سالم بازيابي و CRC ركورد و ROM آن ها تأييد شود.
- نرم افزار رايانه قاب جديد را بدون تغيير تفسير كند.

## .۹ ۵ اولويت هاي توسعه بعدي

بازنويسي قابل حمل Wire،1- تبديل هم زمان، كنترل CRC و شماره گذاري پايدار انجام شده است. اولويت بعدي آزمون سخت افزاري اين مسير با تعداد و كابل واقعي، سپس پروتكل نسخه دار با CRC و پاسخ، ماشين حالت حفاظت كمپرسور، واچ داگ، گزارش خطاي حسگر و تست واحد ميزبان است. پس از دريافت شماتيك مي توان نام و وضعيت پايه هاي ناشناخته را قطعي و ماژول هاي بلااستفاده را حذف يا فعال كرد.

## .۹ ۶ قاعده نگه داري سند

هر تغيير رفتاري بايد هم زمان در فصل مربوط، فايل وضعيت ريشه، شماره نسخه پروتكل و فهرست آزمون ثبت شود. نتيجه آزمون سخت افزاري نبايد از روي موفقيت كامپايل استنتاج شود. فايل وضعيت پروژه نقطه شروع هر عامل انساني يا هوش مصنوعي براي ادامه كار است.

# فصل ۱۰ مرجع كامل توابع لايه كاربرد

اين فصل مرجع نسخه فعال لايه كاربرد در فايل هاي h.app/Inc/Application و /Src/Application c.app است. فايل مولد c.main/Src/Core فقط پس از آماده شدن پايه ها و 2SPI تابع راه اندازي را صدا مي زند و سپس تابع پردازش را در حلقه اصلي اجرا مي كند. منطق 7880ADE و چراغ هاي عيب يابي بيرون از فايل مولد باقي مي ماند.

## .۱۰ ۱ حالت عمومي قابل مشاهده در ديباگر

براي دما، رابط معمول سه نماد ساده دارد:

؛N | شماره | سنسور | دماي g_temperature_c[N-1] ◦
مقدار؛ | همان | اعتبار g_temperature_valid[N-1] ◦
- count_sensor_temperature_g تعداد هويت هاي ثبت شده.
كشف و تخصيص نخستين شماره خالي خودكار است و برنامه عادي تابعي را از ديباگر فراخواني نمي كند. تابع TemperatureGetCelsius_App فقط هنگام وجود نمونه معتبر true برمي گرداند. اين تنها تابع عمومي دما در لايه كاربرد است؛ APIهاي كشف، تخصيص و پاك كردن و همچنين ساختار مدير از هدر ساده حذف شده اند تا كد مصرف كننده به جزئيات ROM، گذرگاه و ماشين حالت وابسته نشود.

متغير سراسري electrical_app_g از نوع ElectricalState_App است و براي پنجره Watch طراحي شده
است. انديس صفر، يك و دو هميشه به ترتيب فازهاي C/B/A هستند. مهم ترين اعضا عبارت اند از:

سامانه پايش و كنترل اتاق آزمون فصل .۱۰ مرجع كامل توابع لايه كاربرد

عضو معني و شرط استفاده
online آخرين راه اندازي و نمونه كامل ارتباطي موفق بوده است. status_last نتيجه دقيق آخرين عمليات كتابخانه. samples_successful شمار نمونه هاي كامل و موفق. errors_communication شمار خطاهاي خواندن پس از برقراري ارتباط. شمارهاي مستقيم رجيستر براي ولتاژ، جريان، W، VA و PF هر فاز.

raw.phase[0..2]

ولتاژ RMS برحسب ولت، فقط وقتي valid متناظر درست است.

voltage_v[0..2]

جريان RMS برحسب آمپر، فقط وقتي valid متناظر درست است.

current_a[0..2]

[0..2]w_power_active توان اكتيو علامت دار برحسب وات. [0..2]va_power_apparent توان ظاهري برحسب ولت آمپر. [0..2]factor_power ضريب توان علامت دار از منفي يك تا مثبت يك. [0..2]abs_factor_power بزرگي ضريب توان از صفر تا يك.

a_current_neutral جريان RMS نول برحسب آمپر.
source_... منشأ ضريب: بدون ضريب، پيش فرض آغازكار يا ضريب كاربر.

هيچ مقدار مهندسي بدون بررسي پرچم valid متناظر استفاده نشود. هنگام تغيير ضريب يا جهت CT مقدار قبلي و خروجي نمايشي همان لحظه صفر و valid نادرست مي شوند؛ مقدار تازه با نخستين نمونه موفق بعدي منتشر مي شود.

## .۱۰ ۲ توابع اصلي چرخه اجرا

سامانه پايش و كنترل اتاق آزمون فصل .۱۰ مرجع كامل توابع لايه كاربرد

## App_Init تابع ۱ .۲ .۱۰

ورودي، نشاني دسته SPI است كه پيش تر توسط Init_2SPI_MX راه اندازي شده است. تابع مراحل زير را انجام مي دهد:

.۱ ماژول چراغ عيب يابي و تمام حالت عمومي را مقداردهي اوليه مي كند؛ .۲ واحدهاي نمايشي پيش فرض و جهت عادي سه CT را قرار مي دهد؛ .۳ جدول كامل ضرايب آغازكار C/B/A و جريان نول را بارگذاري مي كند؛ .۴ callbackهاي مستقل از ميكرو را به توابع HAL متصل مي كند؛ .۵ رابط SPI را انتخاب، تراشه را بازنشاني و پردازشگر اندازه گيري را اجرا مي كند؛ .۶ نتيجه را در حالت عمومي و الگوي چراغ ثبت مي كند.

اشاره گر تهي پذيرفته نمي شود، ولي برنامه در راه اندازي قفل نمي كند؛ وضعيت خطا ثبت و حلقه اصلي بعداً تلاش مجدد انجام مي دهد.

App_Process تابع ۲ .۲ .۱۰

اين تابع ورودي و خروجي ندارد و بايد پيوسته در (1)while فراخواني شود. در هر اجرا ابتدا چراغ غيرمسدودكننده را سرويس مي كند. اگر موعد نرسيده باشد بلافاصله بازمي گردد. در حالت آنلاين هر يك ثانيه يك نمونه كامل سه فاز و نول مي خواند؛ در شكست، حالت آفلاين و الگوي خطا فعال مي شوند. در حالت آفلاين هر دو ثانيه راه اندازي دوباره آزمايش مي شود. داده ابتدا در متغير محلي خوانده مي شود. فقط اگر همه رجيسترها موفق باشند، raw و تمام مقدارهاي مهندسي با هم منتشر مي شوند؛ بنابراين ساختار عمومي هرگز مخلوطي از فاز تازه و قديمي ندارد.

## .۱۰ ۳ ضرايب پيش فرض و بازنشاني

App_ResetCalibrationToDefaults تابع ۱ .۳ .۱۰

جدول ثابت calibration_default را براي ولتاژ، جريان، توان اكتيو و توان ظاهري هر سه فاز و جريان نول كپي مي كند. همه مقدارهاي قبلي صفر و پرچم هاي valid نادرست مي شوند. منبع همه خانه ها مقدار DEFAULT_CALIBRATION_APP مي گيرد. سپس خروجي هاي نمايش نيز تازه مي شوند.

سامانه پايش و كنترل اتاق آزمون فصل .۱۰ مرجع كامل توابع لايه كاربرد

اين تابع در Init_App خودكار اجرا مي شود و در زمان اجرا نيز براي كنارگذاشتن همه ضرايب كاربر قابل فراخواني است. ضرايب پيش فرض فاز C و نول موقت اند و بايد با مرجع واقعي تأييد شوند.

## .۱۰ ۴ نصب و محاسبه كاليبراسيون فاز

App_SetVoltageCalibration تابع ۱ .۴ .۱۰

يك رابط كوتاه سازگار براي نصب offset/scale ولتاژ يك فاز است و درون خود تابع عمومي نصب فاز را فراخواني مي كند.

App_SetPhaseCalibration تابع ۲ .۴ .۱۰

سه ورودي دارد: نوع كميت، فاز و نشاني ضريب خطي. كميت مجاز يكي از ولتاژ RMS، جريان RMS، توان اكتيو يا توان ظاهري است. تابع فقط خانه انتخاب شده را جايگزين مي كند، source همان خانه را كاربر قرار مي دهد و مقدار قبلي و نمايش وابسته را تا نمونه بعدي پاك مي كند. آرگومان تهي، فاز نامعتبر يا كميت خارج
از enum با ARGUMENT_INVALID_STATUS_7880ADE رد مي شود.

App_CalibratePhaseMultiPoint تابع ۳ .۴ .۱۰

دو يا چند زوج ميانگين reference/raw را به تابع قابل حمل كمترين مربعات مي دهد، يك خط engineering offset + scale * raw = مي سازد و آن را براي كميت و فاز انتخابي نصب مي كند. سه تا پنج نقطه دور از هم توصيه مي شود. دو خروجي اختياري، ضريب دقيق نصب شده و بيشترين خطاي باقيمانده نقاط را برمي گردانند. اگر جهت نرم افزاري CT براي توان اكتيو معكوس باشد، تابع علامت ضرايب داخلي را طوري هماهنگ مي كند كه reference همچنان خروجي نهايي مورد انتظار كاربر باشد.

## .۱۰ ۵ كاليبراسيون جريان نول

App_SetNeutralCurrentCalibration تابع ۱ .۵ .۱۰

يك جفت ضريب را براي رجيستر NIRMS نصب مي كند. مقدار قبلي صفر، valid نادرست و source برابر كاربر مي شود. مقدار جديد پس از نمونه موفق بعدي منتشر خواهد شد.

سامانه پايش و كنترل اتاق آزمون فصل .۱۰ مرجع كامل توابع لايه كاربرد

App_CalibrateNeutralCurrentMultiPoint تابع ۲ .۵ .۱۰

همان برازش چندنقطه اي را با reference برحسب آمپر انجام مي دهد و نتيجه را از مسير تابع نصب نول فعال مي كند. ضريب و بيشترين خطاي باقيمانده هر دو خروجي اختياري هستند.

## .۱۰ ۶ جهت ترانس جريان و واحد نمايش

App_SetCurrentPolarity تابع ۱ .۶ .۱۰

فاز و يكي از دو مقدار REVERSED/NORMAL را مي گيرد. حالت معكوس فقط علامت توان اكتيو و PF علامت دار را اصلاح مي كند؛ جريان RMS، توان ظاهري و بزرگي PF تغيير نمي كنند. پس از تغيير، مقادير علامت دار قبلي و نمايش توان همان لحظه پاك و تا نمونه بعدي نامعتبر مي شوند. تشخيص خودكار جهت انجام نمي شود، زيرا توان منفي ممكن است صادرات واقعي باشد. جهت بايد يك بار هنگام راه اندازي فيزيكي تعيين شود.

App_SetDisplayUnits تابع ۲ .۶ .۱۰

دو ضريب مثبت براي نمايش جريان و توان مي گيرد. پيش فرض ها ۱۰۰ واحد بر آمپر و ۱۰ واحد بر وات/ولت آمپر هستند؛ بنابراين A 0.17 به شكل ۱۷ و W 23.1 به شكل ۲۳۱ ديده مي شوند. اين تابع فقط فيلدهاي نمايش را تغيير مي دهد و هيچ اثري روي SI، raw يا كاليبراسيون ندارد.

## .۱۰ ۷ توابع داخلي مهم

تابع مسئوليت
values_display_update ساخت خروجي نمايشي فقط از مقدار SI معتبر. value_linear_publish اعمال يك ضريب يا انتشار صفر و valid نادرست. تبديل متقارن C/B/A، اصلاح جهت و تبديل 1.15Q مربوط به PF.

update_engineering_values

سامانه پايش و كنترل اتاق آزمون فصل .۱۰ مرجع كامل توابع لايه كاربرد

تابع مسئوليت
اتصال رابط انتقال، اجراي آغازكار و انتخاب زمان نمونه يا تلاش
مجدد.

initialize_ade

slot_calibration_phase نگاشت enum كميت به خانه درست ساختار ضرايب. value_phase_invalidate پاك كردن مقدار قبلي و ثبت منبع ضريب جديد.

چهار رابط محلي نيز نتيجه HAL را به وضعيت كتابخانه تبديل و عمليات ارسال، دريافت، انتخاب تراشه و تأخير را فراهم مي كنند. اين وابستگي ها فقط در لايه كاربرد هستند؛ كتابخانه 7880ADE هيچ هدر 32STM را شامل نمي كند.

## .۱۰ ۸ الگوي استفاده تك فاز و سه فاز

براي محصول تك فاز فقط انديس A_PHASE_7880ADE مصرف مي شود. براي دو كانال، A و B مستقل اند. محصول سه فاز C/B/A را مي خواند. نصب كاليبراسيون يك خانه هيچ ضريب ديگري را عوض نمي كند. در پروژه اي با چند تراشه نيز براي هر IC يك Device_7880ADE و رابط انتقال مستقل ساخته مي شود؛ نمونه سراسري داخل كتابخانه وجود ندارد.

## .۱۰ ۹ چك ليست استفاده صحيح

.۱ ابتدا online و status_last كنترل شوند. .۲ مقدار raw و مقدار مهندسي متناظر هم زمان ديده شوند. .۳ هيچ مقدار مهندسي بدون valid متناظر مصرف نشود. .۴ source پيش فرض به معني ضريب موقت آغازكار است؛ براي دقت نهايي هر كانال جدا كاليبره شود. .۵ ضريب بازگشتي تأييدشده در كد يا حافظه غيرفرار ذخيره شود، زيرا ضريب زمان اجرا با reset از بين مي رود.
.۶ ثانويه CT هنگام عبور جريان اوليه هرگز باز نشود.

# فصل ۱۱ مرجع كامل توابع درايورها

## .۱۱ ۱ ذخيره شناسه حسگر

crc8_maxim تابع ۱ .۱ .۱۱

ورودي آن اشاره گر داده و طول است و CRC هشت بيتي بازتاب يافته با چندجمله اي C8x0 را برمي گرداند. تابع فقط داخلي است و براي هفت بايت نخست شناسه يك سيمه استفاده مي شود.

crc32_record تابع ۲ .۱ .۱۱

روي تمام بايت هاي ركورد به جز فيلد CRC نهايي اجرا مي شود. مقدار آغازين همه يك، چندجمله اي بازتاب يافته 88320xEDB0 و خروجي معكوس شده است. هدف تشخيص ركورد ناقص، فرسوده يا متعلق به نسخه ديگر است.

SensorAddressStore_IsValidRom تابع ۳ .۱ .۱۱

يك شناسه هشت بايتي مي گيرد. اشاره گر تهي، كد خانواده غير از ۲۸ يا CRC نامنطبق نتيجه نادرست مي دهد. اين تابع هم براي فرمان جديد رايانه و هم اعتبارسنجي كل جدول استفاده مي شود.

سامانه پايش و كنترل اتاق آزمون فصل .۱۱ مرجع كامل توابع درايورها

table_is_valid تابع ۴ .۱ .۱۱

تمام ۳۲ رديف جدول را به تابع اعتبارسنجي شناسه مي دهد و با نخستين خطا بازمي گردد. سياست فعلي جدول ناقص را نمي پذيرد؛ بنابراين تعويض يك حسگر تنها وقتي ذخيره مي شود كه همه رديف هاي ديگر نيز معتبر باشند.

SensorAddressStore_Load تابع ۵ .۱ .۱۱

ركورد صفحه پاياني Flash را بدون كپي اوليه بررسي مي كند. امضا، نسخه، تعداد، CRC ركورد و CRC تك تك شناسه ها بايد درست باشند. در موفقيت، جدول به خروجي كپي مي شود. در شكست، جدول خام قديمي بررسي مي شود و در صورت اعتبار، علاوه بر كپي خروجي به قالب جديد ذخيره مي شود. اگر هر دو نامعتبر باشند نتيجه نادرست است و لايه كاربرد از پيش فرض ها استفاده مي كند.

SensorAddressStore_Save تابع ۶ .۱ .۱۱

ابتدا كل جدول ورودي را اعتبارسنجي و يك ركورد محلي مي سازد. سپس Flash را باز، دقيقاً يك صفحه را پاك و ركورد را كلمه به كلمه مي نويسد و در پايان Flash را قفل مي كند. هر خطاي HAL نتيجه نادرست مي دهد. چون پاك كردن صفحه برگشت ناپذير و نوشتن مسدودكننده است، تابع فقط در حلقه اصلي فراخواني مي شود.

## .۱۱ ۲ درايور 7880ADE

هشدار: اين بخش رفتار نسخه قديمي درايور را براي سابقه بازآرايي ثبت مي كند. مرجع API فعال
و اصلاح شده، فصل ۱۵ و فايل h7880.ade/Inc7880/ADE/Libraries است.

ADE7880_ReadRegister تابع ۱ .۲ .۱۱

ورودي ها نمونه درايور، نشاني ۱۶بيتي رجيستر، تعداد بايت و مهلت HAL هستند. بافر چهار بايتي داخلي صفر، فرمان خواندن و نشاني ارسال، سپس يك تا چهار بايت دريافت مي شود. انتخاب تراشه پيرامون كل تراكنش پايين و بالا مي رود. داده در TEMP نمونه درايور قرار مي گيرد و وضعيت خطاي HAL هنوز به فراخواننده بازگردانده نمي شود.

سامانه پايش و كنترل اتاق آزمون فصل .۱۱ مرجع كامل توابع درايورها

ADE7880_WriteRegister تابع ۲ .۲ .۱۱

داده ۳۲بيتي را متناسب با طول يك، دو يا چهار بايت با ترتيب پرارزش ترين بايت آماده مي كند، فرمان نوشتن و نشاني را پيشوند مي دهد و تراكنش SPI را زير انتخاب تراشه انجام مي دهد. طول هاي ديگر نبايد ارسال شوند و در نسخه آينده بهتر است نوع نتيجه براي خطا افزوده شود.

ADE7880_ConfigSPI تابع ۳ .۲ .۱۱

دسته SPI و پايه انتخاب تراشه را در نمونه درايور ذخيره مي كند. سه بار انتخاب تراشه را تغيير مي دهد تا رابط سريال مدار روي SPI قرار گيرد، سپس رجيستر پيكربندي دوم را مي نويسد تا انتخاب قفل شود. پس از بازنشاني سخت افزاري بايد دوباره اجرا شود.

ADE7880_Run تابع ۴ .۲ .۱۱

رجيستر اجراي پردازشگر داخلي مدار را با مقدار يك مي نويسد. ورودي فقط نمونه درايور است و پس از ارسال يك ميلي ثانيه صبر مي كند.

ADE7880_ReadVRMS تابع ۵ .۲ .۱۱

سه رجيستر ولتاژ مؤثر فازهاي A تا C را به ترتيب مي خواند. هر مقدار ۲۴بيتي از سه بايت پاياني بافر ساخته و در ساختار فاز ذخيره مي شود. تبديل به ولت در اين تابع انجام نمي شود.

ADE7880_ReadIRMS تابع ۶ .۲ .۱۱

مانند تابع ولتاژ است، با اين تفاوت كه سه جريان فاز و جريان نول را تازه مي كند. خروجي ها هنوز شمار خام رجيستر هستند.

ADE7880_ReadPowerz تابع ۷ .۲ .۱۱

توان حقيقي و توان ظاهري هر سه فاز را از شش رجيستر ۳۲بيتي مي خواند. داده در اعضاي WATT و VA قرار مي گيرد. علامت توان حقيقي بايد مطابق قالب ديتاشيت تفسير شود؛ ساختار از نوع علامت دار استفاده مي كند.

سامانه پايش و كنترل اتاق آزمون فصل .۱۱ مرجع كامل توابع درايورها

ADE7880_ReadFPower | | تابع ۸ .۲ .۱۱

چهار رجيستر توان حقيقي، راكتيو، ظاهري و ضريب توان بنيادي را مي خواند و براساس ورودي انتخاب فاز در ساختار A، B يا C مي گذارد. اين رجيسترها اشتراكي اند؛ بنابراين فراخواننده بايد پيش تر بيت انتخاب فاز رجيستر پيكربندي را تنظيم كرده باشد. برنامه فعلي اين تابع را استفاده نمي كند.

ADE7880_Reset | | تابع ۹ .۲ .۱۱

بيت بازنشاني نرم افزاري را در رجيستر پيكربندي مي نويسد و همان رجيستر را تا صفرشدن بيت بررسي مي كند. حلقه مهلت كلي ندارد؛ قطع ارتباط SPI مي تواند راه اندازي را متوقف كند. افزودن شمارنده تلاش يكي از اصلاحات ضروري آينده است.

DS18B20 و OneWire | پشته | ۳ .۱۱

## .۱۱ .۳ ۱ توابع پايه OneWire

تابع Init_OneWire اتصال سخت افزاري مبتني بر callback را اعتبارسنجي و خط را آزاد مي كند. توابع
Reset_OneWire، WriteBit_OneWire و ReadBit_OneWire زمان بندي استاندارد را اجرا مي كنند.
نمونه هاي بايتي، هشت بيت را كم ارزش ترين بيت در ابتدا جابه جا مي كنند. 8Crc_OneWire چندجمله اي دالاس/مكسيم را براي ROM و حافظه موقت محاسبه مي كند.

## .۱۱ .۳ ۲ جست وجوي شناسه

SearchFirst_OneWire حالت جست وجو را پاك و نخستين ROM معتبر را برمي گرداند. SearchNext_OneWire اختلاف بعدي در درخت بيت ها را دنبال مي كند. ساختار SearchState_OneWire متعلق به فراخواننده است؛ بنابراين چند گذرگاه يا چند نمونه كتابخانه متغير سراسري مشترك ندارند.

## .۱۱ .۳ ۳ فرمان هاي 20B18DS

StartConversion_20B18DS براي يك ROM مشخص يا با ورودي تهي براي همه حسگرهاي گذرگاه

سامانه پايش و كنترل اتاق آزمون فصل .۱۱ مرجع كامل توابع درايورها

فرمان تبديل مي فرستد. ReadScratchpad_20B18DS نه بايت را مي خواند و پيش از موفقيت CRC را كنترل مي كند؛ وقتي دقيقاً يك حسگر روي گذرگاه باشد، ROM اين تابع و تابع blocking مي تواند تهي باشد.

DecodeRaw_20B18DS علامت دما را حفظ و RawToCelsius_20B18DS واحد يك شانزدهم درجه را
به سلسيوس تبديل مي كند. مسير blocking براي پروژه كوچك مناسب است و runtime محصول از مدير غيرمسدودكننده استفاده مي كند.

## .۱۱ .۳ ۴ مدير چندگذرگاهي

ManagerInit_20B18DS پيكربندي، زمان و callbackهاي ذخيره را دريافت و نگاشت معتبر را بارگذاري مي كند. ثبت شناسه تازه و تعويض بدون ابهام رفتار ثابت آن است. ManagerDiscover_20B18DS همه گذرگاه ها را جست وجو و حضور شماره هاي ذخيره شده را تازه مي كند. APIهاي تخصيص و پاك كردن براي ابزار تعميراتي باقي مانده اند. ManagerProcess_20B18DS تبديل سراسري، انتظار موعد و حداكثر يك خواندن آدرس دار را پيش مي برد و فقط هنگام تغيير اطلاعات عمومي true برمي گرداند. جزئيات نگاشت و خطاها در فصل ۱۶ آمده است.

## .۱۱ ۴ درايور 2315AM

am2315_crc16 تابع ۱ .۴ .۱۱

تابع داخلي، CRC شانزده بيتي بازتاب يافته مودباس را با مقدار آغازين xFFFF0 و چندجمله اي 001xA0 محاسبه مي كند. ورودي داده و طول و خروجي CRC است.

## TEMP_HUM تابع ۲ .۴ .۱۱

چهار ورودي آن دسته C2I، بافر فرمان سه بايتي، بافر پاسخ هشت بايتي و آرايه دو عدد اعشاري خروجي است. ابتدا حسگر را با مرحله نشاني بيدار، سپس فرمان خواندن چهار رجيستر را ارسال و پاسخ را دريافت مي كند. كد تابع، طول، CRC، علامت دما و وضعيت HAL بررسي مي شوند. در موفقيت رطوبت و دما نوشته و رطوبت بازگردانده مي شود؛ در شكست هر دو خروجي صفر و پرچم خطا يك مي شود. اين ماژول در مسير فعال فعلي فراخواني نمي شود.

سامانه پايش و كنترل اتاق آزمون فصل .۱۱ مرجع كامل توابع درايورها

## .۱۱ ۵ فيلتر MAF

## MAF_Init تابع ۱ .۵ .۱۱

اشاره گر يك نمونه فيلتر را مي گيرد، معكوس طول پنجره را محاسبه، ميانگين و همه ۴۰ خانه را صفر و اشاره گر نوشتن را روي خانه نخست قرار مي دهد. بايد پيش از به روزرساني فراخواني شود.

MAF_Update تابع ۲ .۵ .۱۱

نمونه جديد را در خانه جاري مي نويسد و اشاره گر را حلقوي جلو مي برد. سپس همه ۴۰ خانه را جمع و ميانگين را ذخيره و برمي گرداند. ورودي دوم داده جديد است. هزينه هر فراخواني خطي است و نمونه هاي صفر اوليه در شروع روي نتيجه اثر دارند.

## .۱۱ .۵ ۳ تابع Average

اشاره گر آرايه و تعداد اعضا را مي گيرد و ميانگين حسابي برمي گرداند. اندازه صفر كنترل نشده و باعث تقسيم بر صفر مي شود؛ فراخواننده موظف است اندازه مثبت بدهد. اين تابع و كل ماژول در برنامه فعلي استفاده نمي شوند.

# فصل ۱۲ شرح جزئي بازآرايي و مرز تغييرات

## .۱۲ ۱ وضعيت پيش از بازآرايي

فايل وقفه علاوه بر هندلرهاي مولد، مالك تقريباً همه حالت هاي برنامه، ۲۰۹ متغير پراكنده قاب، خواندن ۳۴ حسگر، تراكنش هاي انرژي، محاسبات اعشاري، ارسال مسدودكننده و تفسير فرمان بود. فايل اصلي نيز آدرس ها، كنترل خروجي و callback مبدل آنالوگ را نگه مي داشت. اين پراكندگي وابستگي دوطرفه با تعداد زيادي extern ساخته و توليد مجدد CubeMX را پرخطر كرده بود.

## .۱۲ ۲ انتقال مالكيت

تمام داده هاي محصول به متغيرهاي ايستاي c.app منتقل شدند. فايل اصلي اكنون فقط دسته هاي HAL را در يك ساختار مي گذارد. فايل وقفه فقط هندلر توليدشده را صدا مي زند و callbackهاي HAL در فايل كاربرد قرار دارند. در نتيجه جريان وابستگي يك طرفه است: فايل مولد، رابط عمومي كاربرد را مي شناسد؛ كاربرد از دسته هاي تزريق شده استفاده مي كند؛ درايورها از سياست محصول آگاه نيستند.

## .۱۲ ۳ تبديل وقفه به كار معوق

پيش تر تايمر اول داخل وقفه ۲۰۹ بايت ارسال مي كرد؛ تايمر دوم همه تراكنش هاي SPI و محاسبه رطوبت را انجام مي داد؛ تايمر سوم ۳۴ تراكنش دما داشت. اكنون callback تايمر فقط يك پرچم منطقي مي نويسد و عمليات در حلقه اصلي اجرا مي شود. اين تغيير زمان انسداد وقفه را به چند دستور كاهش مي دهد و از گرسنگي UART و تداخل زمان بندي جلوگيري مي كند.

سامانه پايش و كنترل اتاق آزمون فصل .۱۲ شرح جزئي بازآرايي و مرز تغييرات

## .۱۲ ۴ فشرده سازي قاب مخابراتي

متغيرهاي جداگانه بايت پايين و بالا حذف شدند. كميت ها در ساختار ۱۶بيتي نگه داشته و هنگام ساخت قاب با تابع واحد سريال مي شوند. آرايه ابتدا صفر است؛ بنابراين ناحيه هاي رزرو بدون ده ها انتساب صريح صفر باقي مي مانند. حلقه دما جاي ۶۴ انتساب تكراري را گرفته است. جايگاه هيچ فيلد سازگار تغيير نكرده است.

## .۱۲ ۵ بازطراحي دريافت سريال

كد قبلي پس از اجراي هندلر HAL، ثبات داده را مستقيم مي خواند و همان هندلر را دوباره صدا مي زد. اين ترتيب مي توانست پرچم دريافت را پيش از خواندن پاك يا يك بايت را دوبار رسيدگي كند. نسخه جديد دريافت رسمي تك بايتي HAL را شروع مي كند، callback فقط بافر را پر مي كند و تفسير دوازده بايت در حلقه اصلي انجام مي شود. نوشتن Flash ديگر هرگز داخل ISR نيست.

## .۱۲ ۶ بازطراحي حافظه شناسه ها

نسخه قديمي از 08009000x0 مي خواند، ولي هنگام فرمان تغيير، صفحه 08008000x0 را پاك مي كرد. سپس ۶۴ مقدار هشت بايتي را از آرايه اي با ۳۲ عضو مي نوشت. هر دو نشاني نزديك انتهاي كد ۳۲ كيلوبايتي قديمي بودند و رشد برنامه مي توانست داده يا كد را تخريب كند. نسخه جديد آخرين صفحه واقعي قطعه را رزرو كرده است. لينك Keil و PlatformIO پيش از آن پايان مي يابد. فقط ۳۲ شناسه نوشته مي شوند و دو سطح CRC همراه با نسخه قالب وجود دارد. مهاجرت فقط جدول قديمي ً كاملا معتبر را مي پذيرد. اگر برق ميان پاك كردن و نوشتن قطع شود، ركورد نامعتبر تشخيص داده و پيش فرض استفاده مي شود؛ نگه داري دو نسخه افزونه اي براي تحمل كامل قطع برق هنوز پياده نشده است.

## .۱۲ ۷ اصلاح رفتار كنترل

رابطه ها و ضرايب اصلي حفظ شدند، ولي تقسيم بر نقطه تنظيم صفر، رطوبت خارج از بازه و محاسبه پنجره بزرگ تر از صد مهار شدند. حالت خاموش خودكار ديگر در دور بعدي حلقه ناخواسته دوباره فعال نمي شود. فرمان دستي همچنان ممكن است در حالت خودكار توسط كنترل بعدي بازنويسي شود؛ اين رفتار سازگار و در فصل پروتكل ثبت شده است.

سامانه پايش و كنترل اتاق آزمون فصل .۱۲ شرح جزئي بازآرايي و مرز تغييرات

## .۱۲ ۸ مرزهاي حفاظت شده CubeMX

در c.main فقط افزودن سرآيند كاربرد، ساخت ساختار دسته ها، فراخواني راه اندازي و فراخواني حلقه داخل نشانگرهاي كاربر قرار دارد. فايل هاي c.app ، c.store\_address\_sensor و درايورها خارج از مالكيت مولدند. با اين حال، فايل پروژه Keil و اندازه حافظه ممكن است توسط مولد بازنويسي شوند و پس از هر توليد بايد مطابق چك ليست فصل ساخت كنترل شوند.

## تغيير نكردند

ً

## .۱۲ ۹ مواردي كه عمدا

نرخ سريال، طول فرمان، قاب ۲۰۹ بايتي، ترتيب كم بايت، شناسه هاي پيش فرض، نگاشت فازهاي A و B، ضرايب كاليبراسيون، دو خروجي هم زمان سرمايش و منطق امكان كار هم زمان سرمايش و هيتر حفظ شده اند. بدون نرم افزار رايانه و شماتيك، تغيير اين قراردادها ريسك ناسازگاري داشت.

## .۱۲ ۱۰ موارد باقيمانده براي مرحله بعد

درايور يك سيمه بايد به ماشين حالت غيرمسدودكننده با پالس زمان سنج، تبديل هم زمان، تشخيص حضور و CRC حافظه موقت تبديل شود. رابط انرژي بايد نتيجه HAL و مهلت بازنشاني را برگرداند. پروتكل به همگام سازي، CRC، پاسخ و شماره نسخه نياز دارد. حفاظت حداقل زمان كمپرسور، واچ داگ، ثبت خطا و آزمون واحد نيز هنوز انجام نشده اند.

# فصل ۱۳ مرجع توابع توليدشده و راه اندازي سخت افزار

اين فصل بخش هايي را شرح مي دهد كه عمدتاً توسط CubeMX32STM توليد مي شوند. توضيح ها براي فهم رفتارند؛ كامنت دستي خارج از ناحيه هاي كاربر نبايد به اين فايل ها افزوده شود.

## .۱۳ ۱ فايل اصلي

## .۱۳ .۱ ۱ تابع main

نقطه ورود پس از كد راه انداز پردازنده است. ابتدا HAL، كلاك سامانه و به ترتيب پايه ها، DMA، SPI، UART، سه تايمر، C2I و ADC را راه اندازي مي كند. سپس ساختار دسته هاي كاربرد ساخته و Init_App فراخواني مي شود. حلقه بي نهايت فقط Process_App را اجرا مي كند. مقدار بازگشت نظري عدد صحيح است، ولي حلقه هرگز پايان نمي يابد.

SystemClock_Config تابع ۲ .۱ .۱۳

نوسان ساز خارجي هشت مگاهرتز، تقسيم ورودي يك و ضريب PLL برابر نه را انتخاب مي كند. كلاك پردازنده و گذرگاه پرسرعت ۷۲ مگاهرتز، گذرگاه اول ۳۶ مگاهرتز و گذرگاه دوم ۷۲ مگاهرتز مي شوند. كلاك ADC از تقسيم شش و برابر ۱۲ مگاهرتز است. هر خطاي HAL به Handler_Error مي رود.

سامانه پايش و كنترل اتاق آزمون فصل .۱۳ مرجع توابع توليدشده و راه اندازي سخت افزار

MX_ADC1_Init تابع ۳ .۱ .۱۳

مبدل نخست را در حالت اسكن و تبديل پيوسته با دو رتبه تنظيم مي كند. كانال ۵ رتبه اول و كانال ۴ رتبه دوم اند و هر دو زمان نمونه برداري .۲۳۹ ۵ سيكل دارند. هم ترازي داده راست و شروع نرم افزاري است. DMA در تابع پشتيباني پيراموني به دسته متصل مي شود.

MX_I2C1_Init تابع ۴ .۱ .۱۳

رابط نخست را با سرعت صد كيلوهرتز، آدرس دهي هفت بيتي، بدون آدرس دوم، فراخوان عمومي يا كشش غيرفعال راه اندازي مي كند. پايه ها در تابع پشتيباني به 8PB و 9PB بازنگاشت مي شوند.

MX_SPI2_Init تابع ۵ .۱ .۱۳

رابط دوم را ارباب تمام دوطرفه، هشت بيتي، پرارزش ترين بيت ابتدا، قطبيت بالا و نمونه برداري لبه دوم مي كند. انتخاب تراشه نرم افزاري و تقسيم كلاك ۶۴ است؛ با كلاك گذرگاه ۳۶ مگاهرتز نرخ تقريبي .۵۶۲ ۵ كيلوبيت برثانيه حاصل مي شود.

MX_TIM3_Init و MX_TIM2_Init ،MX_TIM1_Init توابع ۶ .۱ .۱۳

هر سه تايمر كلاك داخلي و شمارش افزايشي دارند. پيش تقسيم گر ۹۹۹۹ كلاك ۷۲ مگاهرتز را به ۷۲۰۰ هرتز مي رساند. دوره ۷۱۹۹ در تايمرهاي يك و سه رويداد يك ثانيه اي و دوره ۳۵۹۹ در تايمر دو رويداد نيم ثانيه اي مي سازد. پيش بارگذاري خودكار غيرفعال است.

MX_USART2_UART_Init تابع ۷ .۱ .۱۳

رابط دوم را با نرخ ،۹۶۰۰ هشت بيت داده، يك توقف، بدون توازن و كنترل جريان، ارسال و دريافت هم زمان و نمونه برداري شانزده برابر تنظيم مي كند.

MX_DMA_Init تابع ۸ .۱ .۱۳

كلاك كنترل كننده نخست را روشن و وقفه كانال يك را با اولويت پيش دستي دو و زير اولويت يك فعال مي كند. تنظيم جهت، اندازه داده و حالت چرخشي در تابع پشتيباني ADC انجام مي شود.

سامانه پايش و كنترل اتاق آزمون فصل .۱۳ مرجع توابع توليدشده و راه اندازي سخت افزار

MX_GPIO_Init تابع ۹ .۱ .۱۳

كلاك درگاه هاي A تا E را روشن، سطح اوليه خروجي هاي قدرت و خطوط يك سيمه را ايمن و سپس حالت پايه ها را تنظيم مي كند. خطوط قدرت پوش پول كم سرعت اند. دو خط دما روي 10PB و 7PC از ابتدا خروجي تخليه باز و در حالت آزاد بالا هستند؛ اين تنظيم در فايل IOC نيز ثبت شده است. تنظيم اوليه بالا براي خروجي هاي فعال پايين مانع پالس روشن ناخواسته مي شود.

Error_Handler تابع ۱۰ .۱ .۱۳

در نسخه مولد بدنه عملياتي ندارد. بنابراين خطاي راه اندازي فقط جريان همان تابع را برمي گرداند و سامانه ممكن است با پيراموني ناقص ادامه دهد. تبديل آن به خاموش سازي خروجي ها، ثبت علت و حلقه امن يا بازنشاني واچ داگ يك كار باز مهم است؛ پياده سازي بايد داخل ناحيه كاربر قرار گيرد.

## .۱۳ ۲ توابع پشتيباني پيراموني

HAL_MspInit تابع ۱ .۲ .۱۳

كلاك رابط عملكرد جايگزين و توان را روشن مي كند و رابط JTAG را غيرفعال ولي رابط SWD را فعال نگه مي دارد. بنابراين پايه هاي برنامه ريزي دو سيمه در دسترس و برخي پايه هاي JTAG براي GPIO آزاد مي شوند.

HAL_ADC_MspDeInit و HAL_ADC_MspInit توابع ۲ .۲ .۱۳

نسخه راه اندازي كلاك ADC و درگاه A را روشن، پايه هاي 5PA4/PA را آنالوگ، كانال نخست DMA را انتقال پيراموني به حافظه با افزايش نشاني حافظه، داده نيم كلمه و حالت چرخشي مي كند. دسته DMA به ADC پيوند و وقفه فعال مي شود. نسخه توقف همه اين منابع را آزاد مي كند.

HAL_I2C_MspDeInit و HAL_I2C_MspInit توابع ۳ .۲ .۱۳

پايه هاي 9PB8/PB را خروجي عملكرد جايگزين تخليه باز پرسرعت، بازنگاشت C2I را فعال و كلاك رابط را روشن مي كنند. تابع توقف كلاك و پايه ها را آزاد مي سازد.

سامانه پايش و كنترل اتاق آزمون فصل .۱۳ مرجع توابع توليدشده و راه اندازي سخت افزار

HAL_SPI_MspDeInit و HAL_SPI_MspInit توابع ۴ .۲ .۱۳

براي رابط دوم، پايه كلاك و خروجي داده را عملكرد جايگزين پوش پول و ورودي داده را ورودي بدون كشش مي كند. كلاك و وقفه SPI فعال مي شوند. تابع توقف ترتيب معكوس را انجام مي دهد.

## .۱۳ .۲ ۵ توابع پشتيباني تايمرها

.هستند | بخش | اين | مسئول | HAL_TIM_Base_MspDeInit و HAL_TIM_Base_MspInit | تابع دو
براساس نمونه تايمر، كلاك و وقفه تايمر يك، دو يا سه را فعال يا غيرفعال مي كنند. اولويت تايمر سه از تايمر دو بالاتر و هر دو از تايمر يك بالاتر تنظيم شده است؛ پس از بازآرايي callbackها بسيار كوتاه اند.

HAL_UART_MspDeInit و HAL_UART_MspInit توابع ۶ .۲ .۱۳

كلاك رابط دوم و درگاه D را فعال، ارسال 5PD را عملكرد جايگزين و دريافت 6PD را ورودي مي كند، بازنگاشت را فعال و وقفه UART را با اولويت بالا روشن مي سازد. تابع توقف اين تنظيمات را آزاد مي كند.

## .۱۳ ۳ هندلرهاي استثنا و وقفه

توابع خطاي سخت، مديريت حافظه، خطاي گذرگاه و دستور نامعتبر پس از ورود در حلقه بي نهايت مي مانند. وقفه تيك سامانه شمارنده ميلي ثانيه HAL را افزايش مي دهد. وقفه هاي DMA، ADC، سه تايمر، SPI و UART فقط هندلر HAL متناظر را فراخواني مي كنند. هندلرهاي سرويس سامانه، پايش اشكال و درخواست معوق بدنه كاربر ندارند. هيچ منطق محصولي نبايد مستقيماً به اين هندلرها بازگردانده شود.

## .۱۳ ۴ فايل سامانه و راه انداز

فايل c.xx1f32stm\_system متغير كلاك هسته و تنظيمات پايه پيش از ورود به برنامه را فراهم مي كند. فايل اسمبلي Keil جدول بردار، پشته، نقطه بازنشاني و انتقال به كتابخانه زمان اجرا را تعريف مي كند. PlatformIO از نسخه متناظر چارچوب خود استفاده مي كند و فايل سامانه محلي را براي جلوگيري از نماد تكراري كنار مي گذارد.

# فصل ۱۴ نشانگر زنده بودن و آزمون دو چراغ

## .۱۴ ۱ هدف آزمون

دو چراغ متصل به پايه هاي 13PC و 14PC يك نشانگر مستقل و غيرمسدودكننده براي مشاهده اجراي برنامه فراهم مي كنند. الگوي عادي فقط زماني جلو مي رود كه تابع Process_App مرتب در حلقه اصلي فراخواني شود. ثابت ماندن طولاني الگو، پس از درنظرگرفتن زمان طبيعي عمليات حسگرها، مي تواند نشانه توقف حلقه اصلي يا گيركردن يك تابع باشد. الگوي خطاي سريع نيز ورود برنامه به Handler_Error را از اجراي عادي متمايز مي كند.
اين نشانگر جايگزين واچ داگ، ثبت خطا يا ديباگر نيست؛ چراغ فقط يك مشاهده سريع ميداني از زنده بودن حلقه اصلي ارائه مي دهد.

## .۱۴ ۲ اتصال الكتريكي و قطب فعال

هر چراغ بايد مقاومت سري مستقل داشته باشد. براي كاهش بار پايه هاي دامنه پشتيبان درگاه سوم، مقاومت ۶۸۰ اهم تا يك كيلواهم و چراغ كم جريان پيشنهاد مي شود. اتصال پيش فرض نرم افزار فعال پايين است:

3.3 V -> series resistor -> LED anode -> LED cathode -> PC13 or PC14

در اين اتصال، صفر منطقي چراغ را روشن مي كند. اگر اتصال برد از خروجي پايه به مقاومت و سپس چراغ و زمين
Application/Inc/diagnostic\_led.h | فايل در DIAGNOSTIC_LED_ACTIVE_LOW | مقدار ،است
بايد از يك به صفر تغيير كند. دو چراغ نبايد يك مقاومت مشترك داشته باشند. زمين برد و پروگرامر نيز بايد مشترك باشد.

سامانه پايش و كنترل اتاق آزمون فصل .۱۴ نشانگر زنده بودن و آزمون دو چراغ

## .۱۴ ۳ تنظيمات مولد كد

در فايل ioc107.F32STM هر دو پايه به صورت خروجي پوش پول با سرعت پايين، بدون مقاومت كشش داخلي و سطح اوليه بالا ثبت شده اند. برچسب ها به ترتيب 1_LED_DEBUG و 2_LED_DEBUG هستند. منبع كلاك كم فركانس خارجي فعال نيست؛ بنابراين استفاده از 14PC به عنوان خروجي با تنظيم كلاك موجود تعارض ندارد.
ماژول عيب يابي هنگام راه اندازي همين تنظيم را دوباره و به صورت بي خطر اعمال مي كند. اين تكرار عمدي است تا اگر خطاي راه اندازي پيش از پايان تابع تنظيم پايه ها رخ داد، امكان نمايش خطا باقي بماند. پس از هر توليد مجدد بايد وجود دو پايه، برچسب ها، سطح اوليه بالا و سرعت پايين كنترل شود.

## .۱۴ ۴ فايل ها و رابط عمومي

پياده سازي در c.led\_diagnostic/Src/Application و رابط عمومي در /Inc/Application
h.led\_diagnostic قرار دارد. فايل پياده سازي مستقل از فايل هاي مولد است و به پروژه Keil نيز افزوده شده است؛ PlatformIO آن را به طور خودكار از پوشه سورس پيدا مي كند.

DiagnosticLed_Init تابع ۱ .۴ .۱۴

ورودي و خروجي ندارد. كلاك درگاه GPIOC را فعال، دو پايه را خروجي پوش پول كم سرعت و هر دو چراغ را خاموش مي كند. چند بار فراخواني آن مجاز است، ولي هر بار حالت و گام الگو را بازنشاني مي كند.

DiagnosticLed_SetMode تابع ۲ .۴ .۱۴

يك مقدار از نوع Mode_DiagnosticLed مي گيرد، الگوي جديد را انتخاب و اجراي آن را از گام نخست آغاز مي كند. مقدار خارج از محدوده به حالت خاموش تبديل مي شود. اين تابع براي متن اصلي طراحي شده و نبايد هم زمان از وقفه تغيير داده شود.

DiagnosticLed_Process تابع ۳ .۴ .۱۴

ورودي و خروجي ندارد و بايد با بيشترين تكرار ممكن در حلقه اصلي صدا زده شود. زمان را با GetTick_HAL مي خواند و با تفريق بدون علامت، عبور شمارنده ميلي ثانيه از بيشينه را نيز درست مديريت مي كند. اگر موعد گام بعد نرسيده باشد بلافاصله بازمي گردد؛ در نتيجه هيچ تأخير مسدودكننده اي به سامانه تحميل نمي شود.

سامانه پايش و كنترل اتاق آزمون فصل .۱۴ نشانگر زنده بودن و آزمون دو چراغ

اگر حلقه اصلي براي چند گام متوقف شود، تابع در اولين اجراي بعدي تعداد گام هاي گذشته را محاسبه و الگو را به موقعيت درست مي برد. اين رفتار از انباشته شدن تأخير زماني جلوگيري مي كند.

DiagnosticLed_GetMode تابع ۴ .۴ .۱۴

ورودي ندارد و حالت فعال را برمي گرداند. اين تابع براي مشاهده در ديباگر، گزارش وضعيت يا توسعه فرمان هاي عيب يابي آينده درنظر گرفته شده است و سخت افزار را تغيير نمي دهد.

## .۱۴ ۵ الگوهاي قابل انتخاب

DIAGNOSTIC_LED_MODE_OFF حالت ۱ .۵ .۱۴

هر دو چراغ خاموش مي شوند. اين حالت براي غيرفعال كردن آزمون بدون حذف كد است.

DIAGNOSTIC_LED_MODE_HEARTBEAT حالت ۲ .۵ .۱۴

دو تپ كوتاه و سپس مكث ايجاد مي شود. اين الگو نشانگر آرام براي بهره برداري دائمي است.

DIAGNOSTIC_LED_MODE_DANCE حالت ۳ .۵ .۱۴

چراغ اول، چراغ دوم، هر دو و سپس مكث اجرا مي شود. چرخه تقريباً يك ثانيه است و حالت پيش فرض برنامه محسوب مي شود.

DIAGNOSTIC_LED_MODE_ERROR حالت ۴ .۵ .۱۴

دو چراغ هر ۱۵۰ ميلي ثانيه به سرعت جابه جا مي شوند. اين الگو نشان دهنده ورود به خطاي بحراني است.

## .۱۴ ۶ اتصال به چرخه برنامه

تابع Init_App ماژول را راه اندازي و حالت رقص را انتخاب مي كند. تابع Process_App پيش از رسيدگي به ارتباط و نمونه برداري، يك بار تابع پردازش چراغ را اجرا مي كند. اگر برنامه وارد Handler_Error شود، دو پايه

سامانه پايش و كنترل اتاق آزمون فصل .۱۴ نشانگر زنده بودن و آزمون دو چراغ

دوباره راه اندازي و حالت خطا در يك حلقه اختصاصي پردازش مي شود. براي استفاده آرام تر پس از پايان آزمون كافي است در c.app/Src/Application حالت اوليه از رقص به ضربان تغيير كند؛ حذف فراخواني پردازش توصيه نمي شود، زيرا ارزش نشانگر زنده بودن از بين مي رود.

## .۱۴ ۷ پروگرام با رابط چهار سيمه

براي پروگرام معمولي اتصال هاي زمين مشترك، ولتاژ مرجع .۳ ۳ ولت، داده رابط و كلاك رابط لازم اند. نام دو خط رابط به ترتيب SWDIO روي 13PA و SWCLK روي 14PA است. در صورت دشواري اتصال، خط بازنشاني نيز مي تواند به عنوان سيم پنجم افزوده شود. پس از اتصال Link-J و روشن كردن هدف، فرمان هاي زير خروجي را ساخته و پروگرام مي كنند:

pio run
pio run --target upload

در Keil نيز هدف 107F32STM باز، پروژه ساخته و گزينه بارگذاري انتخاب مي شود. فايل /ARM-MDK uvprojx107.F32STM از قبل ماژول چراغ را در گروه كد كاربر دارد.

## .۱۴ ۸ نتيجه پروگرام انجام شده

در تاريخ ،۱۴۰۵/۰۶/۲۳ بارگذاري مستقيم از همين پروژه با PlatformIO و Link-J انجام شد. پروگرامر از طريق رابط USB شناسايي و ولتاژ مرجع هدف .۳ ۳۲۵ ولت گزارش شد. قطعه VC107F32STM و هسته 3M-Cortex از مسير SWD با موفقيت شناسايي شدند. پاك كردن، نوشتن، تطبيق محتواي حافظه و بازنشاني نهايي همگي بدون خطا پايان يافتند. بنابراين فايل اجرايي اين نسخه روي سخت افزار بارگذاري شده است؛ مشاهده فيزيكي ترتيب چراغ ها بايد توسط كاربر روي برد تأييد شود.

## .۱۴ ۹ روند آزمون و تفسير نتيجه

ابتدا براي جلوگيري از عملكرد ناخواسته، بارهاي قدرت رله، هيتر و سرمايش قطع يا ايمن شوند. سپس برنامه بارگذاري و برد بازنشاني شود.

.۱ در ثانيه نخست بايد ترتيب چراغ اول، چراغ دوم و هر دو مشاهده شود.

سامانه پايش و كنترل اتاق آزمون فصل .۱۴ نشانگر زنده بودن و آزمون دو چراغ

.۲ ادامه منظم چرخه نشان مي دهد حلقه اصلي در حال اجرا و تيك سامانه فعال است. .۳ مكث يا پرش كوتاه بايد با ديباگر و شمار خطاي ارتباط 7880ADE زمان سنجي و ريشه يابي شود. .۴ ثابت شدن طولاني الگو يعني حلقه اصلي ديگر تابع پردازش را اجرا نمي كند يا تيك سامانه متوقف شده است.
.۵ تناوب سريع و پيوسته چراغ ها يعني برنامه وارد هندلر خطاي بحراني شده است. .۶ خاموش بودن دائمي هر دو چراغ مي تواند از قطب اشتباه، سيم بندي نادرست، نبود مقاومت و تغذيه، پروگرام نشدن يا اجرا نشدن برنامه ناشي شود.

اين آزمون فقط راه اندازي اوليه و زنده بودن نرم افزار را نشان مي دهد. تأييد 7880ADE، كاليبراسيون و بازيابي ارتباط بايد مطابق چك ليست فصل بعد انجام شود. سنسورها، ارتباط سريال، حافظه و كنترل بارها مربوط به مراحل توسعه بعدي اند و در نسخه فعال فعلي اجرا نمي شوند.

# فصل ۱۵ راه اندازي ارتباط و اندازه گيري با 7880ADE

اين فصل مرجع درايور و كاليبراسيون است. نسخه فعال از همان پايه ها و ضرايب استفاده مي كند، اما راه اندازي در لايه كاربرد ماشين حالت شده و چراغ ها مستقل از وضعيت ارتباط يكي درميان اند. جزئيات اجرا، متغيرهاي تشخيص خطا و تأييد سخت افزاري جديد در فصل ۱۸ آمده است.

## .۱۵ ۱ دامنه اين مرحله و نتيجه قابل انتظار

در اين مرحله رابط2SPI ميكروكنترلر دوباره فعال، كتابخانه 7880ADE مستقل از خانواده ميكروكنترلر بازنويسي و خواندن دوره اي كميت هاي اصلي به برنامه افزوده شد. برنامه در هر نمونه، ولتاژ مؤثر، جريان مؤثر، توان اكتيو، توان ظاهري و ضريب توان هر سه فاز و همچنين جريان مؤثر نول را مي خواند. داده خام كامل در متغير electrical_app_g منتشر مي شود و در پنجره Watch قابل مشاهده است. علاوه بر داده خام، مقدارهاي مهندسي هر سه فاز با جدول ضرايب پيش فرض برد در آرايه هاي متناظر v_voltage قرار مي گيرد. معتبر بودن هر خانه و منبع ضريب آن به ترتيب در valid_voltage و source_voltage ثبت مي شود. خواندن رجيستر با تبديل مقدار خام به واحد فيزيكي يكسان نيست. ضريب توان از قالب ثابت خود تراشه مستقيماً به بازه منفي يك تا مثبت يك تبديل پذير است، اما تبديل ديگر كميت ها به ولت، آمپر و وات وابسته به نسبت ترانس جريان، شبكه تقسيم ولتاژ، مقاومت بار، بهره ورودي و كاليبراسيون واقعي همان برد است. جدول پيش فرض براي راه اندازي و مشاهده هر سه فاز مفيد است، ولي تا آزمون با مرجع معتبر نبايد مبناي حفاظت، ايمني يا اندازه گيري نهايي قرار گيرد.

سامانه پايش و كنترل اتاق آزمون فصل .۱۵ راه اندازي ارتباط و اندازه گيري با 7880ADE

## .۱۵ ۲ منبع بازيابي اتصال هاي قبلي

مخزن هنگام آغاز اين مرحله هيچ تاريخچه Git نداشت، ولي فايل پشتيبان قديمي همين پروژه در مسير بيروني
ioc107.F32STM/Main/backup/software/embedded هنوز موجود بود. تنظيمات آن با گزارش
قبلي و سورس قديمي تطبيق داده شد. هر سه منبع اتصال زير را تأييد كردند:

پايه ميكرو سيگنال تنظيم لازم 12PB SS / CS_ADE خروجي پوش پول، فعال پايين، سطح بي كار بالا 13PB SCK_2SPI خروجي عملكرد جايگزين پوش پول 14PB MISO_2SPI ورودي بدون كشش داخلي 15PB MOSI_2SPI خروجي عملكرد جايگزين پوش پول

در فايل هاي قديمي هيچ پايه اي براي RESET يا 1IRQ تراشه تعريف نشده بود. به همين دليل نسخه حاضر از بازنشاني نرم افزاري و بررسي رجيستر RSTDONE1.STATUS استفاده مي كند. اگر در شماتيك واقعي اين دو خط به ميكرو متصل اند، شماره پايه ها بايد در مرحله بعد از روي شماتيك قطعي شود؛ تا آن زمان نبايد پايه اي براي آن ها حدس زده شود.

## .۱۵ ۳ كنترل الزامات ديتاشيت

مرجع اين پياده سازي ديتاشيت رسمي بازبيني C شركت Devices Analog است: C .Rev 7880ADE (https://www.analog.com/media/en/technical-documentation/data-sheets/ADE7880.pdf) نكات زير مستقيماً در طراحي رعايت شده اند:

- تراشه پس از روشن شدن تقريباً ۴۰ ميلي ثانيه براي آماده شدن نياز دارد؛ كتابخانه ۵۰ ميلي ثانيه حاشيه
مي دهد.
- رابط پيش فرض پس از reset از نوع C2I است. سه گذار پايه SS از بالا به پايين رابط را به SPI تغيير مي دهد.
- نوشتن رجيستر هشت بيتي 2CONFIG پس از انتخاب SPI، انتخاب رابط را قفل مي كند.
- داده روي لبه بالارونده SCLK نمونه برداري و پرارزش ترين بيت ابتدا منتقل مي شود.
- بيشينه كلاك مجاز SPI برابر .۲ ۵ مگاهرتز است. نرخ انتخاب شده .۵۶۲ ۵ كيلوبيت برثانيه حاشيه كافي

سامانه پايش و كنترل اتاق آزمون فصل .۱۵ راه اندازي ارتباط و اندازه گيري با 7880ADE

دارد.
- پايان reset نرم افزاري با دو شرط كنترل مي شود: 0=SWRST و 1=RSTDONE.
- پردازشگر داخلي تنها پس از نوشتن و بازخواني موفق مقدار يك در رجيستر RUN شروع مي شود.

## .۱۵ ۴ تنظيم از صفر در CubeMX32STM

فايل ioc107.F32STM مرجع تنظيم مولد است. براي بازسازي دستي همين پيكربندي مراحل زير انجام شود:

.۱ فايل پروژه را در نسخه سازگار CubeMX32STM باز كنيد و قطعه VCTx107F32STM با بسته 100LQFP را تغيير ندهيد.

.۲ از بخش Connectivity، رابط 2SPI را روي Master Duplex-Full قرار دهيد.

شده SPI2_MOSI | برابر PB15 و SPI2_MISO | برابر PB14 ،SPI2_SCK | برابر PB13 | كنيد | كنترل | .۳
باشد.
.۴ پايه 12PB را Output GPIO با برچسب CS_ADE انتخاب كنيد. سطح اوليه بايد High، نوع خروجي
.باشد High | سرعت و No pull | كشش ،Push-Pull
.۵ در تنظيم هاي 2SPI حالت ارباب، جهت دوخطه، طول هشت بيت، High=CPOL، Edge 2=CPHA، انتخاب تراشه نرم افزاري، First MSB و تقسيم كننده ۶۴ را انتخاب كنيد. .۶ مقدار محاسبه شده كلاك بايد با كلاك گذرگاه اول ۳۶ مگاهرتز برابر .۵۶۲ ۵ كيلوبيت برثانيه باشد. .۷ فعال كردن وقفه 2SPI براي روش polling اين مرحله لازم نيست. افزودن بي دليل وقفه فقط پيچيدگي ايجاد مي كند.
.۸ در Generator Code > Manager Project گزينه نگه داري كد كاربر فعال و حذف فايل هاي قبلي غيرفعال باقي بماند.
.۹ كد را توليد و سپس تفاوت ها را با Git بازبيني كنيد. وجود Init_2SPI_MX و تنظيم پايه ها نتيجه مورد انتظار مولد است.

فراخواني هاي برنامه داخل ناحيه هاي حفاظت شده فايل اصلي هستند:

۱ | /* USER CODE BEGIN 2 */
۲ | App_Init(&hspi2);
۳ | /* USER CODE END 2 */
۴ | /* USER CODE BEGIN WHILE */

سامانه پايش و كنترل اتاق آزمون فصل .۱۵ راه اندازي ارتباط و اندازه گيري با 7880ADE

۵ | while (1) {
۶ | App_Process();
۷ | /* USER CODE END WHILE */
۸ | }

در نتيجه، توليد مجدد CubeMX ممكن است بدنه هاي مولد Init_2SPI_MX و MspInit_SPI_HAL را بازسازي كند، اما منطق كتابخانه و برنامه در پوشه هاي 7880ADE/Libraries و Application پاك نمي شود و دو نقطه اتصال نيز داخل بلوك كاربر حفظ مي شوند.

## .۱۵ ۵ معماري كتابخانه قابل استفاده مجدد

كتابخانه فقط دو فايل دارد:

- h7880.ade/Inc7880/ADE/Libraries: انواع، رجيسترها و رابط عمومي؛
. | كاليبراسيون | و | خواندن | ،reset ، | پروتكل | :Libraries/ADE7880/Src/ade7880.c ◦

كتابخانه هدر h.hal_xx1f32stm را نياز ندارد. وابستگي سخت افزار با ساختار Transport_7880ADE به آن تزريق مي شود:

۱ | typedef struct {
۲ | void *context;
۳ | ADE7880_Status (*write)(void *, const uint8_t *, size_t, uint32_t);
۴ | ADE7880_Status (*read)(void *, uint8_t *, size_t, uint32_t);
۵ | void (*select)(void *, bool active);
۶ | void (*delay_ms)(void *, uint32_t);
۷ | } ADE7880_Transport;

براي انتقال كتابخانه به ميكرو ديگر فقط همين چهار callback پياده مي شود. براي مثال در 32STM، callback
نوشتن به Transmit_SPI_HAL و callback خواندن به Receive_SPI_HAL وصل شده است. در پروژه
ديگر مي توان آن ها را به درايور LL، IDF-ESP، Zephyr يا يك SPI نرم افزاري متصل كرد، بدون آن كه فايل كتابخانه تغيير كند.
راهنماي مستقل و كوتاه استفاده از كتابخانه نيز در فايل md.README7880/ADE/Libraries قرار دارد؛ بنابراين براي انتقال ماژول به پروژه ديگر لازم نيست گزارش كامل محصول همراه آن كپي شود.

سامانه پايش و كنترل اتاق آزمون فصل .۱۵ راه اندازي ارتباط و اندازه گيري با 7880ADE

## .۱۵ ۶ قرارداد كامنت گذاري و روش خواندن كد

تمام تعريف هاي عمومي كتابخانه در h7880.ade با قالب Doxygen انگليسي مستند شده اند. هر تابع عمومي بايد هدف، پارامترهاي ورودي، خروجي و خطاهاي قابل انتظار را داشته باشد. اعضاي ساختار، مقدارهاي enum و رجيسترها نيز كنار تعريف خود توضيح انگليسي دارند. فايل پياده سازي علاوه بر توضيح هر تابع، دليل مراحل غير بديهي مانند ترتيب بايت، بسط علامت، جلوگيري از انتشار نمونه ناقص و پاك كردن RSTDONE را ثبت مي كند.
قاعده ادامه پروژه چنين است:
- نام تابع و متغير بايد هدف را بيان كند و كامنت جاي نام گذاري نامناسب را نگيرد؛
- رابط عمومي با brief@، param @و return @انگليسي مستند شود؛
- عدد ثابت سخت افزاري بايد واحد و علت داشته باشد؛
- كامنت بايد دليل يا قرارداد را توضيح دهد، نه آن كه همان دستور ساده را تكرار كند؛
- هر تغيير رفتار در گزارش فارسي و فايل وضعيت نيز ثبت شود.

## .۱۵ ۷ مرجع سريع توابع كتابخانه

- Init_7880ADE: ثبت و كنترل چهار callback سخت افزار؛ هنوز با تراشه تبادل انجام نمي دهد.
- Begin_7880ADE: انتخاب SPI، بازنشاني نرم افزاري، انتظار محدود و شروع DSP.
- ReadRegister_7880ADE: خواندن عمومي رجيسترهاي ،۸ ۱۶ يا ۳۲بيتي.
- WriteRegisterVerified_7880ADE: نوشتن رجيستر و مقايسه بازخواني براي تشخيص خطا.
- ReadPhase_7880ADE: خواندن همه كميت هاي خام يك فاز.
- ReadAll_7880ADE: ساخت نمونه كامل سه فاز و نول؛ در خطا خروجي نيمه كاره منتشر نمي شود.
- CalculateLinearCalibration_7880ADE: محاسبه offset/scale از دو نقطه خام و مرجع.
- ApplyLinearCalibration_7880ADE: تبديل يك شمار خام به واحد مهندسي.
- Convert_7880ADE: تبديل يك نمونه كامل با مجموعه ضرايب همه كانال ها.
- SetPhaseCalibration_App: جايگزيني مستقل ضريب ولتاژ، جريان، توان اكتيو يا توان ظاهري هر فاز.

سامانه پايش و كنترل اتاق آزمون فصل .۱۵ راه اندازي ارتباط و اندازه گيري با 7880ADE

- CalibratePhaseMultiPoint_App: برازش و نصب كاليبراسيون چندنقطه اي براي يك كميت و يك فاز.
- CalibrateNeutralCurrentMultiPoint_App: برازش و نصب مستقل جريان نول.
- ResetCalibrationToDefaults_App: حذف ضرايب زمان اجرا و بازگرداندن جدول آغازكار.

ساده ترين مسير استفاده در همين پروژه فقط دو فراخواني دارد: يك بار (2hspi(&Init_App بعد از راه اندازي 2SPI و سپس اجراي پيوسته ()Process_App در حلقه اصلي. لايه برنامه ساختار انتقال، بازيابي خطا، زمان نمونه برداري و تبديل ولتاژ را مديريت مي كند؛ كاربر معمولاً فقط electrical_app_g را مي خواند.

## .۱۵ ۸ توالي راه اندازي برنامه

تابع Init_App پس از راه اندازي پايه ها و 2SPI فراخواني مي شود. توالي دقيق آن چنين است:

.۱ ماژول دو LED راه اندازي مي شود.

.۲ callbackهاي HAL در يك Transport_7880ADE قرار مي گيرند.
.۳ Init_7880ADE اعتبار callbackها را بررسي و CS را غيرفعال مي كند. .۴ Begin_7880ADE پنجاه ميلي ثانيه صبر، سه پالس CS ايجاد و SPI را با 2CONFIG قفل مي كند. .۵ reset نرم افزاري با مهلت ۱۰۰ ميلي ثانيه اجرا مي شود؛ حلقه نامحدود وجود ندارد. .۶ رجيستر RUN نوشته و بازخواني مي شود. .۷ رجيستر هشت بيتي VERSION خوانده و در وضعيت ديباگ ثبت مي شود. .۸ موفقيت حالت رقص LED و خطا تناوب سريع دو LED را فعال مي كند.

اگر ارتباط قطع باشد، برنامه در راه اندازي گير نمي كند. وضعيت آفلاين ثبت و هر دو ثانيه تلاش مجدد انجام مي شود. پس از بازيابي ارتباط، الگوي LED خودكار به رقص برمي گردد. در حالت سالم يك snapshot كامل تقريباً هر يك ثانيه خوانده مي شود.

## .۱۵ ۹ رجيسترها و قالب داده خوانده شده

سامانه پايش و كنترل اتاق آزمون فصل .۱۵ راه اندازي ارتباط و اندازه گيري با 7880ADE

كميت فاز A فازهاي C/B تفسير جريان مؤثر 0C43x0 4C43x2/0C43x0 مقدار ۲۴بيتي بدون علامت كاربردي ولتاژ مؤثر 1C43x0 5C43x3/0C43x0 مقدار ۲۴بيتي بدون علامت كاربردي توان اكتيو 513xE0 515xE514/0xE0 مقدار ۲۴بيتي علامت دار با بسط علامت توان ظاهري 519xE0 B51xE/0A51xE0 داده ۲۴بيتي در كلمه ۳۲بيتي عدد علامت دار 1.15Q؛ هر LSB برابر

2

−15

0xE903/0xE904 | 0xE902 | توان | ضريب

جريان نول 6C43x0 ندارد مقدار ۲۴بيتي

در نسخه قديمي ضريب توان از رجيستر هارمونيك مشترك FPF خوانده مي شد و انتخاب فاز نيز درست تضمين نشده بود. نسخه حاضر مستقيماً از سه رجيستر CPF/BPF/APF استفاده مي كند؛ بنابراين هم ساده تر و هم مطابق بخش Factor Power ديتاشيت است.

.۱۵ ۱۰ خواندن در Code VS و PlatformIO

پس از بازكردن ريشه پروژه، افزونه IDE PlatformIO را نصب و محيط jlink_vc107f32stm را انتخاب كنيد. ساخت از ترمينال:

pio run -e stm32f107vc_jlink

اگر فرمان pio در PATH نيست، روي ويندوز مي توان فايل اجرايي محيط خود PlatformIO را اجرا كرد:

%USERPROFILE%\.platformio\penv\Scripts\platformio.exe run \
-e stm32f107vc_jlink

براي پروگرام:

pio run -e stm32f107vc_jlink --target upload

براي ديباگ، breakpoint را بعد از انتساب raw.electrical_app_g در Process_App قرار دهيد و متغير
electrical_app_g را به Watch اضافه كنيد. نتيجه سالم بايد چنين ويژگي هايي داشته باشد:

سامانه پايش و كنترل اتاق آزمون فصل .۱۵ راه اندازي ارتباط و اندازه گيري با 7880ADE

؛online=true ◦

؛last_status=ADE7880_STATUS_OK ◦
- version_die داراي مقدار ثابت و تكرارپذير؛
- افزايش samples_successful تقريباً هر ثانيه؛
- تازه شدن ms_at_updated؛
- ثابت ماندن errors_communication در صفر.

## .۱۵ ۱۱ ساخت و ديباگ در MDK Keil

فايل uvprojx107.F32STM/ARM-MDK باز شود. كتابخانه از قبل در گروه Reusable/Libraries عضو است و مسير include آن نيز ثبت شده است. بعد از توليد مجدد CubeMX موارد زير كنترل شود:

.۱ فايل هاي c.app و c.led_diagnostic از پوشه Src/Application هنوز عضو پروژه باشند.

.۲ فايل c7880.ade/Src7880/ADE/Libraries فقط يك بار عضو پروژه باشد.

.باشند Include Paths در Libraries/ADE7880/Inc و Application/Inc | مسيرهاي | .۳
.باشند | شده | تعريف STM32F107xC و USE_HAL_DRIVER | نمادهاي | .۴
.۵ هدف با گزينه Target Build بدون warning ساخته شود.

در پنجره Watch همان متغير electrical_app_g اضافه شود. براي جلوگيري از توقف طولاني سيستم قدرت، breakpoint تنها هنگام جدا بودن بارها استفاده شود. اگر برنامه بايد آزاد اجرا شود، از Watch با به روزرساني دوره اي و بدون توقف مكرر بهره بگيريد.

ساخت واقعي همين پروژه با Keil و 6.24 Compiler Arm اجرا شد و با نتيجه (s(Warning 0 ,)s(Error 0 پايان يافت. اندازه هاي گزارش شده برابر 9628=Code، 476=data-RO، 12=data-RW و 1460=data-ZI
بايت بودند و فايل HEX نيز توليد شد. خطاهاي اوليه همگي از ناشناخته بودن HandleTypeDef_DMA آغاز مي شدند. فايل پياده سازي DMA مربوط به HAL در پروژه وجود داشت، ولي تعريف ENABLED_MODULE_DMA_HAL در /Core h.conf_hal_xx1f32stm/Inc غيرفعال بود. با فعال كردن اين تعريف، نوع هاي مورد نياز handleهاي UART/TIM/SPI/C2I پيش از استفاده در هدرهاي HAL تعريف شدند. اين يك وابستگي تعريفي در HAL است و به تنهايي به معني استفاده منطق برنامه از انتقال DMA نيست.

سامانه پايش و كنترل اتاق آزمون فصل .۱۵ راه اندازي ارتباط و اندازه گيري با 7880ADE

## .۱۵ ۱۲ كاليبراسيون دو نقطه اي

نوع LinearCalibration_7880ADE دو عدد scale و offset دارد و رابطه زير را اعمال مي كند:

engineering = raw * scale + offset

براي نمونه، فرض كنيد در دو نقطه مرجع ۱۰۰ و ۲۳۰ ولت، رجيستر ولتاژ به ترتيب ۱۱۰۰۰۰۰ و ۲۵۵۰۰۰۰ باشد. محاسبه ضريب بدون دست كاري دستي فرمول چنين است:

۱ ADE7880_LinearCalibration voltage_a;

۲
۳ | if (ADE7880_CalculateLinearCalibration(
۴ | 1100000.0F, 100.0F,
۵ | 2550000.0F, 230.0F,
۶ | &voltage_a) == ADE7880_STATUS_OK) {
۷ | App_SetVoltageCalibration(ADE7880_PHASE_A, &voltage_a);
۸ | }

سپس Convert_7880ADE يك snapshot خام و ساختار ضرايب را به مقادير مهندسي تبديل مي كند. بهتر است ضرايب هر فاز مستقل باشند. روند عملي كاليبراسيون:

.۱ برد و مرجع اندازه گيري حداقل تا رسيدن دما و تغذيه به حالت پايدار روشن بمانند. .۲ براي هر فاز دو يا چند نقطه دور از هم انتخاب شود؛ نقطه صفر به تنهايي براي RMS مناسب نيست. .۳ در هر نقطه ميانگين چند ده snapshot خام ثبت شود. .۴ مقدار مرجع كاليبره شده هم زمان ثبت و offset/scale محاسبه شود. .۵ ضرايب با شماره سريال برد، تاريخ، ابزار مرجع و شرايط آزمون ذخيره شوند. .۶ پس از اعمال ضرايب، نقطه سوم كه در محاسبه استفاده نشده كنترل شود.

## .۱۵ .۱۲ ۱ ضرايب ولتاژ بازيابي شده و خروجي فعلي

در سورس قديمي همين برد تبديل زير پيدا شد:

phase A volts = AVRMS * 0.00055963 * 1.017

سامانه پايش و كنترل اتاق آزمون فصل .۱۵ راه اندازي ارتباط و اندازه گيري با 7880ADE

phase B volts = BVRMS * 0.00055963

اين دو ضريب اكنون هنگام Init_App بارگذاري مي شوند. پس از نخستين نمونه موفق، خروجي هاي زير در Watch قابل استفاده اند:

؛A/B/C | فازهاي | تقريبي | ولتاژ :voltage_v[0/1/2] ◦
- true]=0/1/2[valid_voltage: تبديل جدول پيش فرض پس از نخستين نمونه كامل انجام شده است؛
- [0/1/2]source_voltage: مقدار DEFAULT_CALIBRATION_APP تا زماني كه ضريب اندازه گيري شده نصب
نشده باشد؛
- ضريب اوليه فاز C از فاز B كپي شده و بايد روي سخت افزار واقعي كنترل شود.

با فراخواني SetVoltageCalibration_App منبع ضريب همان فاز «كاربر» ثبت مي شود و نمونه بعدي با ضريب جديد منتشر خواهد شد. براي تكميل كاليبراسيون جريان و توان هنوز نسبت CT، مقدار مقاومت burden، شبكه ورودي و محدوده نامي لازم است.

## .۱۵ .۱۲ ۲ مشاهده جريان، توان و ضريب توان در ديباگر

درايور از ابتدا رجيسترهاي جريان RMS، توان اكتيو، توان ظاهري و ضريب توان را نيز در هر snapshot مي خواند. اين داده ها در ساختار خام زير قرار دارند:

- [0]phase.raw براي فاز A؛
- [1]phase.raw براي فاز B؛
- [2]phase.raw براي فاز C؛
.نول | جريان | براي raw.neutral_current_rms ◦

براي نمونه، پيش از انجام هر كاليبراسيون مي توان در Watch ساختار [0]phase.raw.electrical_app_g را
فاز | براي را power_factor_q15 و apparent_power ،active_power ،current_rms | اعضاي و كرد باز
A ديد. اين مقادير به جز ضريب توان، شمار خام پردازشگر داخلي تراشه هستند و واحد آمپر يا وات ندارند. نسخه جديد برنامه فيلدهاي مستقيم و خواناي زير را نيز منتشر مي كند:

سامانه پايش و كنترل اتاق آزمون فصل .۱۵ راه اندازي ارتباط و اندازه گيري با 7880ADE

فيلد در electrical_app_g معني و شرط استفاده a_current آرايه جريان RMS برحسب آمپر. w_power_active آرايه توان اكتيو برحسب وات. va_power_apparent آرايه توان ظاهري برحسب ولت آمپر. factor_power آرايه ضريب توان علامت دار در بازه -۱ تا .+۱ جريان نول برحسب آمپر؛ فقط با پرچم اعتبار متناظر قابل
استفاده است.

neutral_current_a

آرايه abs_factor_power بزرگي ضريب توان را در بازه صفر تا يك و آرايه polarity_current جهت جبران CT هر فاز را به صورت NORMAL يا REVERSED نشان مي دهد. سه عضو هر آرايه به ترتيب فازهاي C/B/A هستند. براي جريان، توان اكتيو و توان ظاهري به ترتيب پرچم هاي زير كنترل شوند:

؛current_valid ◦

؛active_power_valid ◦

.apparent_power_valid ◦

ضريب توان پس از يك snapshot كامل با true=valid_factor_power قابل استفاده است. 2 دارد و برنامه

رجيسترهاي CPF/BPF/APF اعداد علامت دار 1.15Q هستند؛ بنابراين هر LSB وزن ⁻¹⁵ آن ها را با تقسيم بر ۳۲۷۶۸ به ضريب توان تبديل مي كند. اين تبديل به نسبت CT يا شبكه ولتاژ وابسته نيست. علامت PF مطابق قرارداد تراشه اطلاعات پيش فاز/پس فاز بودن را نيز حمل مي كند. مقدار آمپر و وات به سخت افزار همان برد وابسته است. در نسخه نخست اين بخش، چون ضريب كاليبراسيون جريان و توان بارگذاري نشده بود، برنامه اين فيلدها را عمداً صفر و پرچم اعتبارشان را نادرست نگه مي داشت؛ بنابراين تغيير داده خام همراه با صفر ماندن مقدار مهندسي نشانه خرابي SPI نبود. در بازبيني سورس پشتيبان همين برد، ضرايب زير براي فازهاي B/A پيدا شدند. كد قديمي نتيجه را در متغير صحيح ۱۶بيتي و بسته ارتباطي قرار مي داد. آزمون واقعي با لامپ حدود ۲۰ وات نشان داد خروجي قديمي جريان برحسب صدم آمپر و خروجي توان برحسب دهم وات بوده است: عددهاي 17 و 231 به ترتيب حدود 0.17 A و W 23.1 هستند. بنابراين تبديل درست به واحدهاي SI چنين است:

سامانه پايش و كنترل اتاق آزمون فصل .۱۵ راه اندازي ارتباط و اندازه گيري با 7880ADE

current amperes = IRMS * (0.00036565 / 100)

active watts = WATT * (0.0170276 / 10)
فاز A در توان اصلاح اضافي 1.02 داشت. اين ضرايب اكنون هنگام Init_App بارگذاري مي شوند. براي كامل بودن راه اندازي سه فاز، فاز C ً فعلا از مقادير فاز B استفاده مي كند و جريان نول از ضريب جريان فازها آغاز مي شود؛ بنابراين پس از نخستين نمونه موفق همه كانال ها خروجي مهندسي و پرچم اعتبار دارند. همه ضرايب آغازكار با DEFAULT_CALIBRATION_APP علامت گذاري مي شوند. اين پرچم فقط موفقيت تبديل را نشان مي دهد و تأييد دقت ضريب جايگزين موقت نيست. كد قديمي توان ظاهري را به واحد مهندسي تبديل نمي كرد. ديتاشيت 7880ADE و راهنماي -1171AN بيان مي كنند بهره توان هاي اكتيو و ظاهري هر فاز در تراشه با هم تطبيق داده شده است؛ ازاين رو مقدار اوليه VA هر فاز با ضريب توان همان فاز آغاز مي شود. وجود خانه مستقل [phase[power_apparent اجازه مي دهد بعداً بدون اثر روي توان اكتيو، همان كانال جداگانه كاليبره شود.

براي تشخيص منشأ هر خروجي، آرايه هاي source_voltage، source_current، source_power_active و
يعني APP_CALIBRATION_USER | مقدار .اند | مشاهده | قابل Watch در apparent_power_source
ضريب پيش فرض همان خانه با كاليبراسيون اندازه گيري شده جايگزين شده است.

## .۱۵ .۱۲ ۳ جهت CT، علامت توان و علامت ضريب توان

اگر جهت اوليه يا ثانويه CT برعكس شود، بردار جريان ۱۸۰ درجه تغيير مي كند. در نتيجه علامت توان اكتيو و PF علامت دار عوض مي شود، ولي جريان RMS، توان ظاهري و بزرگي PF نبايد تغيير كنند. براي نصب فقط مصرف كننده، جهت درست جهتي است كه در هنگام روشن بودن بار، توان اكتيو مثبت باشد. اگر روي CT علامت وجود دارد، معمولاً K1/P سمت منبع، L2/P سمت بار، k1/S سمت ورودي جريان مثبت و l2/S سمت ورودي منفي قرار مي گيرد؛ نام نهايي پايه ها حتماً بايد با شماتيك همان برد و ديتاشيت سازنده CT تطبيق داده شود.
علامت PF را نبايد براي انتخاب جهت CT به تنهايي استفاده كرد. طبق قرارداد 7880ADE، علامت اين رجيستر اطلاعات پيش فاز/پس فاز را نيز حمل مي كند. بنابراين يك لامپ LED با ورودي يكسوساز و خازن مي تواند با وجود توان مصرفي مثبت، PF علامت دار منفي داشته باشد. فيلد factor_power علامت را حفظ مي كند و فيلد جديد abs_factor_power فقط بزرگي صفر تا يك را براي نمايش معمول ارائه مي دهد. اگر اصلاح فيزيكي جهت ممكن نباشد، پس از Init_App يك بار تنظيم زير انجام مي شود:
۱ | (void)App_SetCurrentPolarity(
۲ | ADE7880_PHASE_A,
۳ | APP_CURRENT_POLARITY_REVERSED);

سامانه پايش و كنترل اتاق آزمون فصل .۱۵ راه اندازي ارتباط و اندازه گيري با 7880ADE

اين تنظيم علامت توان اكتيو و PF علامت دار را اصلاح مي كند؛ جريان RMS، توان ظاهري و قدرمطلق ضريب توان بدون تغيير مي مانند. تشخيص و وارونه سازي خودكار در هر نمونه انجام نمي شود، زيرا در يك سامانه دوطرفه توان منفي مي تواند صادرات واقعي باشد. مقدار انتخاب شده در آرايه polarity_current قابل مشاهده است و بايد يك بار هنگام راه اندازي هر فاز تعيين شود. هشدار ايمني: ثانويه CT در حالي كه جريان از اوليه عبور مي كند هرگز باز نشود؛ امكان ايجاد ولتاژ خطرناك وجود دارد. تغيير سيم بندي فقط پس از بي برق كردن اوليه يا با روش اتصال كوتاه ايمن مورد تأييد سازنده انجام شود.

## .۱۵ .۱۲ ۴ واحد مهندسي و نمايش سازگار با برنامه قديمي

براي جلوگيري از ابهام، فيلدهاي محاسباتي هميشه واحد مهندسي صريح دارند:

آمپر؛ :current_a ◦

وات؛ :active_power_w ◦

.آمپر ولت :apparent_power_va ◦

سه فيلد مستقل زير فقط براي نمايش و پروتكل هاي point-fixed در نظر گرفته شده اند:

- display_current: پيش فرض صدم آمپر؛ بنابراين A 0.17 به شكل 17 ديده مي شود؛
- display_power_active: پيش فرض دهم وات؛ بنابراين W 23.1 به شكل 231 ديده مي شود؛
- display_power_apparent: پيش فرض دهم ولت آمپر.

دو ثابت زير در h.app پيش فرض را مشخص مي كنند؛ مقدارهاي آن ها به ترتيب ۱۰۰ و ۱۰ هستند:

۱ | APP_DEFAULT_CURRENT_DISPLAY_UNITS_PER_AMP
۲ | APP_DEFAULT_POWER_DISPLAY_UNITS_PER_WATT

تغيير موقت در زمان اجرا نيز بدون دست زدن به كاليبراسيون ممكن است:

۱ | /* Make optional display fields use direct A and W units. */
۲ | (void)App_SetDisplayUnits(1.0F, 1.0F);

سامانه پايش و كنترل اتاق آزمون فصل .۱۵ راه اندازي ارتباط و اندازه گيري با 7880ADE

## .۱۵ .۱۲ ۵ جدول واحد ضرايب پيش فرض هر سه فاز

همه ضرايب آغازكار برد در يك متغير ثابت و خوانا به نام calibration_default در ابتداي فايل c.app قرار گرفته اند. ساختار هر خانه دقيقاً {offset ,scale {و رابطه تبديل براي همه كميت ها يكسان است:

engineering = raw * scale + offset

كميت كانال scale پيش فرض offset

ولتاژ RMS A 1.017 * 0.00055963 صفر

ولتاژ RMS B 0.00055963 صفر
ولتاژ RMS C ،0.00055963 موقتاً كپي B صفر
صفر | 0.00036565 / 100 | A/B/C | RMS | جريان

توان اكتيو A 1.02) * 10 / 0.0170276 (صفر

توان اكتيو C/B 10 / 0.0170276 صفر
برابر ضريب اوليه توان اكتيو همان صفر
فاز
A/B/C | ظاهري | توان

100 / ،0.00036565 موقتاً كپي صفر
جريان فاز

جريان نول N

اين جدول عمداً تك تك كانال ها را نشان مي دهد تا تغيير يك فاز به تغيير ناخواسته فاز ديگر منجر نشود. با وجود برابر بودن بعضي مقدارهاي اوليه، هر خانه حافظه مستقل خود را دارد. تابع Init_App جدول را با
ResetCalibrationToDefaults_App بارگذاري مي كند. هر فراخواني SetPhaseCalibration_App يا CalibratePhaseMultiPoint_App فقط خانه انتخاب شده را با منبع USER_CALIBRATION_APP
جايگزين مي كند. فراخواني مجدد بازنشاني نرم افزاري كاليبراسيون، تمام ضرايب زمان اجراي حافظه را حذف مي كند:
۱ | /* Discard runtime coefficients and restore the full startup table. */
۲ | App_ResetCalibrationToDefaults();

وجود ضريب جايگزين موقت براي فاز استفاده نشده هيچ ورودي را فعال يا خطر الكتريكي ايجاد نمي كند؛ فقط اگر بعداً سيگنال به آن فاز وصل شد، برنامه بلافاصله مقدار تقريبي منتشر مي كند. پيش از اتكا، همان فاز مستقل

سامانه پايش و كنترل اتاق آزمون فصل .۱۵ راه اندازي ارتباط و اندازه گيري با 7880ADE

با مرجع كاليبره مي شود.

## .۱۵ .۱۲ ۶ استفاده تك فاز، دو كانال مستقل و سه فاز

انديس و رابط برنامه نويسي در هر سه حالت ثابت اند. محصول تك فاز مي تواند فقط خانه A_PHASE_7880ADE را مصرف كند. دو مصرف كننده مستقل مي توانند از A و B استفاده كنند و كاليبراسيون هركدام جدا باشد. دستگاه سه فاز هر سه خانه C/B/A را پردازش مي كند. نمونه تنظيم مستقل دو كانال:

۱ | ADE7880_LinearCalibration current_a = {SCALE_A, OFFSET_A};
۲ | ADE7880_LinearCalibration current_b = {SCALE_B, OFFSET_B};

۳
۴ | (void)App_SetPhaseCalibration(APP_PHASE_QUANTITY_CURRENT_RMS,
۵ | ADE7880_PHASE_A, &current_a);
۶ | (void)App_SetPhaseCalibration(APP_PHASE_QUANTITY_CURRENT_RMS,
۷ | ADE7880_PHASE_B, &current_b);
۸ | /* Phase C keeps its startup default until explicitly replaced. */

در سطح كتابخانه قابل حمل نيز ReadPhase_7880ADE براي خواندن انتخابي يك فاز و ReadAll_7880ADE براي نمونه اتميك C/B/A و نول موجود است. درايور هيچ نمونه سراسري از تراشه ندارد؛ بنابراين پروژه ديگر مي تواند براي بيش از يك 7880ADE، يك Device_7880ADE مستقل با رابط انتقال مستقل بسازد.

## .۱۵ .۱۲ ۷ تصميم كاليبراسيون: يك خط چندنقطه اي، نه ضرايب قطعه اي

مسير اندازه گيري 7880ADE ذاتاً خطي طراحي شده است. قرار دادن يك ضريب براي بار كم و ضريب ديگر براي بار زياد مي تواند در مرز دو بازه پرش بسازد و عيب واقعي offset، نويز يا خطاي فاز را پنهان كند. روش نخست اين پروژه يك رابطه offset + scale * raw = engineering است كه با كمترين مربعات روي همه نقاط ثبت شده برازش مي شود. حداقل دو نقطه لازم است، سه نقطه براي كم/مياني/زياد حداقل عملي و پنج نقطه براي ارزيابي بهتر خطي بودن توصيه مي شود. راهنماي رسمي -1171AN حداكثر سه مرحله متفاوت را معرفي مي كند: gain، phase و offset. اين عبارت به معني سه ضريب قطعه اي نيست. gain براي هر دستگاه لازم است؛ اصلاح فاز براي CT، به خصوص در ضريب توان پايين، اغلب لازم است؛ و offset وقتي دقت زياد در دامنه ديناميكي وسيع خواسته شود اهميت پيدا مي كند. اگر پس از برازش خطي، خطاي كم بار همچنان سيستماتيك باشد، بايد رجيسترهاي
xWATTOS/xVRMSOS/xIRMSOS تراشه ارزيابي شوند.

سامانه پايش و كنترل اتاق آزمون فصل .۱۵ راه اندازي ارتباط و اندازه گيري با 7880ADE

## .۱۵ .۱۲ ۸ انتخاب نقاط و برداشت داده

در هر نقطه، پس از زمان نشست، دست كم ۲۰ تا ۶۰ نمونه خام ثبت و ميانگين شوند. ابزار مرجع بايد هم زمان خوانده شود. صفر كامل براي كاليبراسيون RMS مناسب نيست؛ راهنماي تراشه نيز offset را با يك سيگنال كم ولي غيرصفر اندازه مي گيرد.

كميت نقاط پيشنهادي
پايين، نامي و بالاي بازه واقعي؛ براي شبكه ۲۳۰ ولت، در صورت
ً | پشتيباني منبع مثلا ،۱۸۰ ۲۳۰ و ۲۵۰ ولت.

ولتاژ RMS

كمترين جريان موردنيازِ معتبر، يك نقطه مياني و ۸۰ تا ۱۰۰ درصد جريان نامي طراحي؛ از حد مجاز ADE/burden/CT عبور نشود.

جريان RMS

بارهاي مرجع كم، مياني و زياد با ولتاژ پايدار و PF معلوم؛ براي gain ساده، بار مقاومتي نزديك 1=PF.

توان اكتيو

هم زمان از ولتاژ و جريان مرجع يا پاورآنالايزر معتبر ثبت شود؛ صرف
حاصل ضرب مقادير نامطمئن استفاده نشود.

توان ظاهري

براي بررسي خطاي فاز CT يك آزمون جدا با بار پايدار نزديك 0.5=PF لازم است. نقاط برازش بهتر است كل بازه كاري را بپوشانند، ولي يك يا دو نقطه اضافي بايد فقط براي اعتبارسنجي نگه داشته شوند و وارد برازش نشوند.

## .۱۵ .۱۲ ۹ كد كاليبراسيون ولتاژ، جريان و توان

در نمونه زير نام هاي ..._raw ميانگين شمارهاي ثبت شده از [0]phase.raw.electrical_app_g هستند و اعداد ستون دوم مقدار هم زمان ابزار مرجع در واحد مهندسي هستند:

سامانه پايش و كنترل اتاق آزمون فصل .۱۵ راه اندازي ارتباط و اندازه گيري با 7880ADE

const ADE7880_CalibrationPoint voltage_points[] = {
{raw_v_180, 180.0F}, {raw_v_230, 230.0F}, {raw_v_250, 250.0F}
};
const ADE7880_CalibrationPoint current_points[] = { {raw_i_0_10, 0.10F}, {raw_i_1_00, 1.00F}, {raw_i_5_00, 5.00F}
};
const ADE7880_CalibrationPoint power_points[] = { {raw_p_20, 20.0F}, {raw_p_200, 200.0F}, {raw_p_1000, 1000.0F}

};
ADE7880_LinearCalibration voltage_result; ADE7880_LinearCalibration current_result; ADE7880_LinearCalibration power_result; float voltage_max_error_v;
float current_max_error_a;
float power_max_error_w;

(void)App_CalibratePhaseMultiPoint( APP_PHASE_QUANTITY_VOLTAGE_RMS, ADE7880_PHASE_A, voltage_points, 3U, &voltage_result, &voltage_max_error_v); (void)App_CalibratePhaseMultiPoint( APP_PHASE_QUANTITY_CURRENT_RMS, ADE7880_PHASE_A, current_points, 3U, &current_result, &current_max_error_a); (void)App_CalibratePhaseMultiPoint( APP_PHASE_QUANTITY_ACTIVE_POWER, ADE7880_PHASE_A,
power_points, 3U, &power_result, &power_max_error_w);

سه مقدار error_max بيشترين فاصله نقاط ورودي از خط برازش شده را به ترتيب برحسب ولت، آمپر و وات نشان مي دهند. كوچك بودن آن ها كافي نيست؛ خروجي بايد در نقاط مستقل نيز با مرجع مقايسه شود. براي CT معكوس، مقدار مرجع همچنان خروجي نهايي مطلوب است و تابع كاربردي علامت ضريب توان اكتيو را با تنظيم polarity_current هماهنگ مي كند. نتيجه نصب شده تا reset در RAM است. پس از تأييد، اعضاي offset/scale ساختارهاي نتيجه در Watch

سامانه پايش و كنترل اتاق آزمون فصل .۱۵ راه اندازي ارتباط و اندازه گيري با 7880ADE

يادداشت و در Flash يا تنظيمات startup ذخيره شوند. نمونه بارگذاري ثابت تأييدشده:

۱ | static const ADE7880_LinearCalibration saved_power_a = {
۲ | .scale = VERIFIED_POWER_A_SCALE,
۳ | .offset = VERIFIED_POWER_A_OFFSET
۴ | };

۵
۶ | (void)App_SetPhaseCalibration(
۷ | APP_PHASE_QUANTITY_ACTIVE_POWER,
۸ | ADE7880_PHASE_A, &saved_power_a);

جريان نول نيز مسير چندنقطه اي همسان و مستقل دارد:

۱ | const ADE7880_CalibrationPoint neutral_points[] = {
۲ | {raw_n_0_10, 0.10F},
۳ | {raw_n_1_00, 1.00F},
۴ | {raw_n_5_00, 5.00F}
۵ | };
۶ | ADE7880_LinearCalibration neutral_result;

۷
۸ | (void)App_CalibrateNeutralCurrentMultiPoint(
۹ | neutral_points, 3U, &neutral_result, NULL);

توان نوشته شده روي بدنه لامپ فقط مقدار نامي است و جاي وات متر يا منبع كاليبره را نمي گيرد. ترتيب حرفه اي پيشنهادي اين است: جهت CT، بررسي فاز، كاليبراسيون gain چندنقطه اي، ارزيابي نقطه هاي مستقل، و فقط در صورت باقي ماندن خطاي كم بار، اصلاح offset خود تراشه.

## .۱۵ ۱۳ آزمون سخت افزاري مرحله به مرحله

به علت اتصال ورودي هاي 7880ADE به برق شهر، اين آزمون فقط با ايزولاسيون مناسب، منبع محدودشده و فرد آگاه به ايمني برق انجام شود. اتصال مستقيم اسيلوسكوپ يا ديباگر زمين شده به بخش غيرايزوله مي تواند خطرناك و مخرب باشد.

## .۱۵ .۱۳ ۱ آزمون بدون اعمال ولتاژ اندازه گيري

.۱ بارهاي رله و ورودي هاي قدرت را ايمن يا جدا كنيد.

سامانه پايش و كنترل اتاق آزمون فصل .۱۵ راه اندازي ارتباط و اندازه گيري با 7880ADE

.۲ اتصال 13PA=SWDIO، 14PA=SWCLK، زمين مشترك و مرجع .۳ ۳ ولت Link-J را برقرار كنيد. .۳ برنامه را بسازيد، پروگرام و reset كنيد. .۴ اگر 7880ADE پاسخ دهد، LEDها بايد الگوي رقص تقريباً يك ثانيه اي داشته باشند. .۵ اگر ارتباط برقرار نشود، دو LED بايد سريع يكي درميان شوند و errors_communication پس از تلاش هاي خواندن افزايش يابد. .۶ با analyzer logic كنترل كنيد CS در هر تراكنش پايين، SCLK در بي كاري بالا و نرخ آن تقريباً .۵۶۲ ۵ كيلوهرتز باشد.
.۷ فرمان خواندن بايد با 01x0 و فرمان نوشتن با 00x0 آغاز شود و سپس نشاني ۱۶بيتي first-MSB بيايد.

## .۱۵ .۱۳ ۲ آزمون با منبع مرجع

.۱ ابتدا ولتاژ كم و ايمن مطابق طراحي ورودي اعمال كنيد و تغيير رجيستر متناظر را ببينيد. .۲ فقط پس از تأييد سيم بندي، منبع AC مرجع و بار كنترل شده وصل شود. .۳ فازهاي A، B و C جداگانه تغيير داده شوند تا نگاشت هر سه كانال قطعي شود. .۴ علامت توان اكتيو با جهت توان كنترل شود؛ براي بار مصرفي بايد مثبت باشد. اگر اصلاح فيزيكي ممكن
نيست، SetCurrentPolarity_App يك بار تنظيم شود.
.۵ ضريب توان يك بار مقاومتي بايد به مثبت يك نزديك باشد. براي بار غيرخطي، abs_factor_power بزرگي و factor_power اطلاعات علامت پيش فاز/پس فاز را نشان مي دهد. .۶ قطع موقت سيم SPI يا تغذيه ADE بايد حالت خطا ايجاد كند و پس از رفع عيب، تلاش دوره اي بايد ارتباط را بازيابي كند.
.۷ آزمون پيوسته حداقل ۲۴ ساعت براي شمار خطا، پايداري snapshot و الگوي LED انجام شود؛ آزمون چندروزه و چرخه دما براي ادعاي صنعتي لازم است.

## .۱۵ ۱۴ راهنماي عيب يابي

سامانه پايش و كنترل اتاق آزمون فصل .۱۵ راه اندازي ارتباط و اندازه گيري با 7880ADE

نشانه بررسي پيشنهادي
تغذيه و كلاك كريستال ADE، اتصال 1PM0/PM، سطح
RESET، چهار خط SPI، سطح CS و مشترك بودن زمين بررسي شود.

LED خطا از ابتداي روشن شدن

مسير MISO باز، CS غيرفعال، تراشه بي تغذيه يا رابط هنوز روي C2I است.

تمام خواندن ها xFFFFFFFF0

كلاك و ورودي ها، RUN، اتصال كوتاه MISO يا reset دائمي بررسي شود.

تمام خواندن ها صفر

طول سيم، نويز، زمين، تغذيه، خازن هاي باي پس و شكل موج
.شود | بررسي logic analyzer با SCLK/CS

خطاي متناوب

ابتدا داده raw را كنترل و سپس نسبت ورودي و ضرايب كاليبراسيون را اصلاح كنيد.

PF درست ولي ولت/آمپر نادرست

جهت CT را در حالت بي برق با علامت هاي سازنده و شماتيك تطبيق دهيد يا جبران نرم افزاري REVERSED را يك بار اعمال كنيد.

توان مصرفي منفي است

الزاماً خطا نيست؛ PF علامت دار 7880ADE پيش فاز/پس فاز را مشخص مي كند. بزرگي را از abs_factor_power بخوانيد و با پاورآنالايزر مرجع مقايسه كنيد.

توان مثبت ولي PF منفي است

فعال بودن ماژول DMA در تنظيمات HAL و عضويت سورس آن در پروژه بررسي شود.

ناشناخته بودن نوع DMA در Keil

عضويت فايل هاي برنامه و كتابخانه، مسيرهاي include و تعريف CS_ADE بررسي شود.

پس از CubeMX كد كامپايل نمي شود

در همين خطا وجود فراخواني (2hspi(&Init_App در بلوك كاربر فايل اصلي نيز كنترل شود.

## .۱۵ ۱۵ نتيجه اعتبارسنجي نرم افزاري اين مرحله

ساخت تازه با 20.0.0 32ststm PlatformIO و 1.8.7 1cubef32stm-framework با گزينه هاي - Wall-
Werror- Wextra موفق شد. خروجي ۱۰۳۷۲ بايت Flash و ۵۴۴ بايت RAM مصرف كرد. ساخت دوم با

سامانه پايش و كنترل اتاق آزمون فصل .۱۵ راه اندازي ارتباط و اندازه گيري با 7880ADE

Keil و 6.24 Compiler Arm نيز با (s(Warning 0 ,)s(Error 0 پايان يافت و اندازه هاي 9848=Code،
580=data-RO، 12=data-RW و 1532=data-ZI بايت را گزارش كرد. فايل هاي اجرايي هر دو زنجيره ابزار توليد شدند. جدول پيش فرض C/B/A و نول، بازنشاني ضرايب و كاليبراسيون چندنقطه اي نول در هر دو زنجيره ابزار ساخته شدند. در مميزي نهايي، تغيير ضريب يا جهت ترانس جريان نيز اصلاح شد تا مقدار مهندسي و نمايش قديمي همان لحظه پاك شوند و ديباگر تا نمونه بعدي داده كهنه نشان ندهد. كاربر پيش تر برقراري ارتباط، ديباگ Keil، مشاهده ولتاژ و پاسخ جريان/توان يك بار لامپي روي برد واقعي را گزارش كرده است. دقت ضرايب جايگزين موقت فاز C و نول و دقت نهايي همه كانال ها هنوز بايد با ابزار مرجع و نقاط مستقل روي برد كنترل شود.

## .۱۵ ۱۶ چك ليست پذيرش اين قابليت

اين مرحله زماني از نظر سخت افزاري پذيرفته مي شود كه همه موارد زير ثبت شوند:

- build بدون warning در PlatformIO و Keil؛
- توليد مجدد CubeMX و باقي ماندن منطق Library/Application؛
- مشاهده كلاك، CS و قالب فرمان صحيح با analyzer logic؛
- true=online و افزايش پيوسته شمار نمونه؛
- عدم افزايش خطاي ارتباط در آزمون طولاني؛
- صحت نگاشت فازهاي A، B و C و كانال نول؛
- كاليبراسيون هر كانال با مرجع معتبر و ثبت ضرايب؛
- بازيابي خودكار پس از قطع و وصل كنترل شده ارتباط يا تغذيه؛
- ثبت نتيجه، تاريخ، نسخه commit و تجهيزات آزمون در پرونده پروژه.

# فصل ۱۶ زيرسامانه 20B18DS با شماره گذاري پايدار

## .۱۶ ۱ نيازمندي و مسئله ترتيب

هر حسگر 20B18DS يك شناسه يكتاي ۶۴ بيتي دارد. دستور ROM Search همه شناسه هاي متصل را پيدا مي كند، اما ترتيب جست وجو همان شماره اي نيست كه روي بدنه حسگر نوشته شده است. اضافه شدن، حذف يا تعويض يك شناسه مي تواند ترتيب كشف را تغيير دهد. بنابراين مرتب سازي نتيجه جست وجو به تنهايي براي حفظ معناي «سنسور ۱»، «سنسور ۲» و مانند آن كافي نيست. راه حل اين نسخه جداسازي هويت فيزيكي از شماره منطقي است. برنامه براي هر شماره يك زوج «شماره گذرگاه و ROM «در Flash ذخيره مي كند. در نتيجه خاموشي برد ترتيب را عوض نمي كند و نتيجه هر جست وجوي تازه فقط حضور يا غيبت همان هويت هاي ذخيره شده را تعيين مي كند.

شماره كاربردي گذرگاه هويت ذخيره شده ۱ صفر، 10PB ROM يكتاي حسگر برچسب ۱ ۲ يك، 7PC ROM يكتاي حسگر برچسب ۲ ۳ تا ۳۲ صفر يا يك در صورت معرفي كاربر

ظرفيت نرم افزار ۳۲ شماره و چهار گذرگاه قابل پيكربندي است؛ كاربرد فعلي دو گذرگاه دارد و لازم نيست همه جايگاه ها پر شوند.

سامانه پايش و كنترل اتاق آزمون فصل .۱۶ زيرسامانه 20B18DS با شماره گذاري پايدار

## .۱۶ ۲ اتصال الكتريكي و فرض هاي اين نسخه

گذرگاه صفر به 10PB و گذرگاه يك به 7PC متصل است. فايل ioc107.F32STM هر دو را خروجي -open drain با سطح اوليه آزاد ثبت مي كند. اتصال پشتيباني شده سه سيمه است: VDD به تغذيه مجاز سنسور، GND به زمين مشترك و DQ به پايه گذرگاه. هر گذرگاه بايد بالاكش خارجي به ولتاژ منطقي داشته باشد. مقدار متداول .۴ ۷ كيلواهم نقطه شروع است، نه تضمين براي هر طول كابل و تعداد حسگر؛ كيفيت لبه ها بايد روي سخت افزار نهايي ديده شود.
حالت تغذيه انگلي يا power parasite به كليد up-pull strong نياز دارد و در adapter فعلي پشتيباني نشده است. نرم افزار بر تغذيه خارجي تكيه مي كند. كابل بلند، توپولوژي ستاره اي، زمين نامناسب و نويز رله ها مي توانند خطاي CRC بسازند؛ موفقيت كامپايل جاي مشاهده شكل موج و آزمون كابل واقعي را نمي گيرد.

## .۱۶ ۳ معماري قابل انتقال

زيرسامانه به چهار مرز روشن تقسيم شده است:

.۱ OneWire/Libraries هيچ هدر HAL ندارد. عمليات خط، تأخير ميكروثانيه و ورود يا خروج از ناحيه بحراني را از callback مي گيرد و reset، خواندن و نوشتن بيت و بايت، 8CRC و الگوريتم Search ROM را پياده مي كند.

،Convert T ،Skip ROM ،Match ROM | شامل 0x28 | خانواده | هاي | فرمان Libraries/DS18B20 .۲
خواندن و نوشتن scratchpad، وضوح ۹ تا ۱۲ بيت و تبديل مقدار علامت دار را فراهم مي كند. .۳ Manager20B18DS/Libraries زمان، ذخيره سازي و آرايه گذرگاه ها را از پيكربندي دريافت مي كند. اين لايه كشف، نگاشت پايدار، تعويض كنترل شده و ماشين حالت خواندن را اداره مي كند و تخصيص حافظه پويا ندارد. رفتار امن «ثبت تازه» و «تعويض بدون ابهام» پيش فرض ثابت مدير است و ديگر دو پرچم پيكربندي جدا ندارد.
،Cortex-M3 | سيكل | شمارنده | ،PC7 و PB10 .است | حاضر | برد مرز Application/Src/app.c .۴
GetTick_HAL و ذخيره ساز Flash فقط در اين فايل به لايه هاي قابل حمل وصل مي شوند. نمونه
مدير خصوصي است و هدر ساده برنامه فقط داده قابل مصرف را نشان مي دهد.

براي انتقال كتابخانه به ميكروكنترلر ديگر، سه لايه نخست تغيير نمي كنند. توسعه دهنده عمليات خط، تأخير ميكروثانيه و حفاظت كوتاه زمان بندي را پياده مي كند. callbackهاي ذخيره سازي را مي توان به EEPROM، FRAM يا Flash مقصد متصل كرد.

سامانه پايش و كنترل اتاق آزمون فصل .۱۶ زيرسامانه 20B18DS با شماره گذاري پايدار

## .۱۶ ۴ جست وجو و تضمين صحت داده

الگوريتم جست وجو اختلاف بيت ها را طبق پروتكل Wire1- دنبال مي كند و حالت جست وجو براي هر گذرگاه مستقل است. فقط ROMهايي پذيرفته مي شوند كه بايت خانواده آن ها 28x0 و 8CRC هفت بايت اول با بايت هشتم يكسان باشد. فهرست كشف شده براي نمايش قطعي ابتدا با شماره گذرگاه و سپس بايت هاي ROM مرتب مي شود؛ با اين حال اين مرتب سازي هرگز جاي جدول شماره منطقي را نمي گيرد. در خواندن دما، نه بايت scratchpad دريافت و 8CRC هشت بايت اول با بايت نهم مقايسه مي شود. دو بايت دما به يك عدد علامت دار ۱۶ بيتي با واحد يك شانزدهم درجه سلسيوس تبديل مي شوند؛ بنابراين دماهاي زير صفر نيز درست مي مانند. خروجي سلسيوس فقط پس از CRC صحيح و كنترل بازه منفي ۵۵ تا مثبت ۱۲۵ درجه معتبر اعلام مي شود.

## .۱۶ ۵ ماشين حالت و زمان بندي

مدير از سه حالت IDLE، CONVERTING و READING استفاده مي كند. در زمان نمونه برداري، روي هر گذرگاه يك T Convert سراسري اجرا مي شود تا همه سنسورها هم زمان تبديل را آغاز كنند. برنامه براي وضوح نامعلوم يا ۱۲ بيت، ۷۵۰ ميلي ثانيه تا موعد تبديل صبر مي كند، ولي اين انتظار با مقايسه زمان در Process_App است و حلقه اصلي متوقف نمي شود. سپس در هر اجراي حلقه حداكثر يك جايگاه آدرس دار خوانده مي شود. تابع ManagerProcess_20B18DS فقط زماني true برمي گرداند كه كشف يا وضعيت يك جايگاه تغيير كرده باشد. در نتيجه adapter آرايه هاي عمومي را فقط هنگام داده تازه بازنويسي مي كند؛ پيمايش ۳۲ جايگاه در هر دور بي تغيير حلقه حذف شده است. slotهاي خود پروتكل در مقياس ميكروثانيه اند و براي جلوگيري از شكسته شدن زمان بندي، callback ناحيه بحراني وضعيت وقفه را حفظ و بازيابي مي كند. اين حفاظت كوتاه با انتظار ۷۵۰ ميلي ثانيه اي تفاوت دارد. جست وجوي نخست بلافاصله و جست وجوهاي بعدي هر پنج ثانيه اجرا مي شوند؛ در محصولي با محدوديت latency سخت گيرانه تر بايد بودجه زماني آن اندازه گيري شود.

## .۱۶ ۶ ذخيره نگاشت در Flash

آخرين صفحه دو كيلوبايتي Flash از آدرس 800F0803x0 براي داده رزرو شده و linker تا پيش از آن كد را قرار مي دهد. ركورد نسخه ۲ شامل magic، نسخه، اندازه payload، آرايه نگاشت و 32CRC است. بارگذاري فقط هنگامي موفق است كه همه اين فيلدها سازگار باشند. ROM نامعتبر، شماره گذرگاه خارج از محدوده و

سامانه پايش و كنترل اتاق آزمون فصل .۱۶ زيرسامانه 20B18DS با شماره گذاري پايدار

نگاشت تكراري هنگام راه اندازي رد مي شوند. ثبت خودكار نخستين حضور، تعويض صريح يا پاك كردن شماره يك program/erase انجام مي دهد. اين نوشتن فقط هنگام تغيير جدول است و در نمونه برداري عادي تكرار نمي شود. نوشتن در Flash داخل وقفه انجام نمي شود.
پس از برنامه ريزي، ركورد با حافظه مقايسه مي شود و در شكست، وضعيت RAM به نسخه قبلي برمي گردد. براي تحمل قطع تغذيه هنگام نوشتن، دو اسلات journal شده يا حافظه غير فرار جداگانه گام مقاوم سازي بعدي است.
فرمت قديمي فقط ROMها را داشت و شماره گذرگاه را ذخيره نمي كرد. تابع خواندن آن براي مهاجرت دستي باقي مانده، اما مهاجرت خودكار انجام نمي شود؛ نسبت دادن همه شناسه هاي قديمي به يك گذرگاه مي تواند نگاشت نادرست و پنهان بسازد.

## .۱۶ ۷ معرفي اوليه سنسورها

استفاده عادي هيچ فراخواني دستي ندارد. برنامه در نخستين جست وجو هر ROM تازه را به اولين شماره خالي متصل، نگاشت را ذخيره و تبديل دما را آغاز مي كند. براي يك حسگر كافي است آن را وصل و برد را روشن كرد؛
دما پس از حدود يك ثانيه در [0]c_temperature_g ظاهر و [0]valid_temperature_g درست مي شود.
براي تطبيق شماره هاي نرم افزاري با برچسب روي بدنه، حسگرها يك به يك و به ترتيب متصل شوند:

.۱ فقط حسگر داراي برچسب ۱ به گذرگاه موردنظر وصل شود. .۲ تا درست شدن [0]valid_temperature_g صبر شود؛ تابعي از ديباگر صدا زده نمي شود. .۳ حسگر برچسب ۲ وصل و تا درست شدن [1]valid_temperature_g صبر شود. .۴ همين روند براي تعداد موردنياز تكرار شود. count_sensor_temperature_g تعداد هويت هاي ذخيره شده را نشان مي دهد.

اگر همه حسگرها در نخستين بوت هم زمان حاضر باشند، شماره ها با ترتيب قطعي «شماره گذرگاه، سپس ROM «تخصيص مي يابند. اين ترتيب پس از ذخيره ثابت است، ولي الزاماً با نوشته روي بدنه يكي نيست؛ پروتكل اطلاعاتي درباره برچسب انساني ندارد. APIهاي تخصيص صريح فقط براي ابزار توليد و تعمير پيشرفته باقي مانده اند.

سامانه پايش و كنترل اتاق آزمون فصل .۱۶ زيرسامانه 20B18DS با شماره گذاري پايدار

## .۱۶ ۸ تعويض سنسور و مرز تصميم خودكار

سنسور جايگزين ROM تازه دارد و پروتكل راهي براي فهميدن برچسب فيزيكي آن ارائه نمي كند. تعويض خودكار فقط وقتي امن است كه روي يك گذرگاه دقيقاً يك نگاشت ذخيره شده غايب و دقيقاً يك ROM جديد حاضر باشد.
در آن حالت ROM جديد در همان شماره نوشته و شمارنده replacements_automatic زياد مي شود. اگر دو حسگر غايب يا دو حسگر تازه حاضر باشند، مسئله از ديد نرم افزار مبهم است. مدير عمداً هيچ حدسي نمي زند. در مسير عادي سنسورها بايد يكي يكي و در وضعيت يك غايب/يك تازه تعويض شوند. ابزار سرويس مي تواند مستقيماً از ManagerAssignDiscovered_20B18DS استفاده كند، اما اين API پيشرفته عمداًدر هدر ساده برنامه منتشر نشده است. اين رفتار از جابه جايي خاموش نقش هاي كنترلي جلوگيري مي كند.

## .۱۶ ۹ مشاهده در ديباگر

براي شماره N مسير ساده دما چنين است:

1 g_temperature_c[N - 1]

اعتبار مقدار از مسير زير ديده مي شود:

1 g_temperature_valid[N - 1]

تابع TemperatureGetCelsius_App نيز همين كنترل را انجام مي دهد و فقط براي نمونه معتبر true برمي گرداند. اين تنها تابع عمومي لايه كاربرد است. ساختار مدير خصوصي شده تا برنامه عادي به ROM، گذرگاه، وضعيت داخلي يا APIهاي تعميراتي وابسته نشود. براي پروژه اي با دقيقاً يك سنسور و جايي كه توقف كوتاه پذيرفتني است، حتي مدير لازم نيست. پس از مقداردهي

Bus_OneWire مي توان تابع ReadTemperatureBlocking_20B18DS را با NULL=ROM و مهلت
۷۵۰ ميلي ثانيه فراخواني كرد. براي چند سنسور، شماره پايدار يا اجراي غيرمسدودكننده، مدير انتخاب درست است.

## .۱۶ ۱۰ حفاظت در برابر توليد مجدد CubeMX

تنظيم پايه ها در فايل IOC ذخيره شده و منطق در Application و Libraries بيرون فايل هاي مولد قرار دارد. فايل مولد فقط در بلوك هاي CODE USER توابع Init_App و Process_App را فراخواني مي كند. پس از

سامانه پايش و كنترل اتاق آزمون فصل .۱۶ زيرسامانه 20B18DS با شماره گذاري پايدار

هر Code Generate بايد diff گيت، حالت تخليه باز 7PC10/PB، فراخواني هاي CODE USER، مسيرهاي include و عضويت سورس مدير در پروژه Keil بررسي شوند. PlatformIO همه سورس هاي كتابخانه را با الگوي پوشه ها مي سازد و مسير include جديد در .platformio ini ثبت شده است. فايل uvprojx107.F32STM نيز سورس مدير و مسير هدر آن را دارد. اين همگام سازي باعث مي شود يك كد C در هر دو زنجيره ساخت استفاده شود، نه دو نسخه جدا.

## .۱۶ ۱۱ چك ليست آزمون روي برد

.۱ ابتدا يك حسگر روي هر گذرگاه، سپس تعداد واقعي سنسورها آزمايش شود؛ شكل موج reset، presence و slot در دورترين نقطه كابل ديده شود.
.۲ ROM، شماره گذرگاه، CRC، دماي مثبت و منفي و مقايسه با دماسنج مرجع ثبت شود. .۳ پس از معرفي شماره ها، خاموشي كامل و روشن شدن دوباره انجام و ثبات slots تأييد شود. .۴ يك حسگر قطع و دوباره وصل شود؛ پرچم هاي valid/present و شمارنده خطا بررسي شوند. .۵ سناريوي يك خراب و يك تازه روي همان گذرگاه، سپس سناريوي مبهم دو خراب و دو تازه آزموده شود. اولي بايد خودكار و دومي فقط صريح جايگزين شود. .۶ نويز رله، طول كابل نهايي، دماي ۸۵ درجه تكراري، خطاي CRC، قطع تغذيه هنگام ذخيره و اجراي پيوسته حداقل ۲۴ ساعت بررسي شود.
.۷ ساخت واقعي Keil و PlatformIO بعد از هر توليد مجدد CubeMX تكرار شود.

## .۱۶ ۱۲ محدوديت هاي اعلام شده

اعتبارسنجي فعلي شامل بررسي ديتاشيت، بازبيني كد و ساخت فريم ور است. هيچ نتيجه اي درباره كيفيت up-pull، كابل، نويز، دقت دما يا رفتار سنسور واقعي بدون آزمون برد ادعا نمي شود. همچنين دماها هنوز به قاب سريال قديمي يا منطق كنترل محصول متصل نشده اند؛ اين جداسازي عمدي است تا ابتدا هويت و خواندن سنسورها مستقل تأييد شود.

# فصل ۱۷ نمايشگر كاراكتري و كليدهاي منو

اين فصل مرحله اوليه آزمون شمارنده و كتابخانه نمايشگر را مستند مي كند. كتابخانه و سيم بندي همچنان استفاده مي شوند، اما تست صفر تا صد، صفركردن با كليد سوم و روش رخداد كليد زير، شرح تاريخي اند. در نسخه فعال، كليد سوم منوي سيكل را كنترل مي كند، نمونه برداري سطح و تكرار كليد در حلقه اصلي است و عملكرد نهايي در فصل ۱۸ آمده است.

## .۱۷ ۱ هدف و نتيجه اين مرحله

در اين مرحله نمايشگر ۱۶ ستون و ۲ سطر مدل ET-CFH-B002N-016LCD و سه كليد افزاينده، كاهنده و صفركننده به مسير اجرايي اضافه شدند. نمايشگر با گذرگاه چهار بيتي كار مي كند، هر فشار معتبر كليد دقيقاً يك رخداد مي سازد و مقدار روي بازه بسته صفر تا صد محدود مي شود. حلقه اصلي همچنان سنجش انرژي، دما و الگوي دو چراغ تشخيصي را سرويس مي كند. نمايش اوليه چنين است:

1 | Counter test
2 | Value: | 0 /100

فشار كليد اول يك واحد اضافه، كليد دوم يك واحد كم و كليد سوم مقدار را صفر مي كند. در صفر، كليد كاهنده اثري ندارد و در صد، كليد افزاينده اثري ندارد. فقط سه خانه عددي بازنويسي مي شوند؛ نمايشگر در هر تغيير پاك نمي شود و بنابراين چشمك ناشي از فرمان Display Clear وجود ندارد.

سامانه پايش و كنترل اتاق آزمون فصل .۱۷ نمايشگر كاراكتري و كليدهاي منو

## .۱۷ ۲ مبناي ديتاشيت و محدوديت الكتريكي مهم

ديتاشيت ۲۶ صفحه اي Vishay در pdf.bcfhet002n016lcd/datasheets بررسي شد. ماژول ۱۶ در ،۲ كنترلر 7066ST يا معادل، فونت ۵ در ۸ و تغذيه منطقي نامي ۵ ولت دارد. سطر نخست از آدرس DDRAM 00x0 و سطر دوم از 40x0 آغاز مي شود. زمان اجراي فرمان عادي حدود ۳۹ ميكروثانيه، نوشتن داده حدود ۴۳ ميكروثانيه و Home/Clear حدود ۱/۵۳ ميلي ثانيه است. درايور براي حاشيه امن به ترتيب ۵۰ و ۱۶۰۰ ميكروثانيه صبر مي كند و پالس E يك ميكروثانيه است كه از حداقل ۱۴۰ نانوثانيه بزرگ تر است.

هشدار: در تغذيه ۵ ولت، ديتاشيت حداقل سطح بالاي ورودي را VDD 0.7 يعني ۳/۵ ولت اعلام
مي كند. خروجي ۳/۳ ولتي 32STM اين شرط تضمين شده را برآورده نمي كند، هرچند ممكن است روي يك نمونه كار كند. براي محصول قابل اتكا بايد مبدل سطح مناسب روي 7DB4..DB/E/RS استفاده شود يا نسخه و شرايط تغذيه سازگار با منطق ۳/۳ ولت با ديتاشيت همان قطعه تأييد شود.

پايه W/R به 7PA و يك مقاومت پايين كش متصل است. نرم افزار اين پايه را خروجي پوش پول در سطح پايين نگه مي دارد و Flag Busy را نمي خواند. جهت 7DB4..DB هميشه خروجي مي ماند و احتمال درگيري خروجي ۵ ولتي LCD با GPIO ميكرو حذف مي شود. پايين كش خارجي نيز هنگام بازنشاني مانع شناورشدن W/R مي شود.

## .۱۷ ۳ جدول پايه ها و تنظيم CubeMX

سيگنال پايه 32STM حالت GPIO E 6PA خروجي پوش پول، سطح پايين اوليه W/R 7PA خروجي پوش پول، هميشه سطح پايين RS 8PA خروجي پوش پول 7DB4..DB 12PA9..PA چهار خروجي پوش پول افزايش 9EXTI / 9PD وقفه لبه بالارونده، بدون مقاومت داخلي كاهش 10EXTI / 10PD وقفه لبه بالارونده، بدون مقاومت داخلي صفركردن 11EXTI / 11PD وقفه لبه بالارونده، بدون مقاومت داخلي

كليدها در سخت افزار پايين كش خارجي دارند و با فشار به تغذيه مثبت وصل مي شوند؛ پس لبه بالارونده آغاز فشار

سامانه پايش و كنترل اتاق آزمون فصل .۱۷ نمايشگر كاراكتري و كليدهاي منو

است و NOPULL_GPIO انتخاب شده است. خطوط ۹ و ۱۰/۱۱ به ترتيب از بردارهاي مشترك 5_9EXTI و 10_15EXTI استفاده مي كنند. هر handler فقط تابع استاندارد HAL را براي پايه مربوط فراخواني مي كند. همه نام ها، حالت پايه ها و فعال بودن NVIC در ioc107.F32STM ثبت شده اند. 14PA13/PA براي SWD باقي مانده اند. 10PA9/PA ديگر براي 1USART آزاد نيستند؛ اگر در آينده 1USART لازم شود بايد LCD يا UART به پايه/واحد ديگري منتقل و IOC هم زمان اصلاح شود.

## .۱۷ ۴ معماري نرم افزار

كتابخانه قابل حمل در CharacterLcd/Libraries هيچ هدر 32STM يا HAL را وارد نمي كند. ساختار
Config_CharacterLcd پنج callback و هندسه نمايشگر را مي گيرد:
- rs_write: انتخاب فرمان يا داده؛
- rw_write: اختياري و در اين برد فقط براي نگه داشتن سطح پايين؛
- enable_write: ساخت پالس فعال سازي؛
- 4data_write: قراردادن نيم بايت روي 7DB4..DB؛
- us_delay: تأخير كوتاه مستقل از نوع ميكروكنترلر.

لايه برد و برنامه آزمايشي در c.counter_ui/Src/Application قرار دارد. اين فايل callbackها را به GPIOهاي 32STM متصل، LCD را مقداردهي، جهش كليدها را حذف و مقدار آزمايشي را نمايش مي دهد. c.app فقط يك بار Init_UiCounter و در حلقه Process_UiCounter را فراخواني مي كند. متغير value_counter_ui_g براي مشاهده مستقيم در Watch در دسترس است.

## .۱۷ ۵ راه اندازي چهار بيتي و زمان بندي

پس از پايدارشدن تغذيه، درايور ۵۰ ميلي ثانيه صبر مي كند. سپس 0=RS و 0=W/R شده، نيم بايت هاي شروع چهار بيتي ارسال مي شوند و فرمان 28x0 رابط چهار بيتي، دو سطر و فونت ۵ در ۸ را انتخاب مي كند. بعد نمايش موقتاً خاموش، DDRAM پاك، جهت حركت مكان نما رو به راست و نمايش بدون blink/cursor روشن مي شود.
هر بايت ابتدا نيم بايت بالا و سپس پايين را مي فرستد. callback داده در برد حاضر هر چهار خط را با يك نوشتن رجيستر BSRR عوض مي كند. تمام تأخيرهاي ميكروثانيه از CYCCNT DWT در فركانس ۷۲ مگاهرتز

سامانه پايش و كنترل اتاق آزمون فصل .۱۷ نمايشگر كاراكتري و كليدهاي منو

مي آيند. تنها انتظار نسبتاً بلند، ۵۰ ميلي ثانيه راه اندازي يك باره هنگام بوت است؛ مسير عادي كليدها فاقد

.است HAL_Delay

## .۱۷ ۶ مرجع توابع كتابخانه

| تابع كاربرد
اعتبارسنجي callbackها و هندسه و راه اندازي كنترلر؛ در موفقيت .true | CharacterLcd_Init
پاك كردن DDRAM و رفتن به سطر/ستون صفر؛ براي نوسازي مكرر توصيه نمي شود. | CharacterLcd_Clear
| Home_CharacterLcd بازگشت مكان نما بدون پاك كردن متن.
| SetCursor_CharacterLcd انتخاب ستون و سطر صفرمبنا؛ براي مختصات خارج صفحه false.
نوشتن يك كد؛ نويسه خط جديد به ابتداي سطر بعد مي رود و انتهاي سطر شكسته مي شود. | CharacterLcd_PutChar
| Print_CharacterLcd نوشتن رشته C خاتمه يافته با صفر.
| 32PrintUInt_CharacterLcd تبديل و نمايش عدد بدون sprintf.
| 32PrintInt_CharacterLcd نمايش عدد علامت دار و مديريت امن MIN_32INT.
| SetDisplay_CharacterLcd كنترل نمايش، cursor و blink بدون حذف DDRAM.
| Shift_CharacterLcd جابه جايي پنجره نمايش يك خانه.
نوشتن الگوي ۵ در ۸ در يكي از هشت جايگاه CGRAM و بازگرداندن مكان نما. | CharacterLcd_CreateChar

نمونه ساده:

1 | CharacterLcd_Print(&lcd, "Voltage:");
2 | CharacterLcd_SetCursor(&lcd, 0, 1);
3 | CharacterLcd_PrintUInt32(&lcd, 230);
4 | CharacterLcd_Print(&lcd, " V");

سامانه پايش و كنترل اتاق آزمون فصل .۱۷ نمايشگر كاراكتري و كليدهاي منو

نمونه كاراكتر سفارشي:

1 | static const uint8_t bell[8] = {
2 | 0x04, 0x0E, 0x0E, 0x0E, 0x1F, 0x00, 0x04, 0x00
3 | };
4 | CharacterLcd_CreateChar(&lcd, 0, bell);
5 | CharacterLcd_PutChar(&lcd, 0);

مدل ET جدول كاراكتر انگليسي و اروپايي دارد؛ LCD كاراكتري Unicode و متن فارسي را مانند نمايشگر گرافيكي پشتيباني نمي كند. تنها هشت شكل ۵ در ۸ را مي توان هم زمان در CGRAM تعريف كرد. بنابراين متن رابط فعلي عمداً ASCII است.

## .۱۷ ۷ وقفه كوتاه و حذف جهش كليد

تابع callback وقفه HAL فقط يك بيت در mask_irq_button ثبت مي كند. داخل ISRهيچ نوشتن LCD، تأخير، تبديل رشته، حلقه حذف جهش يا محاسبه برنامه انجام نمي شود. اين پرچم در حلقه اصلي به صورت كوتاه و اتميك برداشته مي شود.
براي هر كليد يك حالت فشار و دو نامزد فشار/رهاسازي نگه داري مي شود. پس از لبه بالارونده، پايه بايد ۳۰ ميلي ثانيه پيوسته در سطح بالا بماند تا فقط يك رخداد ساخته شود. سپس تا زماني كه پايه ۳۰ ميلي ثانيه پيوسته در سطح پايين نشده، همه لبه هاي ناشي از جهش يا نگه داشتن كليد ناديده گرفته مي شوند. نتيجه اين است كه نگه داشتن كليد تكرار خودكار ندارد و هر چرخه كامل فشار/رهاسازي حداكثر يك واحد تغيير مي دهد. اين طراحي از سرريز شمارنده ميلي ثانيه آسيب نمي بيند، زيرا زمان به صورت تفريق بدون علامت مقايسه مي شود. حدگذاري پيش از افزايش/كاهش انجام مي شود و نوع ۸ بيتي هرگز از صد عبور يا زير صفر بازنمي گردد.

## .۱۷ ۸ حفظ LED و كارهاي هم زمان

در هر دور Process_App ابتدا Process_DiagnosticLed و سپس Process_UiCounter اجرا مي شوند
و بعد ماشين حالت دما و نمونه برداري 7880ADE ادامه مي يابد. الگوي LED با شمارنده زمان جلو مي رود و براي LCD يا حذف جهش متوقف نمي شود. تغيير شمارنده فقط سه كاراكتر مي نويسد و فرمان Clear در مسير فشار كليد وجود ندارد.
وقفه هاي كليد با اولويت ۵ فعال اند. بازه هاي كوتاه Wire1- ناحيه بحراني خود را دارند؛ اگر لبه كليد دقيقاً در آن بازه برسد، سخت افزار EXTI آن را معلق نگه مي دارد و پس از بازشدن وقفه ثبت مي شود. حذف جهش سي

سامانه پايش و كنترل اتاق آزمون فصل .۱۷ نمايشگر كاراكتري و كليدهاي منو

ميلي ثانيه اي تأخير چند ميكروثانيه اي را بي اثر مي كند.

## .۱۷ ۹ انتقال به ميكروكنترلر ديگر

فقط پوشه CharacterLcd/Libraries به پروژه مقصد منتقل مي شود. فايل سورس به ساخت و پوشه Inc به مسير هدر افزوده و callbackهاي GPIO و تأخير مقصد نوشته مي شوند:

1 | CharacterLcd_Config config = {
2 | .context = &board,
3 | .write_rs = board_rs,
4 | .write_rw = board_rw, | /* NULL if R/W is tied low */
5 | .write_enable = board_e,
6 | .write_data4 = board_data,
7 | .delay_us = board_delay_us,
8 | .columns = 16,
9 | .rows = 2
10 | };
11 | CharacterLcd_Init(&lcd, &config);

هيچ شماره پايه، رجيستر 32STM يا نمونه سراسري برد در كتابخانه وجود ندارد. براي LCD چهارسطري، جابه جايي هاي رايج 54x14,0x40,0x00,0x0 پشتيباني شده اند؛ ماژولي با نگاشت متفاوت به توسعه كوچك پيكربندي آدرس نياز دارد.

## .۱۷ ۱۰ حفاظت در برابر Code Generate

منطق LCD و حذف جهش بيرون فايل هاي مولد، در Application و Libraries است. فراخواني هاي اصلي از همان Process_App/Init_App موجود در بلوك هاي CODE USER عبور مي كنند. پايه ها و NVIC در IOC ثبت شده اند تا CubeMX بتواند h.main، Init_GPIO_MX و handlerها را دوباره بسازد. پس از هر Code Generate بايد تفاوت گيت كنترل شود، زيرا پروژه حاضر پيش از اين مرحله نيز بخش هايي دست نويس در فايل هاي مولد داشته است. وجود پايه هاي 12PA6..PA و 11PD9..PD، دو IRQ، فراخواني هاي برنامه، مسير هدر كتابخانه و عضويت دو فايل تازه در Keil بايد بررسي شود. فايل هاي ini.platformio و
uvprojx107.F32STM هر دو همگام شده اند.

سامانه پايش و كنترل اتاق آزمون فصل .۱۷ نمايشگر كاراكتري و كليدهاي منو

## .۱۷ ۱۱ روش آزمون روي برد

.۱ پيش از پروگرام، مشترك بودن زمين، اتصال كنتراست، محدودكننده جريان نور پس زمينه و پايين ماندن W/R كنترل شود. سطح منطقي بالا نيز با راهكار مبدل سطح تأييد شود. .۲ پس از روشن شدن، دو متن ثابت و مقدار صفر بايد بدون خانه هاي سياه يا كاراكتر جابه جا ديده شوند. اگر فقط خانه سياه است، ابتدا كنتراست و سپس توالي 7DB4..DB/RS/E بررسي شود. .۳ كليد افزايش يك بار فشرده و رها شود؛ مقدار بايد دقيقاً يك شود. نگه داشتن كليد حداقل دو ثانيه نبايد تغيير ديگري بسازد.
.۴ هر كليد ۵۰ بار با سرعت هاي مختلف آزموده شود؛ هيچ پرش دوواحدي يا فشار گم شده پس از رهاسازي پايدار مجاز نيست.
.۵ مقدار به صد رسانده و ده بار ديگر افزايش داده شود؛ بايد صد بماند. سپس تا صفر كاهش و ده فشار اضافه امتحان شود؛ بايد صفر بماند. .۶ در مقادير مياني كليد بازنشاني آزموده شود. بازنشاني در صفر نيز نبايد چشمك يا پاك شدن صفحه بسازد. .۷ هم زمان دو LED، ms_at_updated.electrical_app_g و داده دما ديده شوند تا توقف سرويس هاي قبلي رد شود.
.۸ آزمون چندساعته در حضور نويز رله انجام و شكل موج تغذيه، E و كليدها ثبت شود. ساخت موفق جاي اين پذيرش سخت افزاري را نمي گيرد.

## .۱۷ ۱۲ عيب يابي و اعتبارسنجي

اگر نمايشگر خالي است، ترتيب بررسي تغذيه و كنتراست، زمين مشترك، سطح منطقي بالا، اتصال W/R، نام پايه ها و پالس E است. نمايش نيم بايت ها يا كاراكترهاي بي معنا معمولاً از جابه جايي 7DB4..DB يا شروع نامعتبر چهار بيتي مي آيد. اگر كليد كار نمي كند، سطح آزاد بايد نزديك صفر و سطح فشار نزديك تغذيه باشد و بيت معلق رجيستر EXTI و handler مشترك كنترل شوند. هر دو سورس تازه با كل پروژه و گزينه هاي Werror- Wextra- Wall- در PlatformIO ساخته شدند. مصرف ساخت اين مرحله ۱۶۵۶۰ بايت Flash و ۳۲۹۲ بايت RAM است. XML پروژه Keil و مسيرهاي سورس/هدر همگام شده اند. اين اعتبارسنجي قرارداد نوع ها، لينك IRQها و حضور فايل ها را ثابت مي كند؛ رفتار واقعي كنتراست، سطح منطقي، ترتيب سيم ها و جهش فقط روي برد قابل تأييد است.

# فصل ۱۸ برنامه نهايي سيكل قطع و وصل بار

## .۱۸ ۱ وضعيت تحويل و مرز اعتبار

اين فصل مرجع رفتار نسخه فعال در تاريخ ۱۱ مهر ،۱۴۰۵ برابر با 2026-10-03 است. فصل هاي پيشين مراحل توسعه و كتابخانه ها را نگه مي دارند؛ تست شمارنده صفر تا صد فصل ۱۷ ديگر برنامه فعال نيست. كاربر عملكرد نمايشگر، كليدها، سيكل رله ها و خواندن و نمايش پارامترهاي الكتريكي را روي برد تأييد كرده است. خط تيره هاي اندازه گيري ناشي از يك مشكل سخت افزاري بود كه كاربر برطرف كرد؛ علت جزئي سخت افزار اعلام نشده است. بازگرداندن مهلت انتقال از ۲ به ۲۰ ميلي ثانيه اصلاح سازگاري نرم افزار است و نبايد علت قطعي آن مشكل تلقي شود.
تأييد كاركرد به معناي كاليبراسيون آزمايشگاهي همه كانال ها يا آزمون طولاني مدت نيست. نسخه جاري آماده ادامه توسعه ظاهر نمايشگر است؛ منطق كنترل و اندازه گيري در اين نوبت تغيير نمي كند.

سامانه پايش و كنترل اتاق آزمون فصل .۱۸ برنامه نهايي سيكل قطع و وصل بار

## .۱۸ ۲ پايه ها و قطبيت خروجي

بخش پايه رفتار نسخه فعال كليد ۱ 9PD افزايش؛ فعال با سطح بالا كليد ۲ 10PD كاهش؛ فعال با سطح بالا كليد ۳ 11PD تأييد كوتاه و ورود يا لغو با نگه داشتن رله نول 1PE صفر: وصل؛ يك: قطع رله فاز 2PE صفر: وصل؛ يك: قطع چراغ ها 14PC13/PC يكي درميان؛ با قطبيت قبلي برد نمايشگر 12PA6..PA همان اتصال چهار بيتي فصل ۱۷ سنجش انرژي 15PB12..PB انتخاب تراشه و گذرگاه 2SPI فصل ۱۵

تابع ()relays هر دو خروجي را با يك نوشتن BSRR GPIOE تغيير مي دهد. هنگام راه اندازي، سطح بالا پيش از خروجي شدن پايه ها نوشته مي شود تا رله ها غير فعال باشند. سطح اوليه در CubeMX نيز بالا ثبت شده است. همزماني فرمان نرم افزار تأييدكننده همزماني مكانيكي كنتاكت ها نيست.

## .۱۸ ۳ توالي صفحات و منوها

در بوت، پيام خوش آمد و سپس com.agfaco.www هر كدام دو ثانيه نمايش داده مي شوند. بعد صفحه اصلي با وضعيت Idle باز مي شود؛ تعداد پيش فرض صفر و مدت پيش فرض روشن و خاموش به ترتيب سه و دو ثانيه است. تست خودكار در بوت آغاز نمي شود.

.۱ نگه داشتن كليد ۳ براي سه ثانيه در صفحه اصلي، منوي تعداد سيكل را باز مي كند. تست جاري متوقف
و هر دو رله قطع مي شوند.
.۲ كليد ۱ مقدار را زياد و كليد ۲ كم مي كند. فشار كوتاه كليد ۳ منوي زمان روشن را باز مي كند. .۳ تأييد زمان روشن، منوي زمان خاموش را باز مي كند. .۴ تأييد زمان خاموش هر سه مقدار را يكجا اعمال و پيام saved Settings را نمايش مي دهد. .۵ فشار كوتاه بعدي كليد ۳ پيام را مي بندد و تست جديد را از سيكل يك شروع مي كند.

سامانه پايش و كنترل اتاق آزمون فصل .۱۸ برنامه نهايي سيكل قطع و وصل بار

تأييد كوتاه هنگام رهاسازي كليد و پس از حذف جهش تشخيص داده مي شود؛ نگه داشتن طولاني، رخداد تأييد كوتاه توليد نمي كند. كليدهاي ۱ و ۲ در صفحه اصلي عمل تنظيمي ندارند. خروج طولاني از تنظيمات در هر يك از سه مرحله، همه تغييرات موقت را لغو مي كند و تست با تنظيمات قبلي از ابتدا شروع مي شود؛ ادامه از وسط سيكل قبلي پياده نشده است.

## .۱۸ ۴ محدوده، جهش گيري و شتاب كليدها

بازه تعداد شامل صفر تا ۱۰۰۰۰۰ و بازه هر مدت شامل صفر تا ۳۰۰ ثانيه است. حذف جهش فشار و رهاسازي به پايداري ۳۰ ميلي ثانيه اي سطح نياز دارد. با تك فشار، تغيير يك واحد است؛ تكرار نگه داشتن پس از ۵۰۰ ميلي ثانيه آغاز و هر ۱۲۰ ميلي ثانيه انجام مي شود. نخستين ۲۰ تغيير، شامل تغيير اوليه فشار، يك واحدي اند و از تغيير بعدي گام پنج واحدي مي شود. رهاكردن و فشار دوباره شتاب را بازنشاني مي كند. عبور از مرز با حساب مدولار روي بازه بسته انجام مي شود: افزايش يك واحد از بيشينه به صفر و كاهش يك واحد
ً | از صفر به بيشينه مي رود. براي گام پنج واحدي، فاصله عبور از مرز هم حفظ مي شود؛ مثلا افزايش پنج واحد از
۹۹۹۹۹ نتيجه سه دارد.

## .۱۸ ۵ اعمال اتمي و نگه داري تنظيمات

آرايه settings سه مقدار اعمال شده و آرايه draft نسخه موقت را نگه مي دارد. ترتيب هر دو، تعداد، زمان روشن و زمان خاموش است. ورود به منو نسخه اعمال شده را كپي مي كند؛ تأييد دو مرحله نخست فقط صفحه را عوض مي كند و هنوز settings تغيير نمي كند. فقط تأييد مرحله سوم كل نسخه موقت را كپي مي كند. ذخيره اين نسخه در RAM است؛ قطع تغذيه يا بازنشاني، تنظيمات را به پيش فرض برمي گرداند. داده نگاشت حسگرهاي دما در صفحه رزروشده Flash مستقل است و براي ذخيره تنظيمات سيكل استفاده نمي شود.

## .۱۸ ۶ سيكل، شمارش معكوس و حالت هاي صفر

مثال تعداد ده، روشن سه ثانيه و خاموش دو ثانيه: سيكل يك با وصل هر دو رله شروع مي شود؛ زمان روشن از سه به صفر مي رود، خروجي ها قطع و زمان خاموش از دو به صفر مي رود. سپس شماره دو و همين توالي تكرار مي شود. پايان مرحله خاموش سيكل ده، خروجي ها را قطع نگه مي دارد و Done نشان مي دهد؛ شماره يازده توليد نمي شود. شماره سيكل افزايشي و زمان هر مرحله كاهشي است. تعداد صفر تست اجرا نمي كند. زمان روشن صفر، هيچ پالس وصلي نمي سازد و تنها مدت خاموش هر سيكل طي

سامانه پايش و كنترل اتاق آزمون فصل .۱۸ برنامه نهايي سيكل قطع و وصل بار

مي شود. زمان خاموش صفر، فاصله خاموش زمان دار ندارد و در مرز سيكل تغيير سريع قطع و وصل رخ مي دهد؛ براي قطع واقعي مكانيكي بايد هر دو مدت مثبت باشند. هر دو مدت صفر، بلافاصله پايان را اعلام مي كنند.

## .۱۸ ۷ چيدمان ۱۶ در ۲ و توسعه ظاهر

1 | V230.1P9999T | 1
2 | A 12.3PF0.98* 3

ستون اول ولتاژ و جريان، ستون وسط توان و قدرمطلق ضريب توان، و ستون راست شماره سيكل و زمان باقي مانده را نشان مي دهد. پيش فرض ولتاژ و جريان يك رقم اعشار، توان بدون اعشار و ضريب توان دو رقم اعشار است. علامت ستاره نشان دهنده وصل و خط تيره نشان دهنده قطع است. مقادير عددي راست چين اند و خانه هاي تغييركرده بدون پاك كردن كل صفحه بازنويسي مي شوند. براي مقدار بزرگ، دقت اعشار ابتدا كاهش مي يابد و سپس پسوندهاي G/M/k استفاده مي شوند؛ عدد از ستون بيرون نمي زند. دو خط تيره يعني داده نامعتبر، كهنه يا ارتباط قطع است؛ صفر واقعي در خواندن موفق به صورت عدد صفر نمايش داده مي شود. براي شماره بزرگ تر از ،۹۹۹۹ شماره شش رقمي در ستون راست دو سطر تقسيم مي شود. 0010T بالا و C 00 پايين يعني سيكل .۰۰۱۰۰۰ سطر پايين هر دو ثانيه ميان ادامه شماره و شمارش زمان يا پيام پايان عوض مي شود؛ ستون هاي اندازه گيري ثابت مي مانند. ظرفيت ۳۲ خانه اجازه نمايش همزمان همه ارقام و همه برچسب ها را نمي دهد.

براي تغيير ظاهر در نوبت بعد، تابع ()compose در _ui/Src/Application107/f32stm/embedded
c.counter محل ساخت دو سطر است. تابع ()number قالب عدد، راست چيني و فشرده سازي مقدار بزرگ را انجام مي دهد. زمان ها، قطبيت، فاز انتخاب شده و اعشار مطلوب در 107/f32stm/embedded
فايل | عضويت | حفظ | براي ui_counter.c | تاريخي | نام . | متمركزند | Application/Inc/cycler_config.h
در پروژه Keil نگه داشته شده است.

## .۱۸ ۸ خواندن موازي و متغيرهاي ديباگر

()Process_App سرويس چراغ ها، رابط كاربر و خواندن انرژي را در حلقه اصلي اجرا مي كند. مبناي زمان SysTick يك ميلي ثانيه اي ميكرو است. انتظار روشن شدن و ريست 7880ADE با ماشين حالت انجام مي شود؛ انتقال SPI همچنان polling HAL با مهلت ۲۰ ميلي ثانيه و نوشتن نمايشگر با مكث هاي كوتاه لازم براي سخت افزار است. اين معماري مشاركتي، تضمين زمان واقعي سخت يا RTOS/DMA ندارد. مهلت مرحله رله

سامانه پايش و كنترل اتاق آزمون فصل .۱۸ برنامه نهايي سيكل قطع و وصل بار

از لبه واقعي محاسبه مي شود تا عقب افتادگي به پالس هاي جبراني متوالي منجر نشود. همه فازها و جريان نول هر ثانيه خوانده مي شوند؛ صفحه پيش فرض فاز A را با واحدهاي W/A/V نشان مي دهد. در خطاي ارتباط، بازيابي پس از دو ثانيه تلاش مي شود. نمايش عدد نيازمند ارتباط فعال، نمونه جديدتر از سه ثانيه و پرچم اعتبار هر كميت است. كتابخانه دما حفظ شده ولي پردازش آن در كاربرد فعلي با 0=TEMPERATURE_ENABLE_CYCLER غيرفعال است؛ چراغ ها در خطاي ارتباط نيز يكي درميان ادامه دارند.

g_app_electrical.voltage_v[0]
g_app_electrical.current_a[0] g_app_electrical.active_power_w[0] g_app_electrical.power_factor_abs[0] g_app_electrical.power_factor[0] g_app_electrical.voltage_valid[0] g_app_electrical.current_valid[0] g_app_electrical.active_power_valid[0] g_app_electrical.power_factor_valid[0] g_app_electrical.online
g_app_electrical.successful_samples g_app_electrical.updated_at_ms g_app_electrical.last_status g_app_electrical.last_error_status g_app_electrical.startup_attempts g_app_electrical.startup_errors g_app_electrical.startup_stage g_app_electrical.failed_startup_stage g_app_electrical.communication_errors
g_app_electrical.raw.phase[0]

انديس صفر، يك و دو به ترتيب فازهاي C/B/A هستند. مقادير نخست ولت، آمپر، وات، قدرمطلق و مقدار علامت دار ضريب توان اند. samples_successful با هر نمونه كامل افزايش مي يابد؛ status_error_last آخرين خطا را در تلاش هاي موفق بعدي هم حفظ مي كند و به تنهايي نشانه خطاي جاري نيست. وضعيت موفق صفر، آرگومان نامعتبر يك، خطاي گذرگاه دو، پايان مهلت سه و عدم تطابق بازخواني چهار است. مرحله هاي راه اندازي به ترتيب صفر: بيكار؛ يك: انتظار تغذيه؛ دو: پالس انتخاب تراشه؛ سه: قفل رابط؛ چهار: درخواست ريست؛ پنج: انتظار پايان ريست؛ شش: شروع پردازنده؛ هفت: خواندن نسخه هستند. براي اشكال يابي، وضعيت فعلي و شمار نمونه ها همراه با آخرين خطا و مرحله شكست بررسي شوند.

سامانه پايش و كنترل اتاق آزمون فصل .۱۸ برنامه نهايي سيكل قطع و وصل بار

## .۱۸ ۹ آزمون ها و نقطه شروع فردا

ساخت PlatformIO با Werror- Wextra- Wall- موفق است: ۱۶۱۸۴ بايت Flash و ۱۰۵۶ بايت RAM.
پروژه Keil از نظر ساختار معتبر است ولي ساخت واقعي در محيط Keil در اين جلسه انجام نشده است.
1 | python embedded/stm32f107/tests/test_cycler.py
2 | python embedded/stm32f107/tests/test_electrical.py

آزمون نخست، كد واقعي كامپايل شده براي ARM را براي منو، حذف جهش، نگه داشتن، شتاب، مرزها، لغو و تأييد اتمي، ده سيكل سه/دو، زمان صفر، سرريز زمان، قطبيت رله و حدود نمايش اجرا مي كند. آزمون دوم، كد كاربرد الكتريكي و درايور واقعي را با مدل رجيستر و انتقال شبيه سازي شده براي راه اندازي، انتشار مقادير كاليبره، خطا و بازيابي بررسي مي كند. وابستگي آن ها unicorn Python و كامپايلر GCC ARM نصب شده PlatformIO است؛ مدل شبيه سازي جاي برد واقعي نيست. شروع نوبت بعد از md.STATUS_PROJECT و همين فصل است. براي تغيير نمايش، ابتدا طرح دو سطر و رفتار اعداد بزرگ تعيين، سپس فقط ()number/()compose يا ثابت هاي نمايش اصلاح و آزمون ها با خروجي جديد هماهنگ شوند. تغيير منو، ذخيره دائمي يا كنترل رله فقط با درخواست جديد انجام شود. كاليبراسيون دقيق، آزمون طولاني مدت و بررسي هاي توليد صنعتي موضوعات مستقل و باز هستند.
