alirezaaies/es-ac-load-cycler/docs/chapters/09-verification-maintenance.tex

\chapter{تأیید، تحویل و نگه‌داری آینده}

\section{آزمون رومیزی بدون بار قدرت}
ابتدا رله‌ها و \lr{SSR}ها را از بار اصلی جدا کنید. سطح خاموش همه خروجی‌ها، کلاک ۷۲ مگاهرتز، نرخ \lr{UART} و انتخاب تراشه \lr{SPI} را با ابزار اندازه‌گیری کنترل کنید. سپس یک حسگر روی هر گذرگاه وصل و شناسه، دمای خام و دمای محیط را با دماسنج مرجع مقایسه کنید.

\section{آزمون پروتکل}
برای هر فرمان یک قاب دقیق ۱۲ بایتی بفرستید و اثر خروجی را ثبت کنید. قاب ۲۰۹ بایتی را از نظر سرآیند، انتها، طول، ترتیب کم‌ارزش‌ترین بایت و جایگاه هر حسگر بررسی کنید. سناریوهای قطع کابل، بایت گمشده، فرمان نامعتبر و توقف نرم‌افزار رایانه نیز باید آزموده شوند.

\section{آزمون کنترل}
با بار شبیه‌ساز، نقاط پایین، داخل و بالای هیسترزیس دما و رطوبت را اعمال کنید. گذار خودکار به دستی و برعکس، بازنشانی، قطع حسگر و بازیابی برق را ثبت کنید. شمارنده استارت باید تنها روی لبه خاموش به روشن افزایش یابد. سپس حداقل زمان مجاز کمپرسور طبق سازنده به آزمون اضافه شود.

\section{معیار پذیرش نسخه}
\begin{itemize}
  \item ساخت \lr{Keil} و \lr{PlatformIO} بدون خطا انجام شود.
  \item اندازه کد از مرز
\lr{0x0803F800}
عبور نکند.
  \item تولید مجدد \lr{CubeMX} هیچ کد کاربردی را حذف نکند.
  \item خاموشی ایمن هنگام راه‌اندازی، خطا و
\lr{AUTOFF}
تأیید شود.
  \item همه نگاشت‌های شماره‌گذاری‌شده پس از قطع برق سالم بازیابی و \lr{CRC} رکورد و \lr{ROM} آن‌ها تأیید شود.
  \item نرم‌افزار رایانه قاب جدید را بدون تغییر تفسیر کند.
\end{itemize}

\section{اولویت‌های توسعه بعدی}
بازنویسی قابل‌حمل \lr{1-Wire}، تبدیل هم‌زمان، کنترل \lr{CRC} و شماره‌گذاری پایدار انجام شده است. اولویت بعدی آزمون سخت‌افزاری این مسیر با تعداد و کابل واقعی، سپس پروتکل نسخه‌دار با \lr{CRC} و پاسخ، ماشین حالت حفاظت کمپرسور، واچ‌داگ، گزارش خطای حسگر و تست واحد میزبان است. پس از دریافت شماتیک می‌توان نام و وضعیت پایه‌های ناشناخته را قطعی و ماژول‌های بلااستفاده را حذف یا فعال کرد.

\section{قاعده نگه‌داری سند}
هر تغییر رفتاری باید هم‌زمان در فصل مربوط، فایل وضعیت ریشه، شماره نسخه پروتکل و فهرست آزمون ثبت شود. نتیجه آزمون سخت‌افزاری نباید از روی موفقیت کامپایل استنتاج شود. فایل وضعیت پروژه نقطه شروع هر عامل انسانی یا هوش مصنوعی برای ادامه کار است.
