alirezaaies/es-ac-load-cycler/(list of files, drawings)

Other design files:
hardware/altium/Analog_Input.SchDoc
hardware/altium/Communication.SchDoc
hardware/altium/Digital_Input.SchDoc
hardware/altium/Main.SchDoc
hardware/altium/MainPCB1.PcbLib
hardware/altium/MainPCB.PcbDoc
hardware/altium/Outputs.SchDoc
hardware/altium/PCB_Project.PrjPcb
hardware/altium/PcbLib1.PcbLib
hardware/altium/Power.SchDoc
hardware/altium/PowerMeter.SchDoc
hardware/altium/push-button.PcbLib
