alirezaaies/es-ac-load-cycler/(commit log)

2026-09-16 feat: integrate portable ADE7880 measurement driver
2026-09-16 fix: persist ADE7880 SPI polarity in CubeMX
    [STM32F107.ioc]
2026-09-16 feat: document ADE7880 API and publish voltage values
2026-09-16 docs: explain ADE7880 API and voltage calibration
2026-09-16 fix: enable HAL DMA types for Keil build
2026-09-16 feat: publish ADE7880 current power and PF
2026-09-16 docs: explain ADE7880 current power and PF workflow
2026-09-16 fix: load legacy ADE7880 current and power scales
    [app.c]
2026-09-16 fix: correct ADE7880 units and CT polarity
    [app.c]
2026-09-16 feat: add configurable units and multipoint calibration
2026-09-16 docs: add ADE7880 calibration workflow
2026-09-16 feat: enable default calibration for all phases
2026-09-16 docs: document complete three-phase calibration
2026-09-16 fix: finalize ADE7880 runtime state and git hygiene
    [app.c]
2026-09-19 chore: organize unified firmware and hardware repository
    [Analog_Input.SchDoc, Communication.SchDoc, Digital_Input.SchDoc, Main.SchDoc, MainPCB.PcbDoc, MainPCB1.PcbLib, Outputs.SchDoc, PCB_Project.PrjPcb]
2026-09-19 refactor: automate DS18B20 sensor registration
2026-09-19 docs: record current project handoff
2026-09-23 feat: add character LCD and debounced button UI
2026-10-03 feat: implement configurable AC load cycling with active-low phase and neutral relays
    Add transactional three-stage settings, accelerated buttons, synchronized PE1/PE2 switching, cycle countdowns and electrical LCD readings. Keep libraries and alternating LEDs, and schedule ADE startup cooperatively.
    Use LOW to energize both relays and HIGH to release them, including startup and CubeMX defaults. Document operation and include ARM-emulated regression tests for timing, menus, display bounds and output polarity.
2026-10-03 fix: restore ADE7880 SPI timeout and expose electrical startup failures
    Restore the established 20 ms transfer budget after the cycler refactor reduced it to 2 ms. Retain startup failure stage, error status and retry counters for debugger diagnosis; publish sample timestamps after complete acquisition.
    Add ARM regressions covering actual ADE transport, calibrated electrical readings, startup errors and communication recovery, plus LCD stale/offline behavior. Hardware confirmation remains pending.
    [app.c, test_cycler.py, test_electrical.py]
2026-10-03 docs: finalize hardware-confirmed load cycler report and next-session handoff
    Record the user's confirmation that menus, active-low relays and electrical readings work after a hardware repair. Replace the stale current summary with complete operating behavior, debugger expressions and LCD customization entry points.
    Add report chapter 18 for the active application, distinguish historical examples, update document version to 1.1 and regenerate the visually reviewed 97-page PDF. Record passing firmware build and ARM regressions and remaining follow-up work.
